Achille-92/CRAC2026/Algorithmes/Camera/MaVersion/calibration_images/WIN_20251208_12_06_43_Pro.jpg

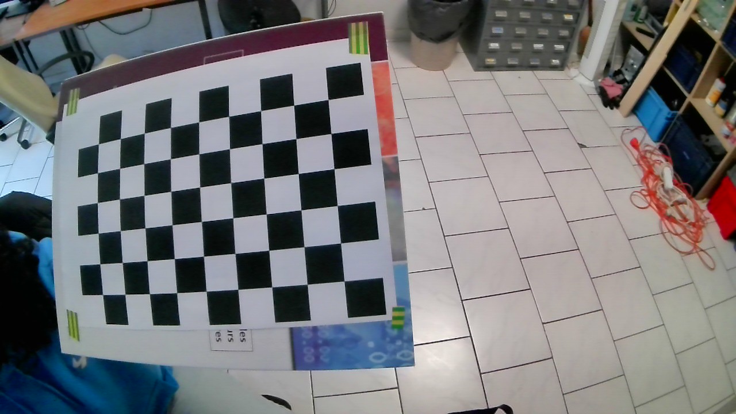
Algorithmes/Camera/MaVersion/calibration_images/WIN_20251208_12_06_43_Pro.jpg
