Achille-92/CRAC2026/Carte_Alim/Prog_Carte_puissance_crac/README.md

## Rapport

[Rapport_ERS3_Bryan_ZHANG.pdf](https://github.com/user-attachments/files/18724378/Rapport_ERS3_Bryan_ZHANG.pdf)

## KiCad de la carte

https://drive.google.com/file/d/13JI4LmcO5JpdWw6Ys9MJsPXT3uxtk39C/view?usp=drive_link
