Achille-92/CRAC2026/Autre/RPI/Piste.png

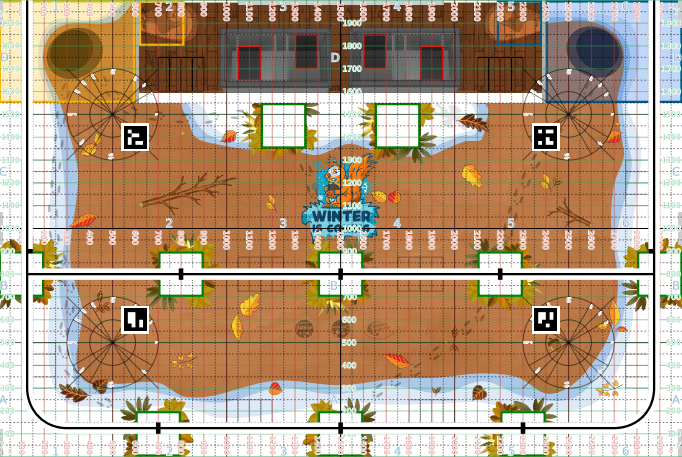
Autre/RPI/Piste.png
