Achille-92/CRAC2026/Carte_Alim/Prog_Carte_puissance_crac/Kicad Carte_puissance_crac_Indus/ALTIUM_EMBEDDED_MODELS/User Library-SOIC-8-1.STEP

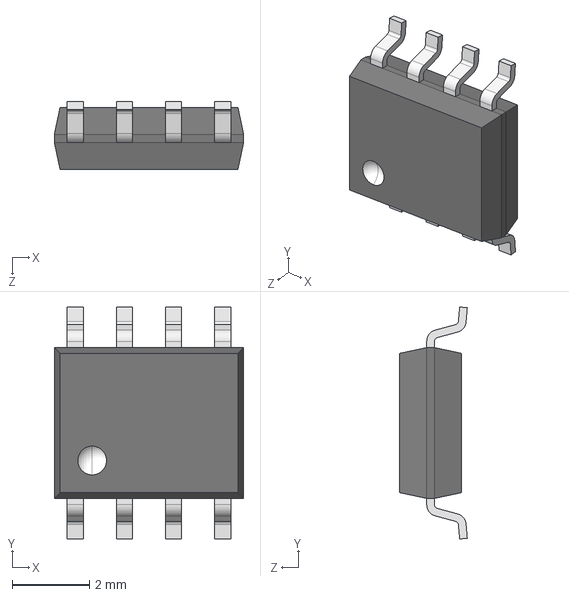
[picture p29: CAD file, 2026-09-27]
Carte_Alim/Prog_Carte_puissance_crac/Kicad Carte_puissance_crac_Indus/ALTIUM_EMBEDDED_MODELS/User Library-SOIC-8-1.STEP
4.90 x 6.00 x 1.75 mm
