Achille-92/CRAC2026/Carte_Alim/Prog_Carte_puissance_crac/Kicad Carte_puissance_crac_Indus/lib_TSR-2-2450/3D/TSR_2-2450.step

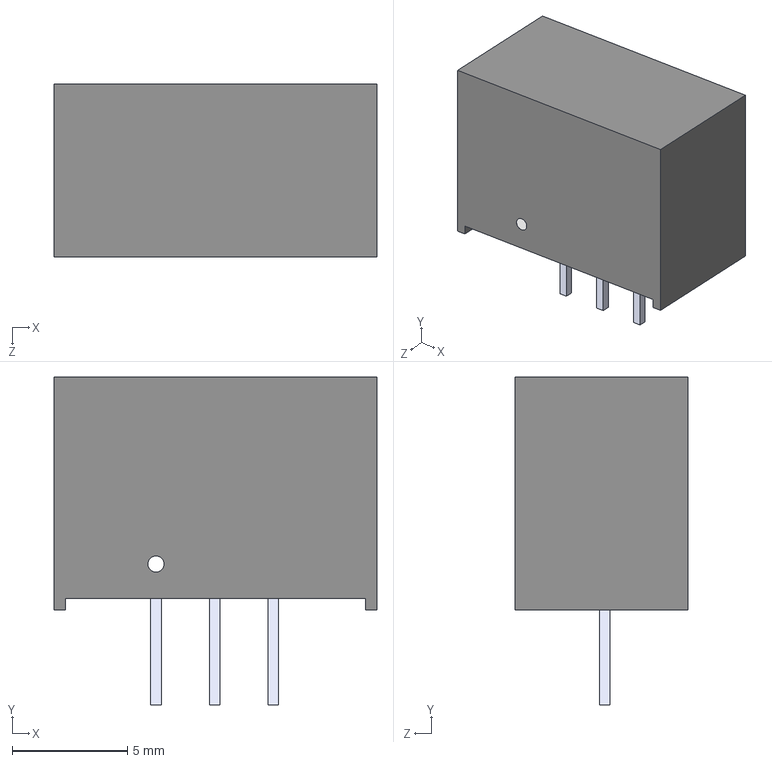
[picture p30: CAD file, 2026-09-29]
Carte_Alim/Prog_Carte_puissance_crac/Kicad Carte_puissance_crac_Indus/lib_TSR-2-2450/3D/TSR_2-2450.step
14.0 x 14.2 x 7.50 mm
