Achille-92/CRAC2026/Carte_Alim/Prog_Carte_puissance_crac/Kicad Carte_puissance_crac_Indus/LibGamelGe2_v6/3D/LED5mm_green.STEP

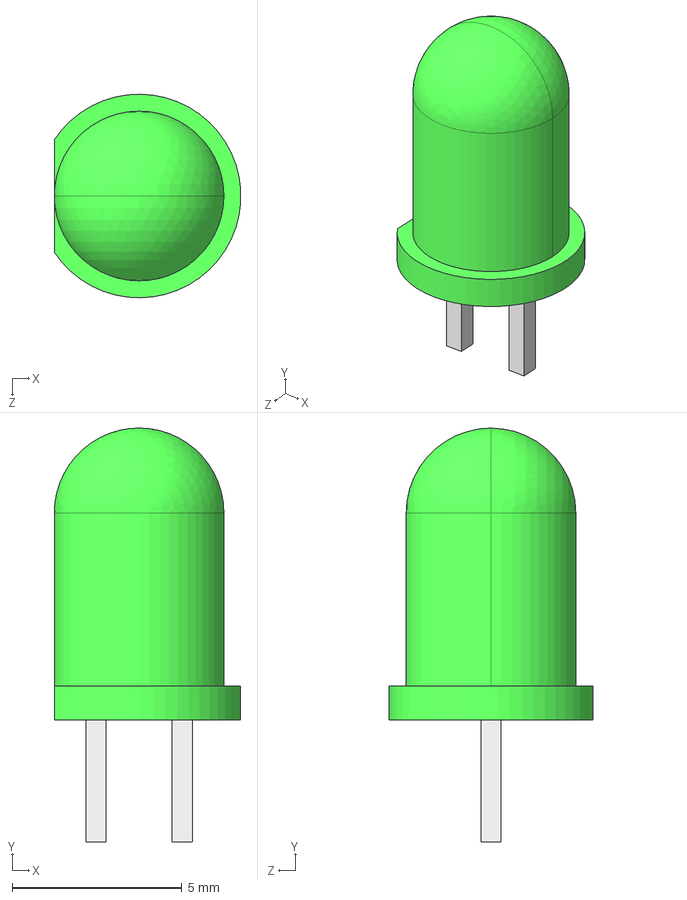
[picture p31: CAD file, 2026-09-27]
Carte_Alim/Prog_Carte_puissance_crac/Kicad Carte_puissance_crac_Indus/LibGamelGe2_v6/3D/LED5mm_green.STEP
5.49 x 12.2 x 6.00 mm
