Achille-92/CRAC2026/Carte_Alim/Prog_Carte_puissance_crac/Kicad Carte_puissance_crac_Indus/LibGe2/3D/pololu-2507.STEP

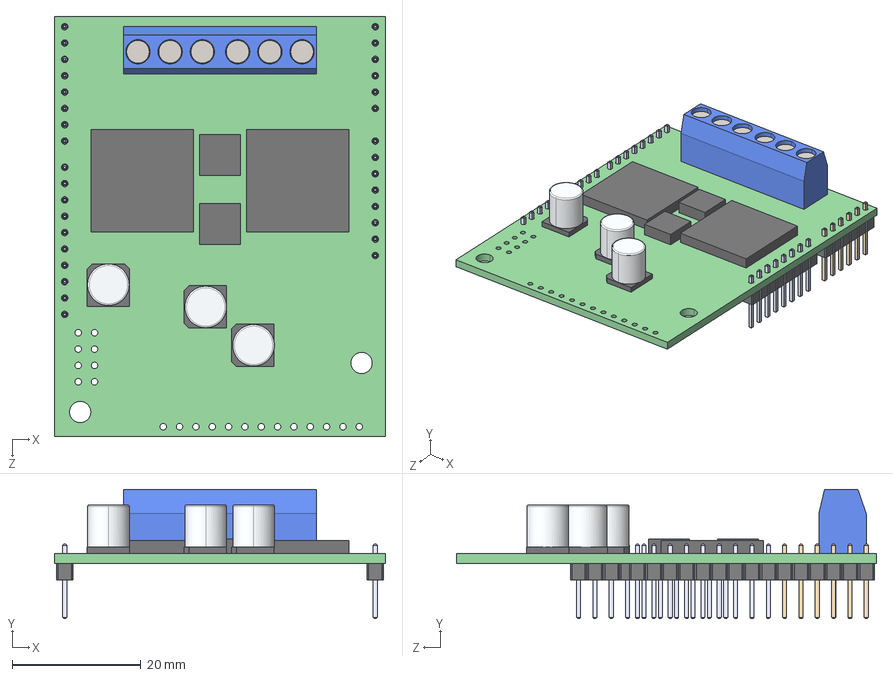
[picture p32: CAD file, 2026-09-27]
Carte_Alim/Prog_Carte_puissance_crac/Kicad Carte_puissance_crac_Indus/LibGe2/3D/pololu-2507.STEP
51.4 x 20.0 x 65.3 mm
Pololu VNH5019 Motor Driver
PinHeader_1x06_P2.54mm_Vertical.step
PinHeader_1x08_P2.54mm_Vertical.step x 2
PinHeader_1x10_P2.54mm_Vertical.step
