Achille-92/CRAC2026/Carte_Alim/Prog_Carte_puissance_crac/Kicad Carte_puissance_crac_Indus/SQM40031EL_GE3/TO-236_D2PAK__VIS.step

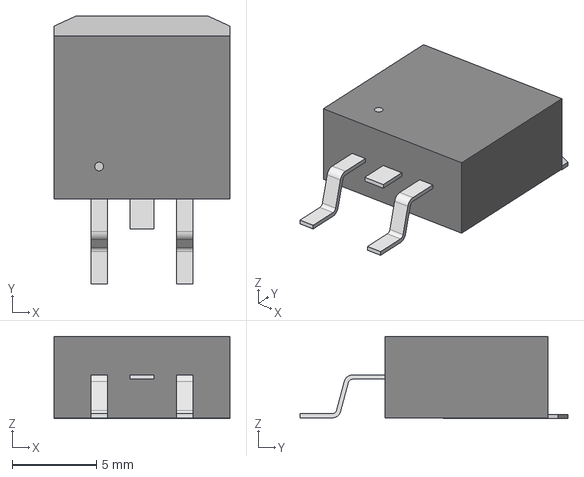
[picture p33: CAD file, 2026-09-29]
Carte_Alim/Prog_Carte_puissance_crac/Kicad Carte_puissance_crac_Indus/SQM40031EL_GE3/TO-236_D2PAK__VIS.step
10.4 x 15.9 x 4.88 mm
