Achille-92/CRAC2026/Carte_Alim/Prog_Carte_puissance_crac/Kicad Carte_puissance_crac_Indus/STM32F303K8T6/STM32F303K8T6.step

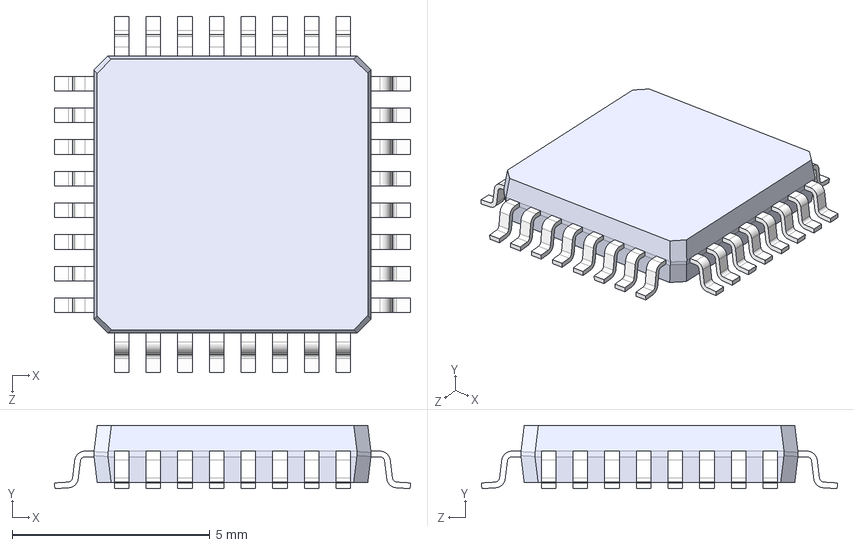
[picture p34: CAD file, 2026-09-27]
Carte_Alim/Prog_Carte_puissance_crac/Kicad Carte_puissance_crac_Indus/STM32F303K8T6/STM32F303K8T6.step
9.00 x 1.60 x 9.00 mm
