Achille-92/CRAC2026/Carte_Alim/Prog_Carte_puissance_crac/Kicad Carte_puissance_crac_Indus/STSPIN820/STSPIN820.step

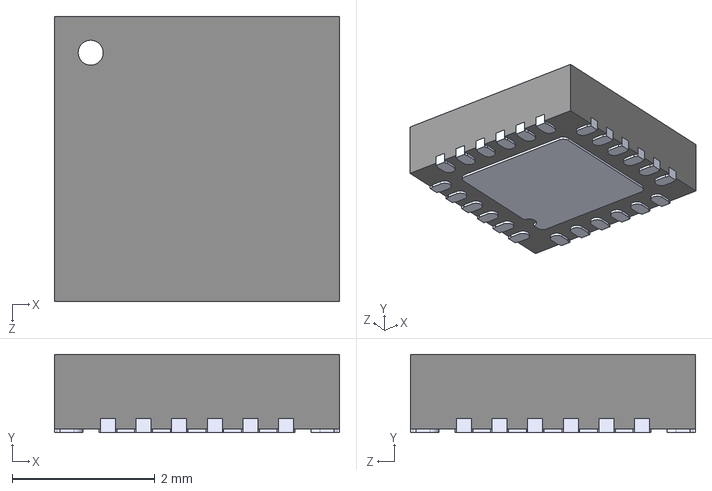
[picture p35: CAD file, 2026-09-27]
Carte_Alim/Prog_Carte_puissance_crac/Kicad Carte_puissance_crac_Indus/STSPIN820/STSPIN820.step
4.00 x 1.10 x 4.00 mm
