Achille-92/CRAC2026/Prog_Actionneurs/Kicad/CarteMPPIndus/EVALSP820-XS--3DModel-STEP-269445.STEP

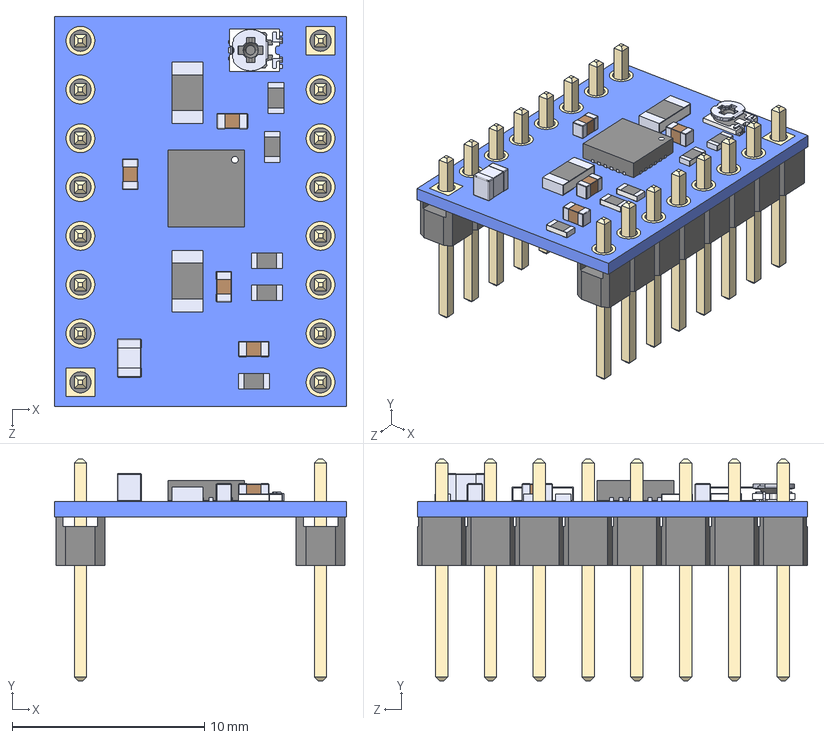
[picture p36: CAD file, 2026-09-27]
Prog_Actionneurs/Kicad/CarteMPPIndus/EVALSP820-XS--3DModel-STEP-269445.STEP
15.2 x 11.5 x 20.3 mm
EVALSP820-XS board
STSPIN820_STSPIN820
61300811121.stp x 2
6130xx11121_PIN.stp x 16
TC42X-2-103E
Cap_GA0805Y473JBAAR31G
cap2 x 2
cap2_FC0603E50R0BTBT1 x 5
Cap_VJ0603Q3R9BXBAP x 4
