Achille-92/CRAC2026/Prog_Actionneurs/Kicad/Extension_Pompes/Extension_Pompes.step

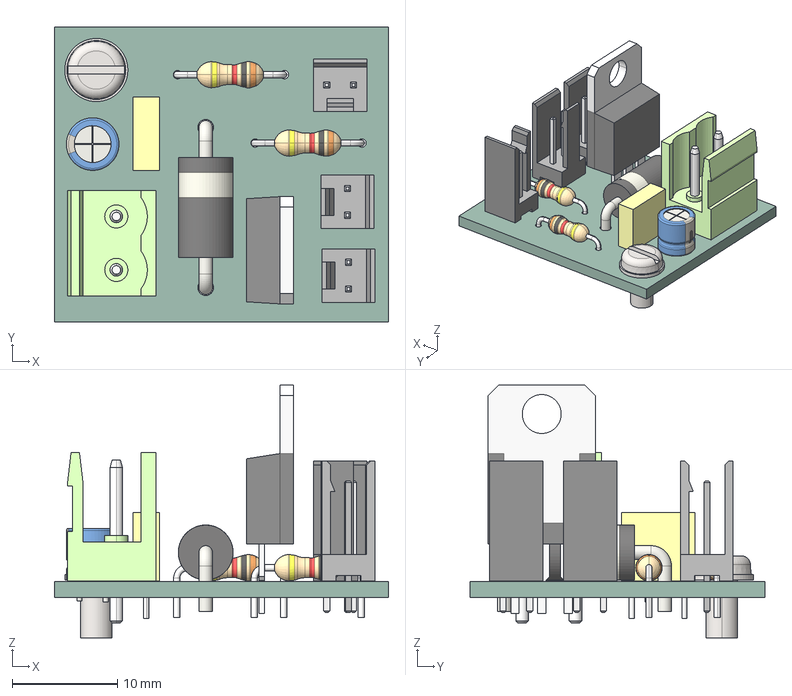
[picture p37: CAD file, 2026-09-27]
Prog_Actionneurs/Kicad/Extension_Pompes/Extension_Pompes.step
31.8 x 28.1 x 24.0 mm
C_Rect_L7.0mm_W2.5mm_P5.00mm
OmnimateSL_1x02
slotted pan head screw_iso_ISO 1580 - M3 x 6 - 6N
plain washer small grade a_iso_Washer ISO 7092 - 3
D_DO-201AD_P15.24mm_Horizontal
autocom2 x 3
CP_Radial_D5.0mm_P2.50mm
R_Axial_L6.3mm_D2.5mm_P10.16mm_Horizontal x 2
TO220_vertical
Extension_Pompes_PCB
