Achille-92/CRAC2026/Carte_Alim/Prog_Carte_puissance_crac/Kicad Carte_puissance_crac_Indus/ALTIUM_EMBEDDED_MODELS/SW3dPS-SOT-223-1.STEP

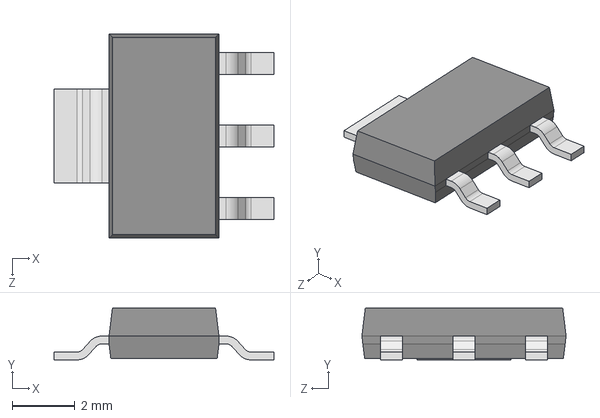
[picture p38: CAD file, 2026-09-27]
Carte_Alim/Prog_Carte_puissance_crac/Kicad Carte_puissance_crac_Indus/ALTIUM_EMBEDDED_MODELS/SW3dPS-SOT-223-1.STEP
7.00 x 1.65 x 6.50 mm
