Achille-92/CRAC2026/Carte_Alim/Prog_Carte_puissance_crac/Kicad Carte_puissance_crac_Indus/LibGamelGe2_v6/3D/R_Axial_L6.3mm_D2.5mm_P10.16mm_Horizontal.STEP

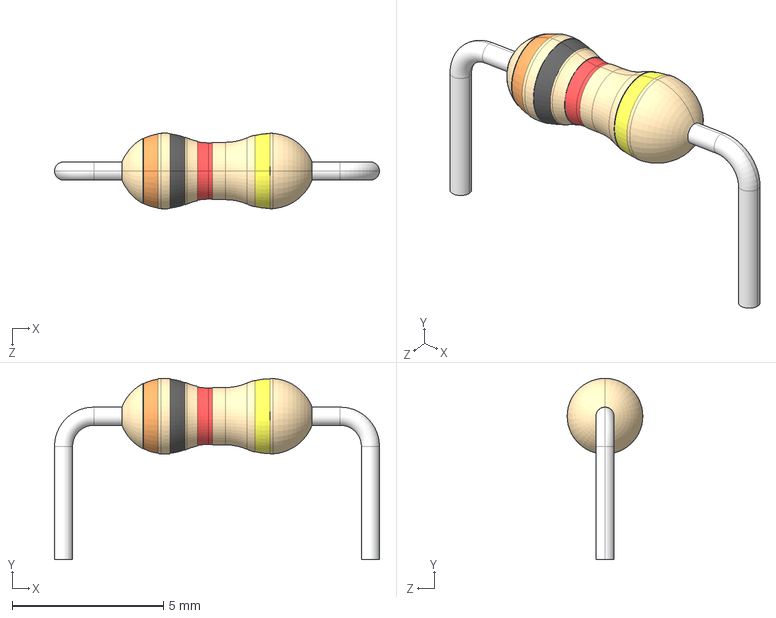
[picture p39: CAD file, 2026-09-27]
Carte_Alim/Prog_Carte_puissance_crac/Kicad Carte_puissance_crac_Indus/LibGamelGe2_v6/3D/R_Axial_L6.3mm_D2.5mm_P10.16mm_Horizontal.STEP
10.8 x 6.00 x 2.51 mm
