Achille-92/CRAC2026/Prog_Actionneurs/Kicad/CarteMPPIndus/CarteMPP.step

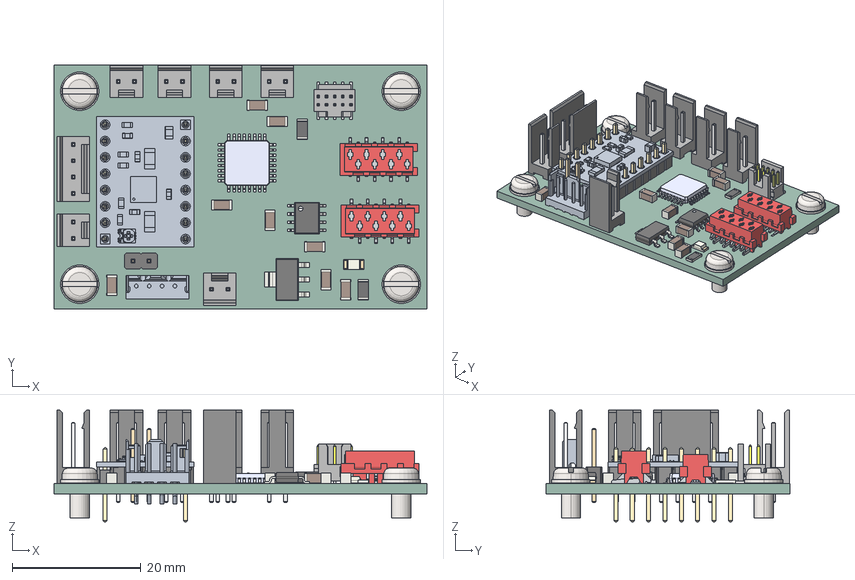
[picture p40: CAD file, 2026-09-27]
Prog_Actionneurs/Kicad/CarteMPPIndus/CarteMPP.step
58.0 x 38.0 x 17.4 mm
SOT_223
C_1206_3216Metric x 8
User Library-SOIC-8-1
C-0188275-08-3 x 2
PinHeader_1x02_P254mm_Vertical
Screw_3mm x 4
autocom2 x 6
R_1206_3216Metric x 2
LED_1206_3216Metric
autocom4
EVALSP820-XS
STM32L011K4T6
FTSH-105-01-L-DV-K
CarteMPP_PCB
