Achille-92/CRAC2026/Carte_Alim/Prog_Carte_puissance_crac/Kicad Carte_puissance_crac_Indus/ALTIUM_EMBEDDED_MODELS/0603 SMD Resistor.stp

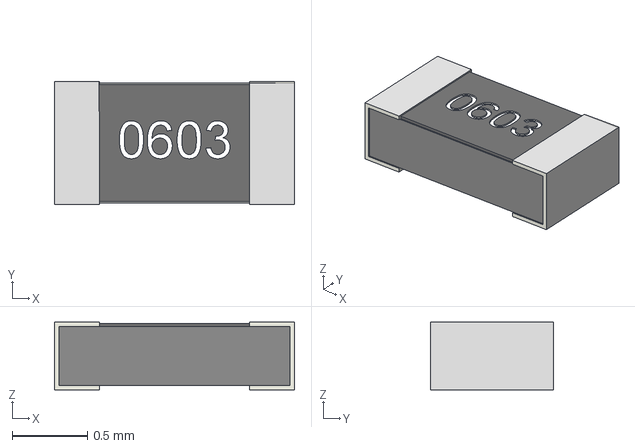
[picture p41: CAD file, 2026-09-27]
Carte_Alim/Prog_Carte_puissance_crac/Kicad Carte_puissance_crac_Indus/ALTIUM_EMBEDDED_MODELS/0603 SMD Resistor.stp
1.60 x 0.82 x 0.45 mm
