Achille-92/CRAC2026/Carte_Alim/Prog_Carte_puissance_crac/Kicad Carte_puissance_crac_Indus/LibGamelGe2_v6/3D/autocom2.STEP

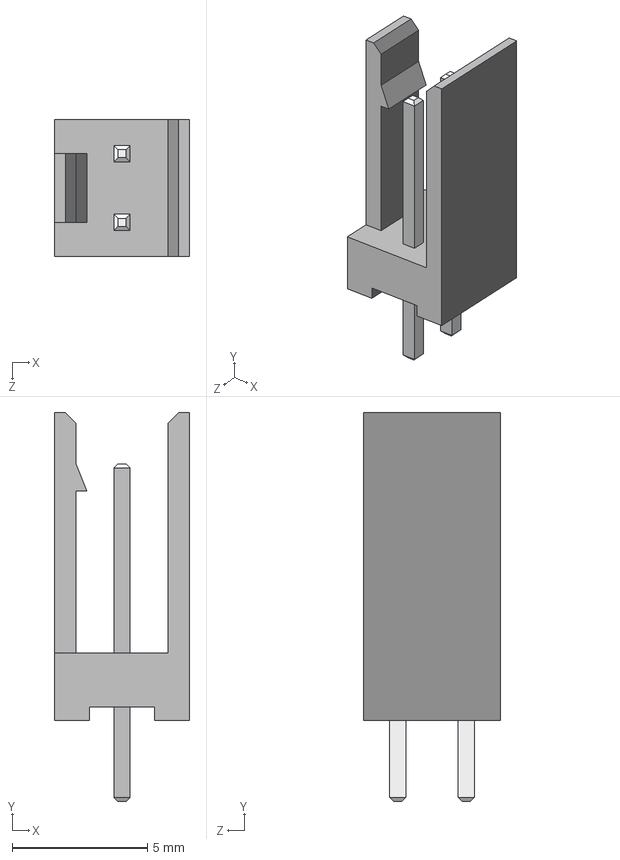
[picture p42: CAD file, 2026-09-27]
Carte_Alim/Prog_Carte_puissance_crac/Kicad Carte_puissance_crac_Indus/LibGamelGe2_v6/3D/autocom2.STEP
5.00 x 14.4 x 5.08 mm
