Achille-92/CRAC2026/Carte_Alim/Prog_Carte_puissance_crac/Solidwork Boite carte puissance/Carte_puissance_crac_v2.step

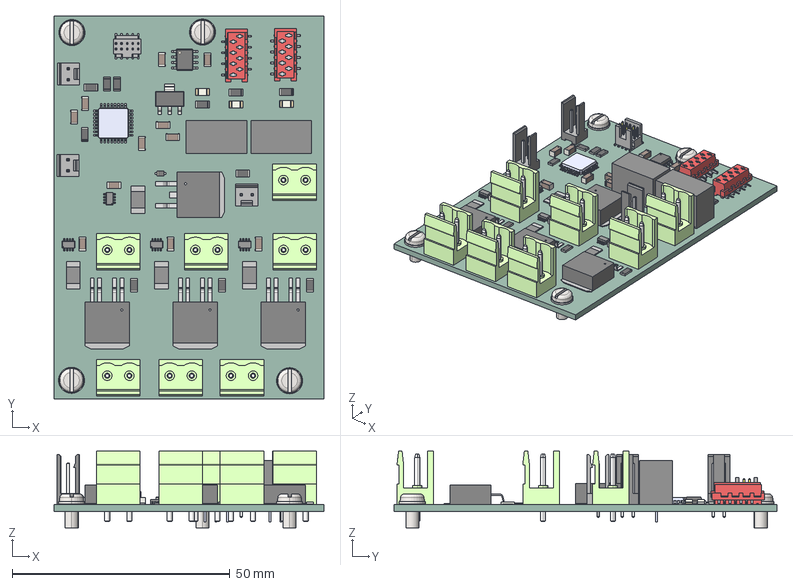
[picture p43: CAD file, 2026-09-29]
Carte_Alim/Prog_Carte_puissance_crac/Solidwork Boite carte puissance/Carte_puissance_crac_v2.step
62.0 x 88.0 x 17.6 mm
R_1206_3216Metric x 11
Screw_3mm x 4
ASSEMBLY x 4
C_1206_3216Metric x 11
SOIC_8_39x49mm_P127mm
TSR 2-2450 x 2
C-0188275-08-3 x 2
autocom2 x 3
OmnimateSL_1x02 x 7
FTSH-105-01-L-DV-K
CSNL2512_5L00 x 4
D_SOD_323F
SOT_223
LED_1206_3216Metric x 3
STM32L011K4T6
Carte_puissance_crac_v2_PCB
