Achille-92/CRAC2026/Carte_Alim/Prog_Carte_puissance_crac/Kicad Carte_puissance_crac_Indus/ALTIUM_EMBEDDED_MODELS/LED 0603.STEP

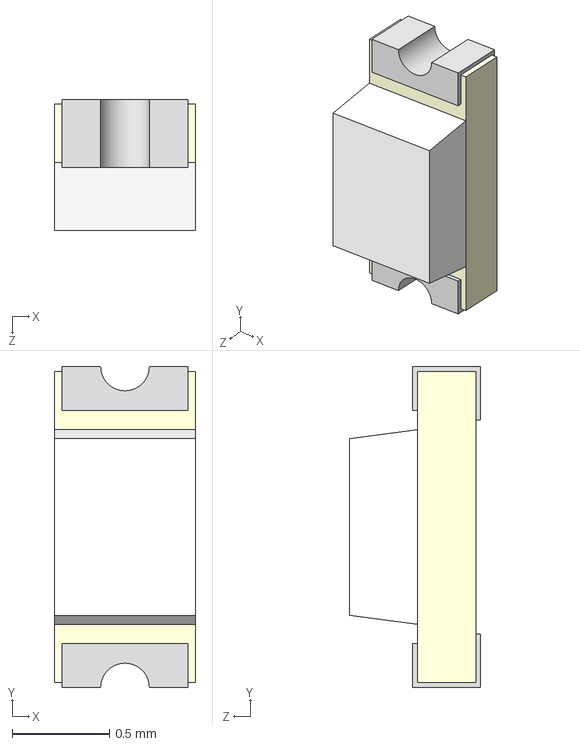
[picture p44: CAD file, 2026-09-27]
Carte_Alim/Prog_Carte_puissance_crac/Kicad Carte_puissance_crac_Indus/ALTIUM_EMBEDDED_MODELS/LED 0603.STEP
0.725 x 1.65 x 0.675 mm
