Achille-92/CRAC2026/Carte_Alim/Prog_Carte_puissance_crac/Kicad Carte_puissance_crac_Indus/LibGamelGe2_v6/3D/Potentiometer_Vertical.STEP

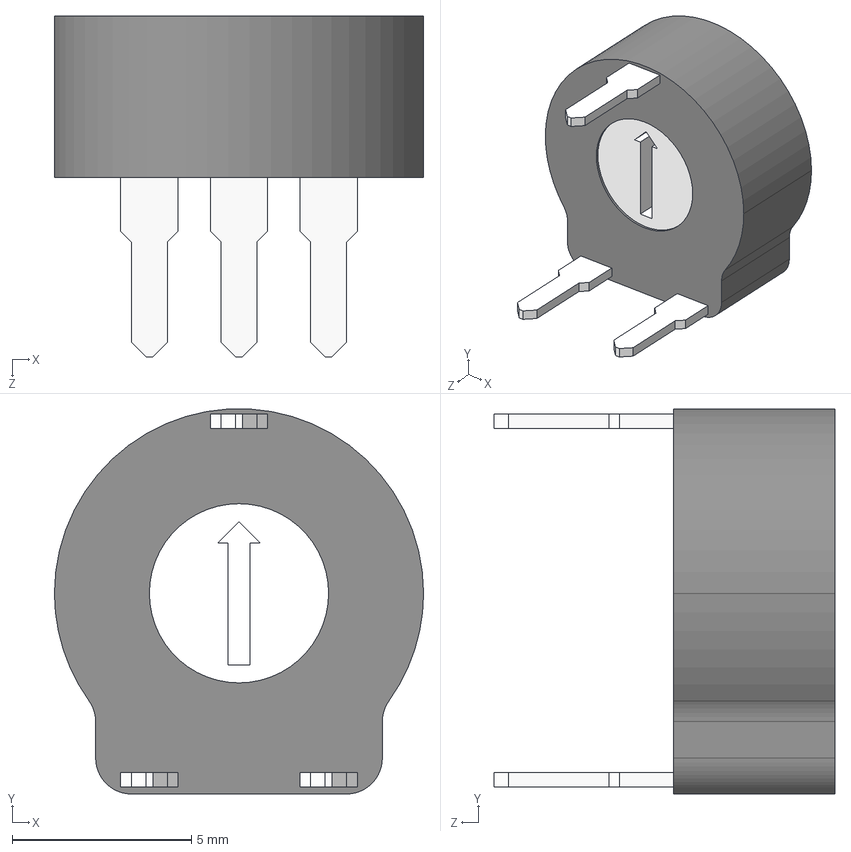
[picture p45: CAD file, 2026-09-27]
Carte_Alim/Prog_Carte_puissance_crac/Kicad Carte_puissance_crac_Indus/LibGamelGe2_v6/3D/Potentiometer_Vertical.STEP
10.3 x 10.7 x 9.50 mm
