Achille-92/CRAC2026/Carte_Alim/Prog_Carte_puissance_crac/Kicad Carte_puissance_crac_Indus/LibGe2/3D/Grove Connector (flat).STEP

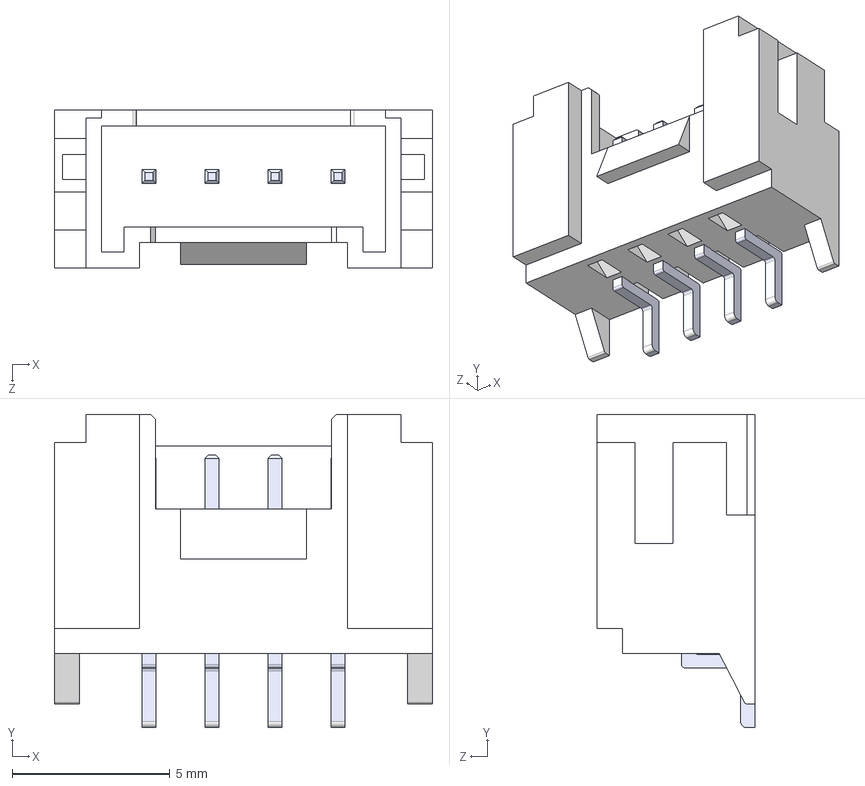
[picture p46: CAD file, 2026-09-27]
Carte_Alim/Prog_Carte_puissance_crac/Kicad Carte_puissance_crac_Indus/LibGe2/3D/Grove Connector (flat).STEP
12.0 x 9.95 x 5.00 mm
