Achille-92/CRAC2026/Carte_Alim/Prog_Carte_puissance_crac/Solidwork Boite carte puissance/Boitier_Carte_puissance.SLDPRT

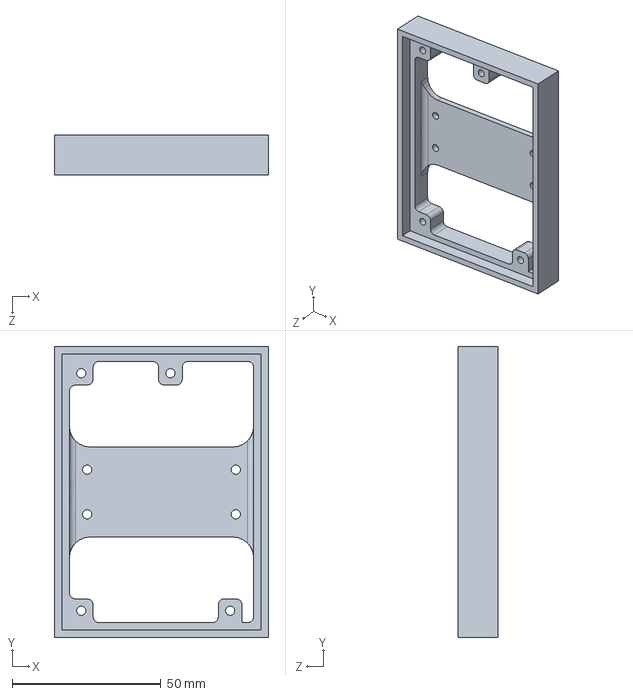
[picture p47: CAD file, 2026-09-29]
Carte_Alim/Prog_Carte_puissance_crac/Solidwork Boite carte puissance/Boitier_Carte_puissance.SLDPRT
72.0 x 97.9 x 13.4 mm
