Achille-92/CRAC2026/Carte_Alim/Prog_Carte_puissance_crac/Kicad Carte_puissance_crac_Indus/ALTIUM_EMBEDDED_MODELS/Embase Micromatch Femelle CMS 8pts.stp

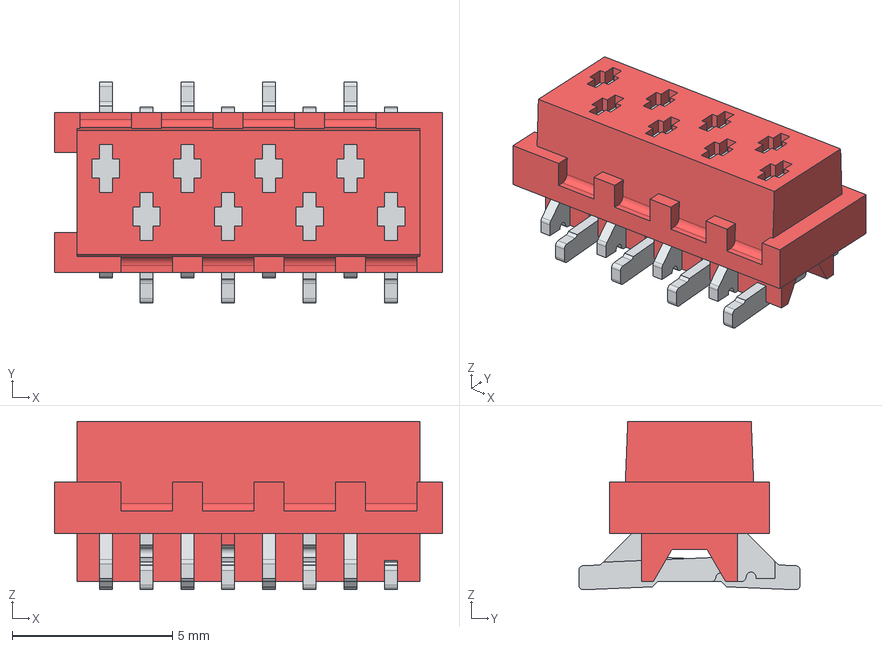
[picture p48: CAD file, 2026-09-27]
Carte_Alim/Prog_Carte_puissance_crac/Kicad Carte_puissance_crac_Indus/ALTIUM_EMBEDDED_MODELS/Embase Micromatch Femelle CMS 8pts.stp
12.1 x 6.90 x 5.25 mm
