Achille-92/CRAC2026/Carte_Alim/Prog_Carte_puissance_crac/Kicad Carte_puissance_crac_Indus/LibGamelGe2_v6/3D/autocom4.STEP

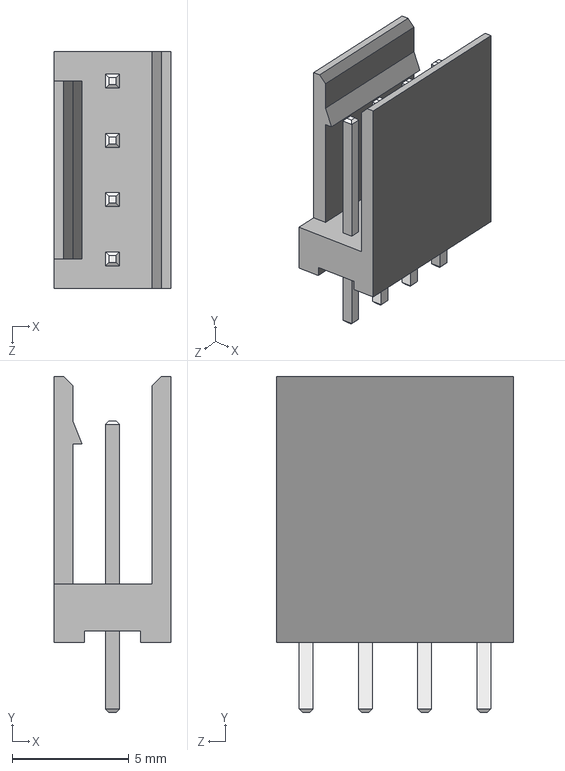
[picture p49: CAD file, 2026-09-27]
Carte_Alim/Prog_Carte_puissance_crac/Kicad Carte_puissance_crac_Indus/LibGamelGe2_v6/3D/autocom4.STEP
5.00 x 14.4 x 10.2 mm
