Achille-92/CRAC2026/Carte_Alim/Prog_Carte_puissance_crac/Kicad Carte_puissance_crac_Indus/LibGe2/3D/ESP32-DEVKITC-32D.step

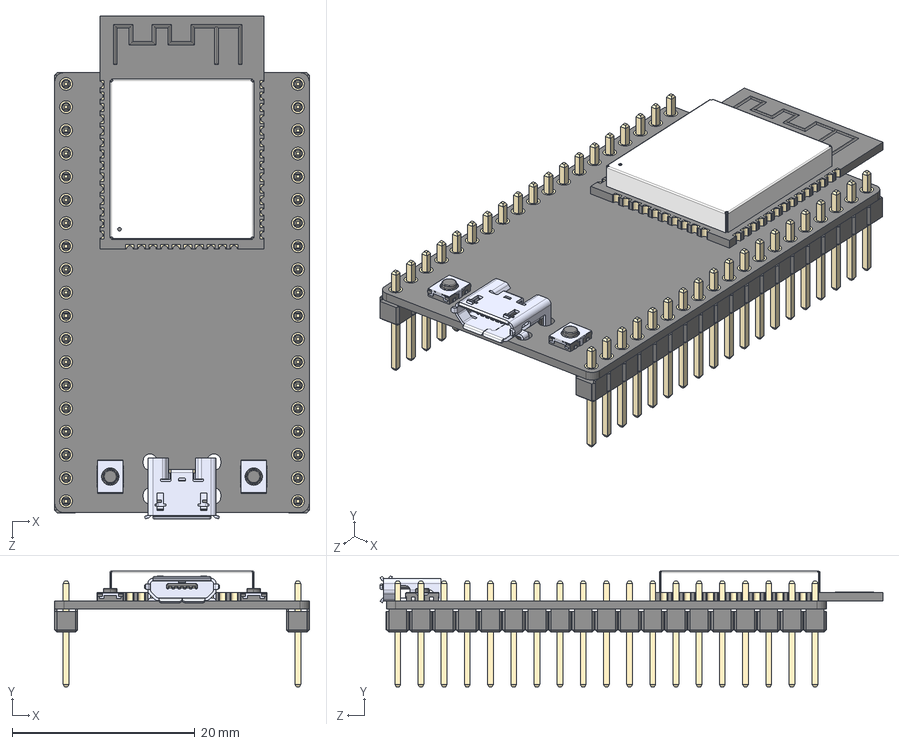
[picture p50: CAD file, 2026-09-27]
Carte_Alim/Prog_Carte_puissance_crac/Kicad Carte_puissance_crac_Indus/LibGe2/3D/ESP32-DEVKITC-32D.step
27.9 x 12.7 x 55.1 mm
board
header x 2
ESP32-WROOM-32D
micro usb
button x 2
