Achille-92/CRAC2026/Carte_Alim/Prog_Carte_puissance_crac/Kicad Carte_puissance_crac_Indus/LibGe2/3D/Grove Connector (standing).STEP

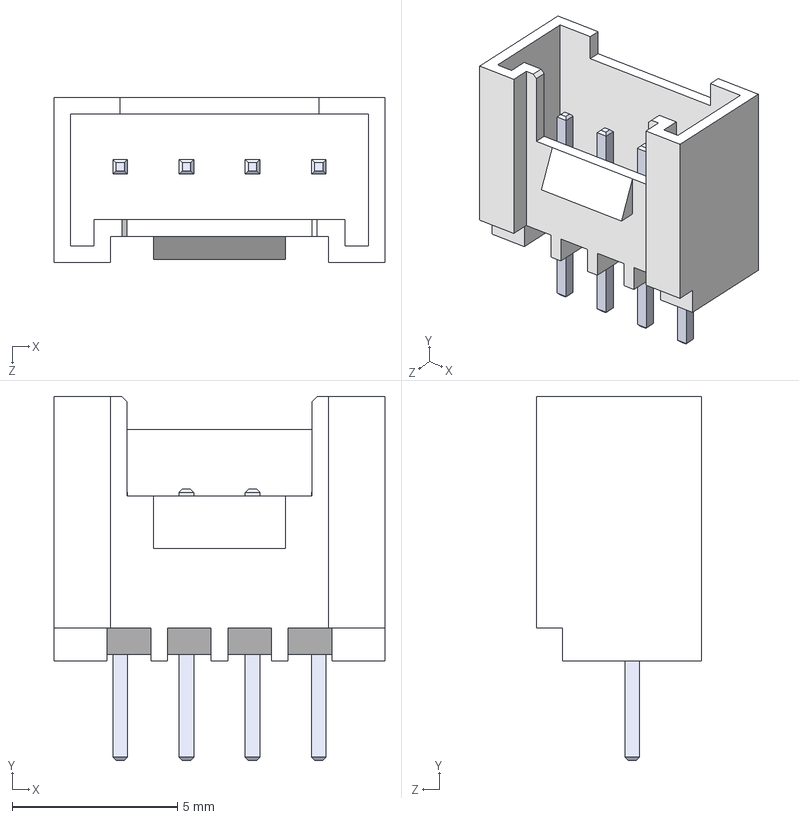
[picture p53: CAD file, 2026-09-27]
Carte_Alim/Prog_Carte_puissance_crac/Kicad Carte_puissance_crac_Indus/LibGe2/3D/Grove Connector (standing).STEP
10.0 x 11.0 x 5.00 mm
