Achille-92/CRAC2026/Carte_Alim/Prog_Carte_puissance_crac/Kicad Carte_puissance_crac_Indus/LibGe2/3D/THN_15-1211N.step

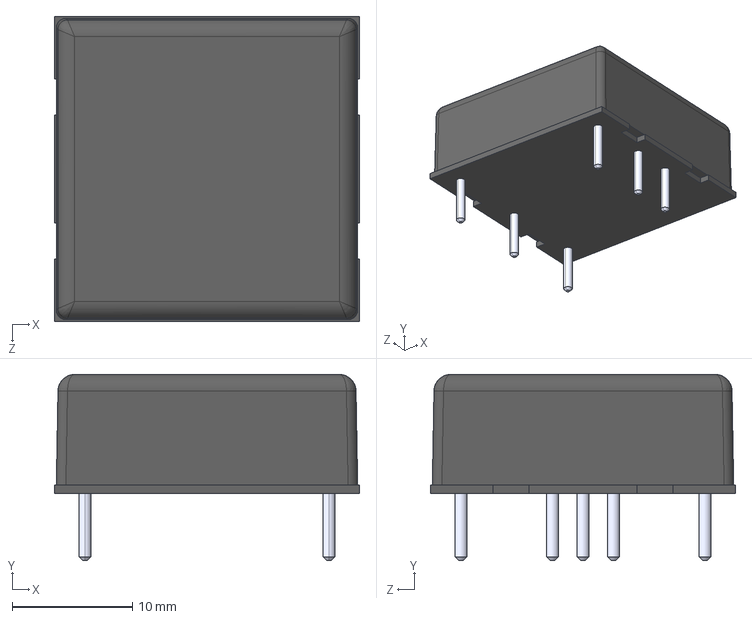
[picture p56: CAD file, 2026-09-27]
Carte_Alim/Prog_Carte_puissance_crac/Kicad Carte_puissance_crac_Indus/LibGe2/3D/THN_15-1211N.step
25.4 x 15.5 x 25.4 mm
