Achille-92/CRAC2026/Carte_Alim/Prog_Carte_puissance_crac/Kicad Carte_puissance_crac_Indus/LibGe2/3D/NUCLEO-F303K8.step

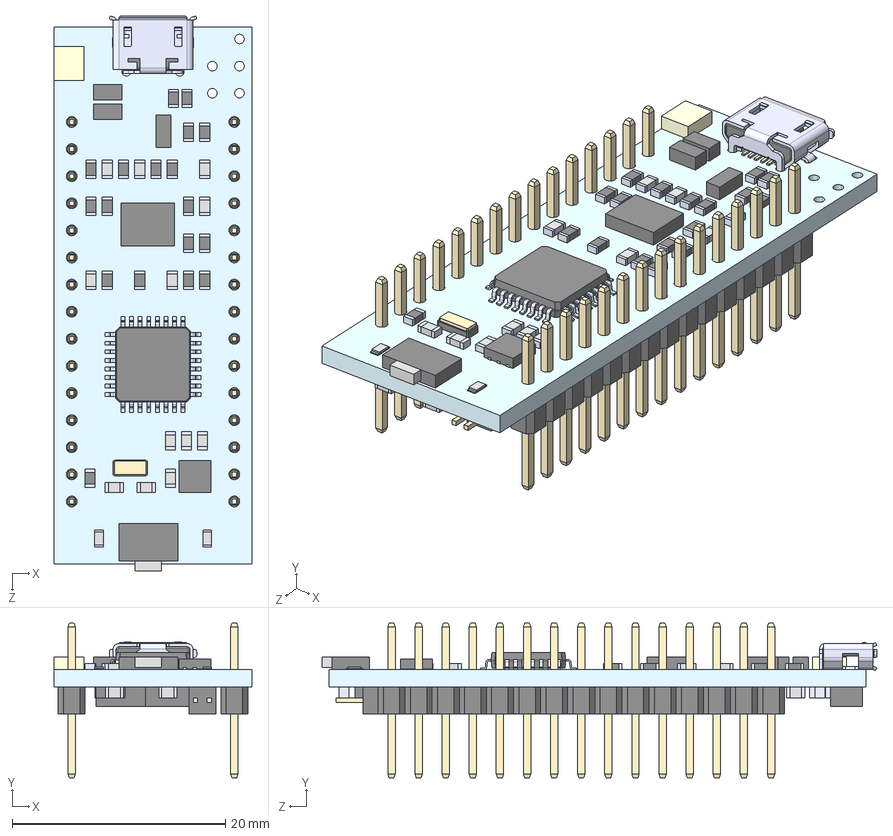
[picture p61: CAD file, 2026-09-27]
Carte_Alim/Prog_Carte_puissance_crac/Kicad Carte_puissance_crac_Indus/LibGe2/3D/NUCLEO-F303K8.step
18.5 x 14.5 x 52.0 mm
mb1180c
LD39050PU33R-Nucleo
STM32F103CBT6-nucleo
header x2
lqpf1
