Achille-92/CRAC2026/Carte_Alim/Prog_Carte_puissance_crac/Kicad Carte_puissance_crac_Indus/LibGamelGe2_v6/3D/C_Rect_L28.0mm_W8.0mm_P22.50mm.STEP

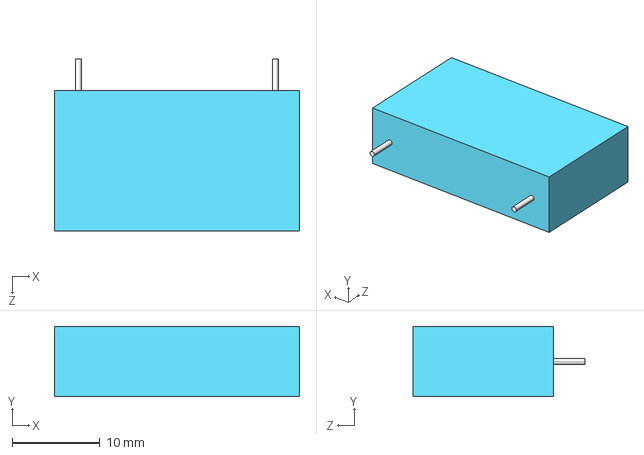
[picture p62: CAD file, 2026-09-27]
Carte_Alim/Prog_Carte_puissance_crac/Kicad Carte_puissance_crac_Indus/LibGamelGe2_v6/3D/C_Rect_L28.0mm_W8.0mm_P22.50mm.STEP
28.0 x 8.00 x 19.6 mm
