Achille-92/CRAC2026/Carte_Alim/Prog_Carte_puissance_crac/Kicad Carte_puissance_crac_Indus/LibGamelGe2_v6/3D/C_Rect_L4.0mm_W2.5mm_P2.50mm.STEP

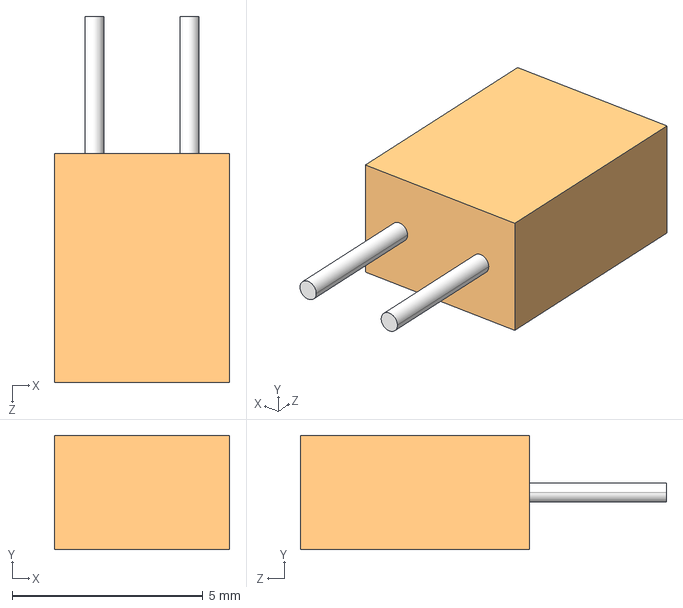
[picture p65: CAD file, 2026-09-27]
Carte_Alim/Prog_Carte_puissance_crac/Kicad Carte_puissance_crac_Indus/LibGamelGe2_v6/3D/C_Rect_L4.0mm_W2.5mm_P2.50mm.STEP
4.60 x 3.00 x 9.60 mm
