Achille-92/CRAC2026/Carte_Alim/Prog_Carte_puissance_crac/Kicad Carte_puissance_crac_Indus/LibGamelGe2_v6/3D/C_Rect_L10.0mm_W3.0mm_P7.50mm.STEP

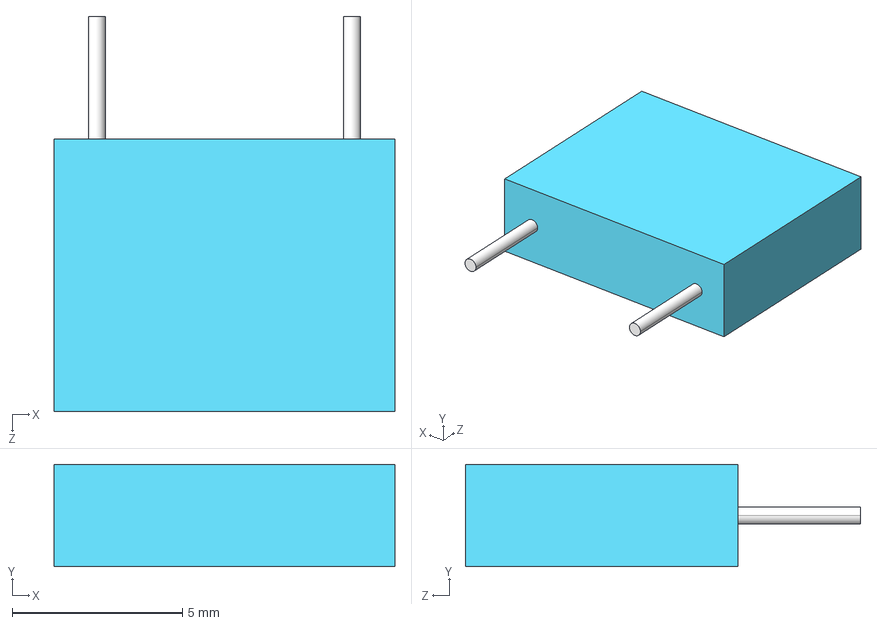
[picture p69: CAD file, 2026-09-27]
Carte_Alim/Prog_Carte_puissance_crac/Kicad Carte_puissance_crac_Indus/LibGamelGe2_v6/3D/C_Rect_L10.0mm_W3.0mm_P7.50mm.STEP
10.0 x 3.00 x 11.6 mm
