Achille-92/CRAC2026/Carte_Alim/Prog_Carte_puissance_crac/Kicad Carte_puissance_crac_Indus/LibGamelGe2_v6/3D/C_Rect_L13.0mm_W5.0mm_P10.00mm.STEP

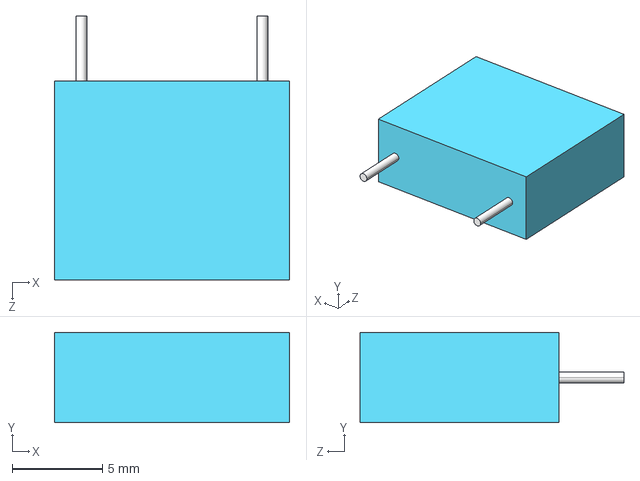
[picture p75: CAD file, 2026-09-27]
Carte_Alim/Prog_Carte_puissance_crac/Kicad Carte_puissance_crac_Indus/LibGamelGe2_v6/3D/C_Rect_L13.0mm_W5.0mm_P10.00mm.STEP
13.0 x 5.00 x 14.6 mm
