Achille-92/CRAC2026/Carte_Alim/Prog_Carte_puissance_crac/Kicad Carte_puissance_crac_Indus/LibGamelGe2_v6/3D/C_Rect_L7.0mm_W2.5mm_P5.00mm.STEP

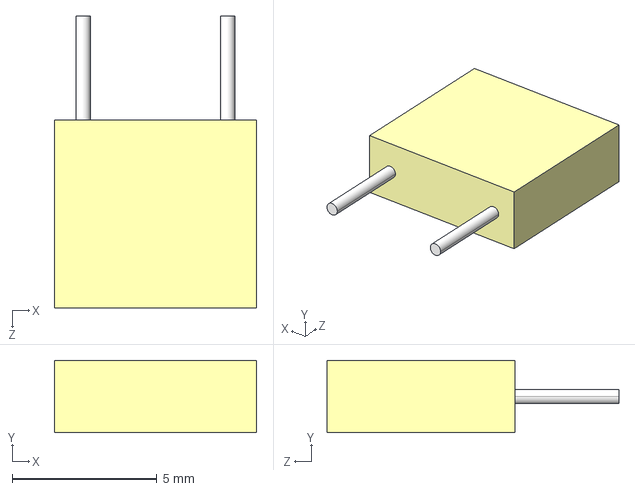
[picture p76: CAD file, 2026-09-27]
Carte_Alim/Prog_Carte_puissance_crac/Kicad Carte_puissance_crac_Indus/LibGamelGe2_v6/3D/C_Rect_L7.0mm_W2.5mm_P5.00mm.STEP
7.00 x 2.50 x 10.1 mm
