Achille-92/CRAC2026/Carte_Alim/Prog_Carte_puissance_crac/Solidwork Boite carte puissance/Assemblage carte puissance 2025.SLDASM

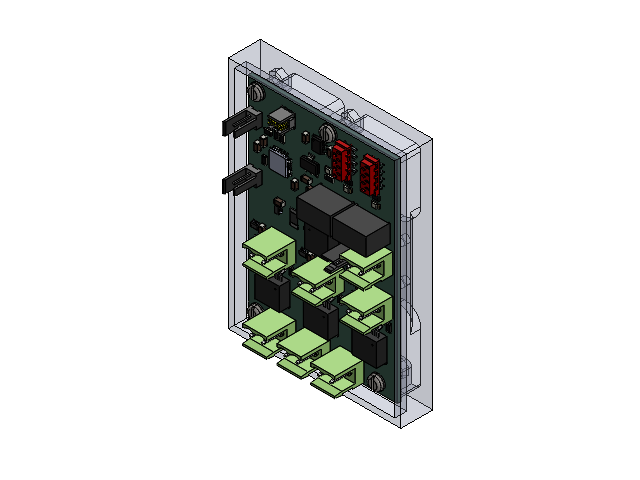
[picture p80: CAD file, 2026-09-29]
Carte_Alim/Prog_Carte_puissance_crac/Solidwork Boite carte puissance/Assemblage carte puissance 2025.SLDASM
R_1206_3216Metric-0_1.step x 11
Screw_3mm-1_1.step x 4
ASSEMBLY_1.step x 4
C_1206_3216Metric-2_1.step x 11
SOIC_8_39x49mm_P127mm_1.step
TSR 2-2450_1.step x 2
C-0188275-08-3_1.step x 2
autocom2-3_1.step x 3
OmnimateSL_1x02-4_1.step x 7
part_1.step x 3
FTSH-105-01-L-DV-K-5_1.step
part-6_1.step
CSNL2512_5L00_1.step x 4
D_SOD_323F_1.step
SOT_223_1.step
LED_1206_3216Metric-7_1.step x 3
STM32L011K4T6_1.step
Carte_puissance_crac_v2_PCB_1.step
Boitier_Carte_puissance
