Achille-92/CRAC2026/Algorithmes/Camera/MaVersion/calibration_images/WIN_20251208_12_07_06_Pro.jpg

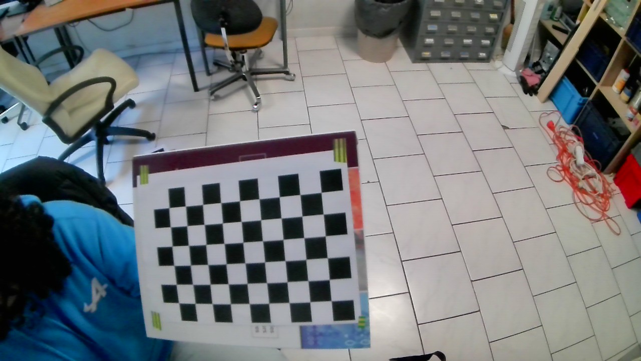
Algorithmes/Camera/MaVersion/calibration_images/WIN_20251208_12_07_06_Pro.jpg
