Achille-92/CRAC2026/Carte_Alim/Prog_Carte_puissance_crac/Kicad Carte_puissance_crac_Indus/Carte_puissance_crac_v2.kicad_pcb

## KiCad design Carte_Alim/Prog_Carte_puissance_crac/Kicad Carte_puissance_crac_Indus/Carte_puissance_crac_v2.kicad_pcb (2026-09-29)

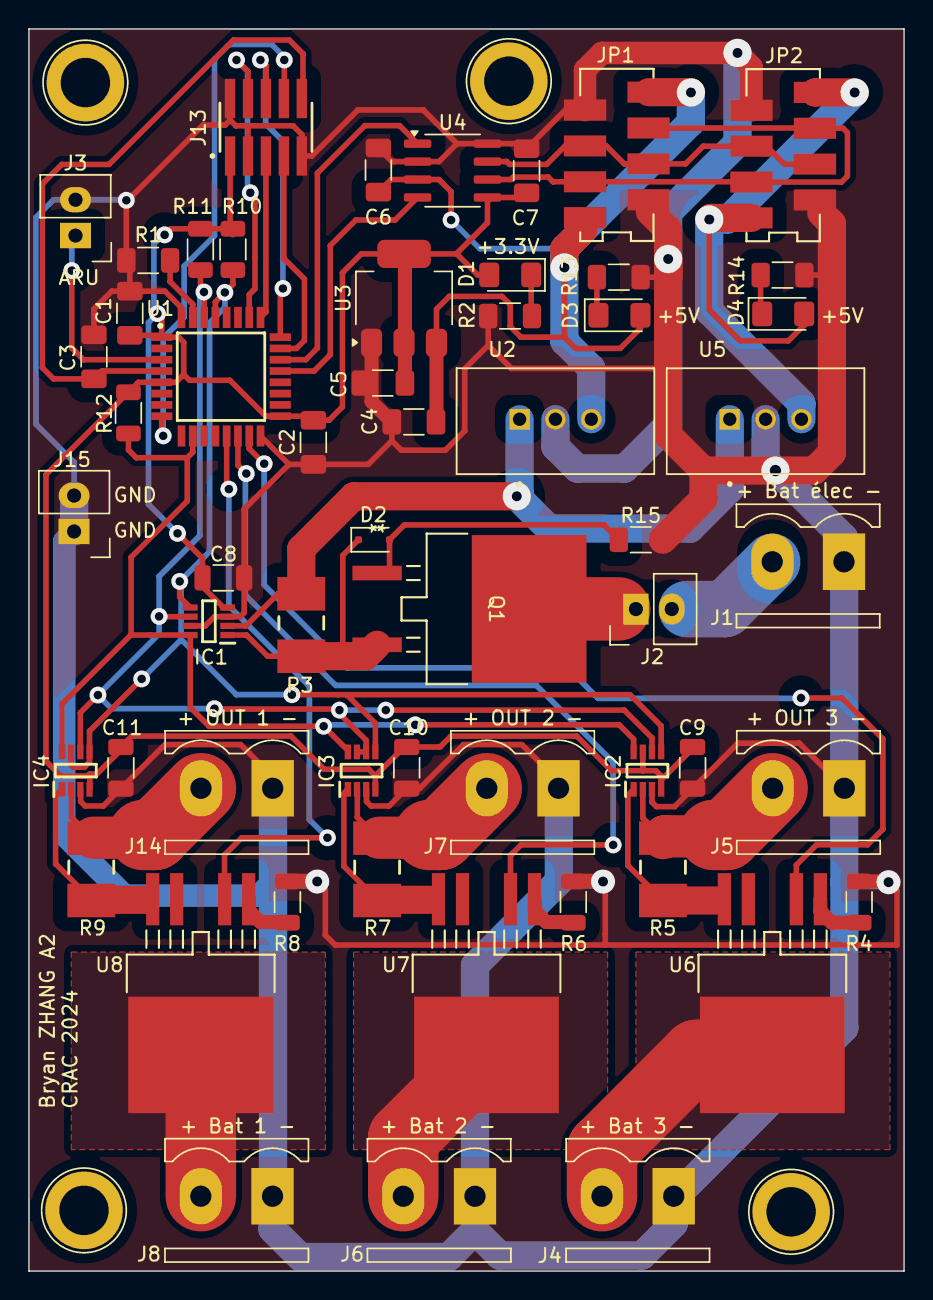
[picture p102: board Carte_puissance_crac_v2.kicad_pcb from above]

Board: 2 copper layers, 62.0 x 88.0 mm, 60 parts (0 on the bottom side), 42 nets.

Parts:
C1, C2, C3, C6, C7: 100nF; C_1206_3216Metric_Pad1.33x1.80mm_HandSolder
C4: 10uF; C_1206_3216Metric_Pad1.33x1.80mm_HandSolder
C5: 22uF; C_1206_3216Metric_Pad1.33x1.80mm_HandSolder
C8, C9, C10, C11: 0.1µ; C_1206_3216Metric
D1, D3, D4: LED; LED_1206_3216Metric_Pad1.42x1.75mm_HandSolder
D2: D_Zener; D_SOD-323F
IC1, IC2, IC3, IC4: INA236AIDDFR; SOP65P280X110-8N
J1, J4, J5, J6, J7, J8, J14: Omnimate2; OmnimateSL-5,08_1x02_P5.08mm_Vertical
J2, J3, J15: Autocom2
J9, J10, J11, J12: Mounting_Screw_3mm
J13: FTSH-105-01-L-DV-K; SAMTEC_FTSH-105-01-L-DV-K
JP1, JP2: Micromatch 8; SW_DIP_SPSTx04_Slide_9.78x12.34mm_W7.62mm_P2.54mm
Q1: SQM40031EL_GE3; TO-236D2PAK_VIS
R1: 10K; R_1206_3216Metric_Pad1.30x1.75mm_HandSolder
R2: 360; R_1206_3216Metric_Pad1.30x1.75mm_HandSolder
R3, R5, R7, R9: CSNL2512FT5L00
R4, R6, R8: 150; R_1206_3216Metric
R10, R11, R12: R_1206_3216Metric
R13, R14: 560; R_1206_3216Metric_Pad1.30x1.75mm_HandSolder
R15: 12k; R_1206_3216Metric_Pad1.30x1.75mm_HandSolder
U1: STM32F303K8T6; QFP80P900X900X160-32N
U2, U5: TSR_2-2450; CONV_TSR_2-2450
U3: AZ1117-3.3; SOT-223-3_TabPin2
U4: MCP2562-E-SN; SOIC-8_3.9x4.9mm_P1.27mm
U6, U7, U8: BTS441TG; IC5_BTS441TG_INF

Connections:
+3.3V: C1.2, C2.2, C5.1, C7.1, C8.2, C9.2, C10.2, C11.2, D1.2 (A), IC1.4 (VS), IC2.4 (VS), IC2.7 (A0), IC3.4 (VS), IC4.4 (VS), J13.01, R10.2, R11.2, R12.2, U1.1 (VDD3), U1.5 (VDDA/VREF+), U1.17 (VDD2/VDD_USB), U3.2 (VO), U4.5 (Vio)
+5V: C4.1, C6.1, D3.2 (A), JP1.1 (VCC), JP1.8 (VCC), U2.3 (+VOUT), U3.3 (VI), U4.3 (VDD)
+5V CAN2: D4.2 (A), JP2.1 (VCC), JP2.8 (VCC), U5.3 (+VOUT)
+BAT_ELEC: J1.2, J2.2
+VBAT_1: J8.2, U8.3 (VBB)
+VBAT_2: J6.2, U7.3 (VBB)
+VBAT_3: J4.2, U6.3 (VBB)
/ALERT: IC1.8 (ALERT), IC2.8 (ALERT), IC3.8 (ALERT), IC4.8 (ALERT), R12.1, U1.10 (PA4)
/ARU: J3.1, U1.3 (PF1/PC15)
/BOOT0: R1.2, U1.31 (BOOT0/PB8/PH3)
/CAN_H: JP1.4 (CAN_H), JP1.5 (CAN_H), JP2.4 (CAN_H), JP2.5 (CAN_H), U4.7 (CANH)
/CAN_L: JP1.3 (CAN_L), JP1.6 (CAN_L), JP2.3 (CAN_L), JP2.6 (CAN_L), U4.6 (CANL)
/IN+1: IC4.1 (IN+), R9.1, U8.5 (OUT)
/IN+2: IC3.1 (IN+), R7.1, U7.5 (OUT)
/IN+3: IC2.1 (IN+), R5.1, U6.5 (OUT)
/IN+main: D2.1 (K), IC1.1 (IN+), Q1.3 (S), R3.1
/IN-1: IC4.2 (IN-), J14.2, R9.2
/IN-2: IC3.2 (IN-), J7.2, R7.2
/IN-3: IC2.2 (IN-), J5.2, R5.2
/IN-main: IC1.2 (IN-), R3.2, U2.1 (+VIN), U5.1 (+VIN)
/NRST: C3.2, J13.10, U1.4 (NRST)
/PowerSW1: U1.13 (PA7), U8.2 (IN)
/PowerSW2: U1.14 (PB0), U7.2 (IN)
/PowerSW3: U1.15 (PB1/NPOR), U6.2 (IN)
/RX_Can: U1.21 (PA11), U4.4 (RXD)
/RX_TARGET: J13.05, U1.25 (PA15)
/SCL: IC1.5 (SCL), IC2.5 (SCL), IC3.5 (SCL), IC4.5 (SCL), IC4.7 (A0), R10.1, U1.29 (PB6)
/SDA: IC1.6 (SDA), IC2.6 (SDA), IC3.6 (SDA), IC3.7 (A0), IC4.6 (SDA), R11.1, U1.30 (PB7)
/SWO: J13.04, U1.26 (PB3)
/TCK: J13.06, U1.24 (PA14)
/TMS: J13.07, U1.23 (PA13)
/TX_Can: U1.22 (PA12), U4.1 (TXD)
/TX_TARGET: J13.08, U1.8 (PA2)
GND: C1.1, C2.1, C3.1, C4.2, C5.2, C6.2, C7.2, C8.1, C9.1, C10.1, C11.1, IC1.3 (GND), IC1.7 (A0), IC2.3 (GND), IC3.3 (GND), IC4.3 (GND), J1.1, J3.2, J4.1, J5.1, J6.1, J7.1, J8.1, J13.02, J13.03, J13.09, J14.1, J15.1, J15.2, JP1.2 (GND), JP1.7 (GND), JP2.2 (GND), JP2.7 (GND), R1.1, R2.1, R4.1, R6.1, R8.1, R13.1, R14.1, R15.1, U1.16 (PB2/VSS2), U1.32 (PB8/VSS3), U2.2 (GND), U3.1 (GND), U4.2 (VSS), U4.8 (STBY), U5.2 (GND)
unnamed: D1.1 (K), R2.2
unnamed: D2.2 (A), Q1.1 (G), R15.2
unnamed: D3.1 (K), R13.2
unnamed: D4.1 (K), R14.2
unnamed: J2.1, Q1.2 (D)
unnamed: R4.2, U6.1 (GND)
unnamed: R6.2, U7.1 (GND)
unnamed: R8.2, U8.1 (GND)
