Achille-92/CRAC2026/Prog_Actionneurs/Kicad/CarteMPPIndus/CarteMPP.kicad_pcb

## KiCad design Prog_Actionneurs/Kicad/CarteMPPIndus/CarteMPP.kicad_pcb (2026-09-27)

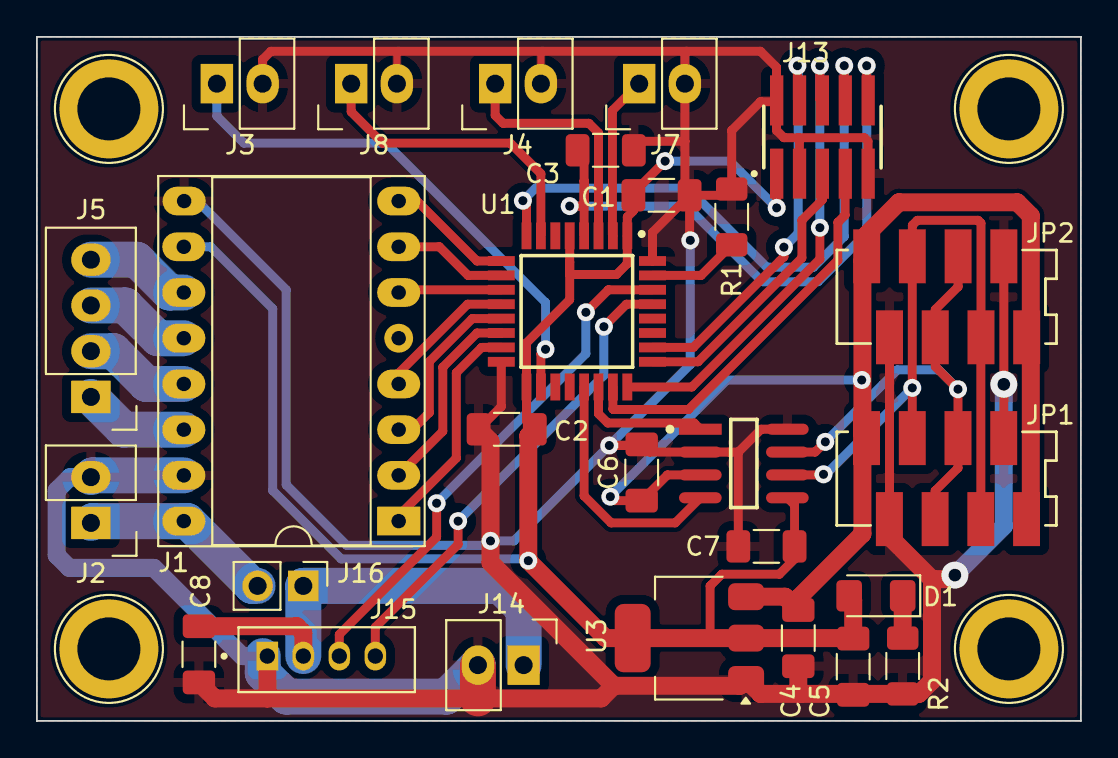
[picture p103: board CarteMPP.kicad_pcb from above]

Board: 2 copper layers, 58.0 x 38.0 mm, 31 parts (0 on the bottom side), 34 nets.

Parts:
C1, C2, C3, C6, C7: 100nF; C_1206_3216Metric_Pad1.33x1.80mm_HandSolder
C4: 10uF; C_1206_3216Metric_Pad1.33x1.80mm_HandSolder
C5: 22uF; C_1206_3216Metric_Pad1.33x1.80mm_HandSolder
C8: Cap; C_1206_3216Metric_Pad1.33x1.80mm_HandSolder
D1: LED; LED_1206_3216Metric_Pad1.42x1.75mm_HandSolder
J1: Conn_01x08; DIP-16_W7.62mm_Socket_LongPads
J2, J3, J4, J7, J8, J14: Autocom2
J5: Autocom4
J9, J10, J11, J12: Mounting_Screw_3mm
J13: FTSH-105-01-L-DV-K; SAMTEC_FTSH-105-01-L-DV-K
J15: Conn_01x02; PinHeader_1x02_P2.54mm_Vertical
J16: Herkulex; TE_292161-4
JP1, JP2: Micromatch 8; SW_DIP_SPSTx04_Slide_9.78x12.34mm_W7.62mm_P2.54mm
R1: 10K; R_1206_3216Metric_Pad1.30x1.75mm_HandSolder
R2: 360; R_1206_3216Metric_Pad1.30x1.75mm_HandSolder
U1: STM32F303K8T6; QFP80P900X900X160-32N
U2: MCP2562FDT-E/SN; SW_DIP_SPSTx02_Slide_9.78x7.26mm_W7.62mm_P2.54mm
U3: AZ1117-3.3; SOT-223-3_TabPin2

Connections:
+3.3V: C1.2, C2.2, C5.1, C7.1, D1.2 (A), J1.10 (Pin_2), J13.01, U1.1 (VDD3), U1.5 (VDDA/VREF+), U1.17 (VDD2/VDD_USB), U2.5 (VIO), U3.2 (VO)
+5V: C4.1, C6.1, JP1.1 (VCC), JP1.8 (VCC), JP2.1 (VCC), JP2.8 (VCC), U2.3 (VDD), U3.3 (VI)
/A1: J1.12 (Pin_4), J5.3
/A2: J1.11 (Pin_3), J5.4
/Aux1: J8.1, U1.7 (PA1)
/Aux2: J3.1, U1.18 (PA8)
/Aux3: J4.1, U1.3 (PF1/PC15)
/Aux4: J7.1, U1.2 (PF0/PC14)
/B1: J1.14 (Pin_6), J5.1
/B2: J1.13 (Pin_5), J5.2
/BOOT0: R1.2, U1.31 (BOOT0/PB8/PH3)
/CAN_H: JP1.4 (CAN_H), JP1.5 (CAN_H), JP2.4 (CAN_H), JP2.5 (CAN_H), U2.7 (CANH)
/CAN_L: JP1.3 (CAN_L), JP1.6 (CAN_L), JP2.3 (CAN_L), JP2.6 (CAN_L), U2.6 (CANL)
/DIR: J1.8, U1.9 (PA3)
/EN: J1.1, U1.15 (PB1/NPOR)
/M0: J1.2, U1.14 (PB0)
/M1: J1.3, U1.13 (PA7)
/M2: J1.4, U1.12 (PA6)
/NRST: C3.2, J13.10, U1.4 (NRST)
/RX_Can: U1.21 (PA11), U2.4 (RXD)
/RX_TARGET: J13.05, U1.25 (PA15)
/Rx1: J16.3 (TXD), U1.30 (PB7)
/STBY: J1.6, U1.11 (PA5)
/STEP: J1.7, U1.10 (PA4)
/SWO: J13.04, U1.26 (PB3)
/TCK: J13.06, U1.24 (PA14)
/TMS: J13.07, U1.23 (PA13)
/TX_Can: U1.22 (PA12), U2.1 (TXD)
/TX_TARGET: J13.08, U1.8 (PA2)
/Tx1: J16.4 (RXD), U1.29 (PB6)
/V_HERKULEX: C8.2, J14.1, J15.1, J16.2 (VCC)
/V_STEPPER: J1.16 (Pin_8), J2.1, J15.2
GND: C1.1, C2.1, C3.1, C4.2, C5.2, C6.2, C7.2, C8.1, J1.9 (Pin_1), J1.15 (Pin_7), J2.2, J3.2, J4.2, J7.2, J8.2, J13.02, J13.03, J13.09, J14.2, J16.1 (GND), JP1.2 (GND), JP1.7 (GND), JP2.2 (GND), JP2.7 (GND), R1.1, R2.1, U1.16 (PB2/VSS2), U1.32 (PB8/VSS3), U2.2 (VSS), U2.8 (STBY), U3.1 (GND)
unnamed: D1.1 (K), R2.2
