Achille-92/CRAC2026/Prog_Actionneurs/Kicad/Extension_Pompes/Extension_Pompes.kicad_pcb

## KiCad design Prog_Actionneurs/Kicad/Extension_Pompes/Extension_Pompes.kicad_pcb (2026-09-27)

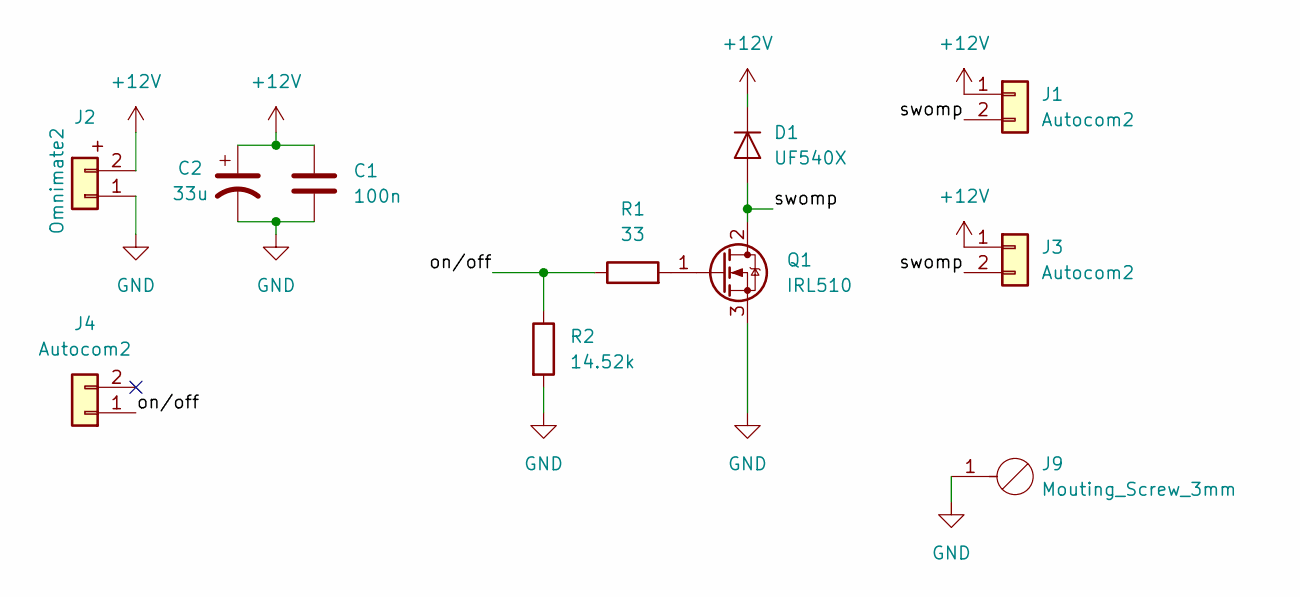
[picture p104: schematic Extension_Pompes.kicad_sch]

Parts:
C1: 100n; C_Rect_L7.0mm_W2.5mm_P5.00mm
C2: 33u; CP_Radial_D5.0mm_P2.50mm
D1: UF540X; D_DO-201AD_P15.24mm_Horizontal
J1, J3, J4: Autocom2
J2: Omnimate2; OmnimateSL-5,08_1x02_P5.08mm_Vertical
J9: Mouting_Screw_3mm; Mounting_Screw_3mm
Q1: IRL510; TO-220-3_Vertical
R1: 33; R_Axial_DIN0207_L6.3mm_D2.5mm_P10.16mm_Horizontal
R2: 14.52k; R_Axial_DIN0207_L6.3mm_D2.5mm_P10.16mm_Horizontal

Connections:
+12V: C1.1, C2.1, D1.1 (K), J1.1, J2.2, J3.1
/on/off: J4.1, R1.1, R2.1
/swomp: D1.2 (A), J1.2, J3.2, Q1.2 (D)
GND: C1.2, C2.2, J2.1, J9.1, Q1.3 (S), R2.2
unnamed: Q1.1 (G), R1.2

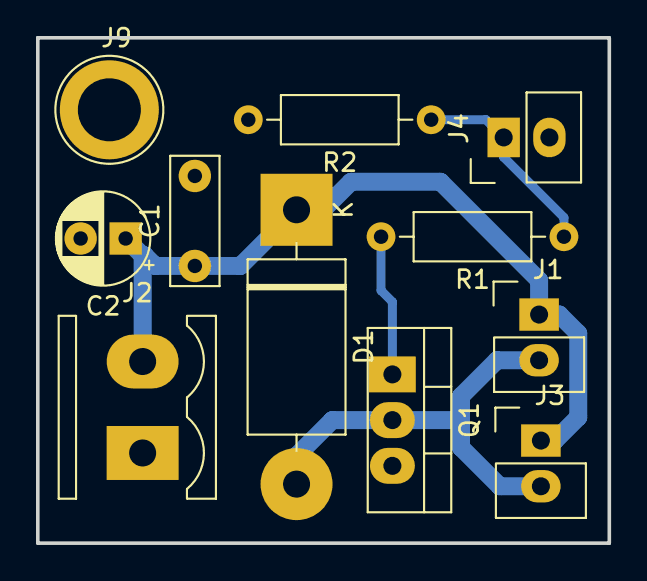
[picture p105: board Extension_Pompes.kicad_pcb from above]

Board: 2 copper layers, 31.8 x 28.1 mm, 11 parts (0 on the bottom side), 5 nets.
