Achille-92/CRAC2026/Prog_Actionneurs/Kicad/Ancien_Kicad_Pince KICAD V7/Herkulex.kicad_pcb

## KiCad design Prog_Actionneurs/Kicad/Ancien_Kicad_Pince KICAD V7/Herkulex.kicad_pcb (2026-09-27, an earlier design)

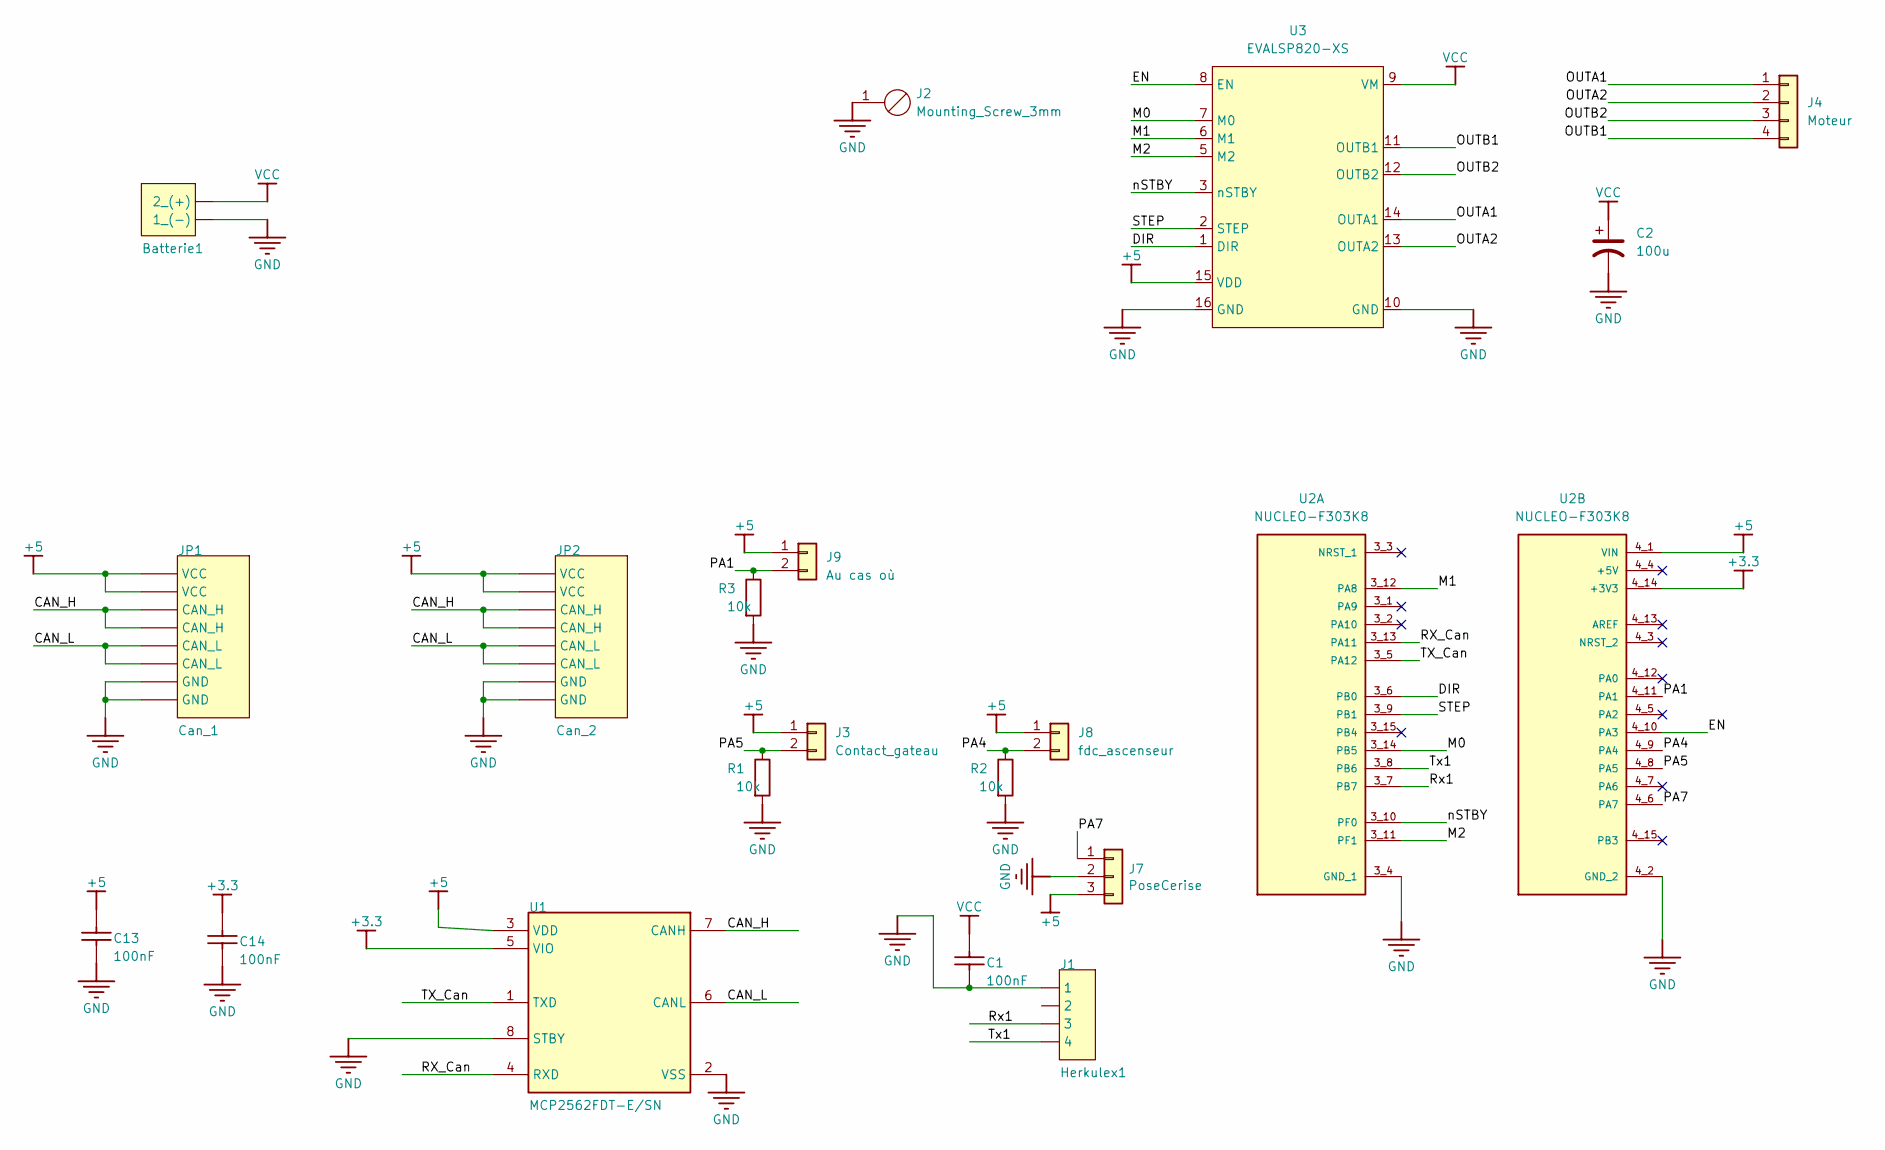
[picture p106: schematic Herkulex.kicad_sch]

Parts:
Batterie1: Connecteur alim 2 pts
C1: Cap
C2: 100u; CP_Radial_D10.0mm_P5.00mm
C13, C14: 100nF
J1: Herkulex1
J2: Mounting_Screw_3mm
J3: Contact_gateau; Autocom2
J4: Moteur; Autocom4
J7: PoseCerise; Autocom3
J8: fdc_ascenseur; Autocom2
J9: Au cas où; Autocom2
JP1: Can_1; MANUFACTURER PART NUMBER 7-188275-8
JP2: Can_2; MANUFACTURER PART NUMBER 7-188275-8
R1, R2, R3: 10k; R_Axial_DIN0207_L6.3mm_D2.5mm_P10.16mm_Horizontal
U1: MCP2562FDT-E/SN
U2: NUCLEO-F303K8; MODULE_NUCLEO-F303K8; PARTREV 5
U3: EVALSP820-XS

Connections:
+3.3: C14.2, U1.5 (VIO), U2.4_14 (+3V3)
+5: C13.2, J3.1, J7.3, J8.1, J9.1, JP1.1 (VCC), JP1.8 (VCC), JP2.1 (VCC), JP2.8 (VCC), U1.3 (VDD), U2.4_1 (VIN), U3.15 (VDD)
/CAN_H: JP1.4 (CAN_H), JP1.5 (CAN_H), JP2.4 (CAN_H), JP2.5 (CAN_H), U1.7 (CANH)
/CAN_L: JP1.3 (CAN_L), JP1.6 (CAN_L), JP2.3 (CAN_L), JP2.6 (CAN_L), U1.6 (CANL)
/DIR: U2.3_6 (PB0), U3.1 (DIR)
/EN: U2.4_10 (PA3), U3.8 (EN)
/M0: U2.3_14 (PB5), U3.7 (M0)
/M1: U2.3_12 (PA8), U3.6 (M1)
/M2: U2.3_11 (PF1), U3.5 (M2)
/OUTA1: J4.1, U3.14 (OUTA1)
/OUTA2: J4.2, U3.13 (OUTA2)
/OUTB1: J4.4, U3.11 (OUTB1)
/OUTB2: J4.3, U3.12 (OUTB2)
/PA1: J9.2, R3.1, U2.4_11 (PA1)
/PA4: J8.2, R2.1, U2.4_9 (PA4)
/PA5: J3.2, R1.1, U2.4_8 (PA5)
/PA7: J7.1, U2.4_6 (PA7)
/RX_Can: U1.4 (RXD), U2.3_13 (PA11)
/Rx1: J1.3, U2.3_7 (PB7)
/STEP: U2.3_9 (PB1), U3.2 (STEP)
/TX_Can: U1.1 (TXD), U2.3_5 (PA12)
/Tx1: J1.4, U2.3_8 (PB6)
/nSTBY: U2.3_10 (PF0), U3.3 (nSTBY)
GND: Batterie1.1 (1_(-)), C1.1, C2.2, C13.1, C14.1, J1.1, J2.1, J2.2 (Pin_1), J7.2, JP1.2 (GND), JP1.7 (GND), JP2.2 (GND), JP2.7 (GND), R1.2, R2.2, R3.2, U1.2 (VSS), U1.8 (STBY), U2.3_4 (GND_1), U2.4_2 (GND_2), U3.10 (GND), U3.16 (GND); also elsewhere on the board
VCC: Batterie1.2 (2_(+)), C1.2, C2.1, J1.2, U3.9 (VM)

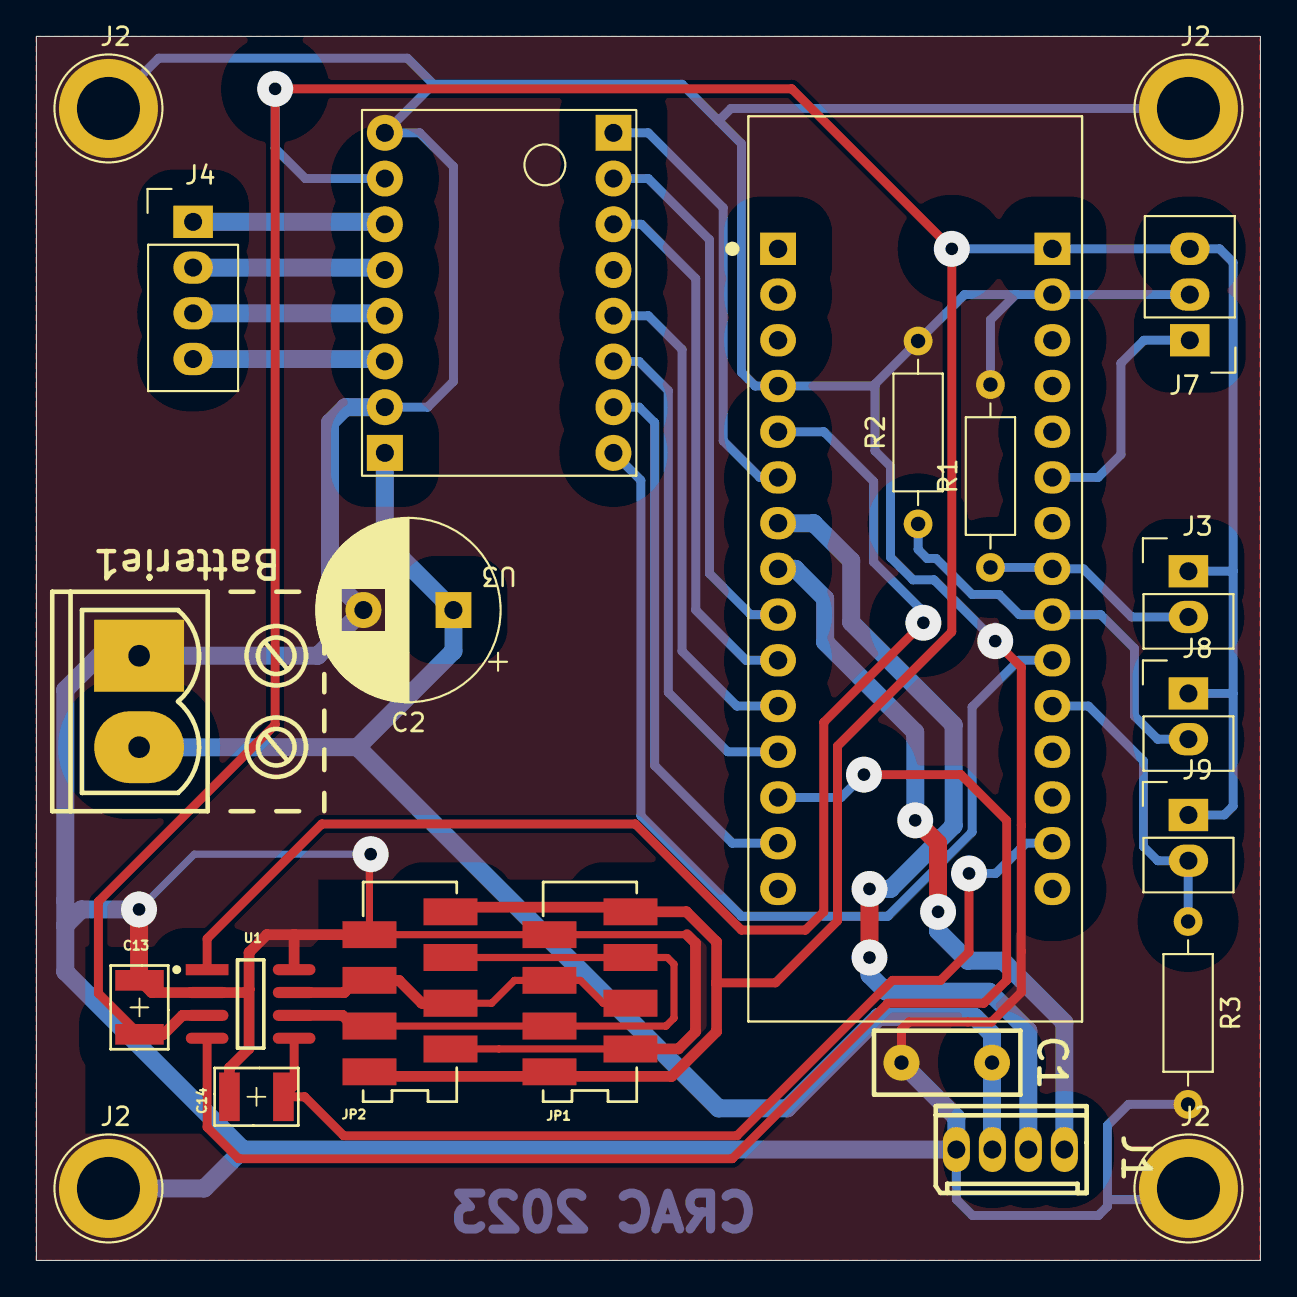
[picture p107: board Herkulex.kicad_pcb from above]

Board: 2 copper layers, 68.0 x 68.0 mm, 23 parts (0 on the bottom side), 25 nets.

Other parts of the board:
J2#2, J2#3, J2#4: Mounting_Screw_3mm

Their connections:
GND: J2#2.4 (Pin_1), J2#3.3 (Pin_1), J2#4.1; also elsewhere on the board
