Achille-92/CRAC2026/Prog_robot/fichier_strategie.py

from fonction import peuvent_etre_groupees, distance
import math
import numpy as np
def trouver_groupes_initiaux(noisettes):
    """Trouve tous les groupes de noisettes connectées"""
    n = len(noisettes)
    adjacence = [[] for _ in range(n)]
    
    # Construire le graphe d'adjacence
    for i in range(n):
        for j in range(i + 1, n):
            if peuvent_etre_groupees(noisettes[i], noisettes[j]):
                adjacence[i].append(j)
                adjacence[j].append(i)
    
    # Trouver les composantes connexes
    visite = [False] * n
    groupes = []
    
    for i in range(n):
        if not visite[i]:
            groupe = []
            pile = [i]
            while pile:
                noeud = pile.pop()
                if not visite[noeud]:
                    visite[noeud] = True
                    groupe.append(noeud)
                    pile.extend(adjacence[noeud])
            groupes.append(sorted(groupe))
    
    return groupes, adjacence


def separer_groupe(groupe_indices, noisettes, adjacence):
    """Sépare un groupe en paires et noisettes seules selon les règles"""
    if len(groupe_indices) == 1:
        return [[groupe_indices[0]]]
    
    if len(groupe_indices) == 2:
        return [groupe_indices]
    
    # Pour les groupes de 3 ou plus, on utilise une approche gloutonne
    # On forme des paires en priorisant les noisettes avec le moins de voisins
    indices_restants = set(groupe_indices)
    paires = []
    
    while len(indices_restants) >= 2:
        # Trouver la noisette avec le moins de voisins non appariés
        min_voisins = float('inf')
        noisette_depart = None
        
        for idx in indices_restants:
            voisins_disponibles = [v for v in adjacence[idx] if v in indices_restants and v != idx]
            if len(voisins_disponibles) < min_voisins:
                min_voisins = len(voisins_disponibles)
                noisette_depart = idx
        
        # Trouver le voisin le plus proche
        voisins_disponibles = [v for v in adjacence[noisette_depart] if v in indices_restants and v != noisette_depart]
        
        if voisins_disponibles:
            # Choisir le voisin le plus proche
            voisin_choisi = min(voisins_disponibles, 
                               key=lambda v: distance(noisettes[noisette_depart], noisettes[v]))
            paires.append([noisette_depart, voisin_choisi])
            indices_restants.remove(noisette_depart)
            indices_restants.remove(voisin_choisi)
        else:
            # Pas de voisin disponible, mettre seul
            paires.append([noisette_depart])
            indices_restants.remove(noisette_depart)
    
    # Ajouter les noisettes restantes seules
    for idx in indices_restants:
        paires.append([idx])
    
    return paires

def regrouper_par_quatre(groupe_indices, noisettes):
    """Regroupe les noisettes en groupes de 4 maximum"""
    groupes_de_quatre = []
    
    # Trier les indices par position pour un regroupement cohérent
    indices_tries = sorted(groupe_indices, key=lambda i: (noisettes[i][0], noisettes[i][1]))
    
    # Créer des groupes de 4
    for i in range(0, len(indices_tries), 4):
        groupe = indices_tries[i:i+4]
        groupes_de_quatre.append(groupe)
    
    return groupes_de_quatre

def calculer_difference_angulaire(angle_actuel, angle_cible):
    """
    Calcule la différence angulaire la plus courte entre deux angles
    Retourne une valeur entre -180 et 180 degrés
    """
    diff = angle_cible - angle_actuel
    
    # Normaliser entre -180 et 180
    while diff > 180:
        diff -= 360
    while diff < -180:
        diff += 360
    
    return abs(diff)

def remplir_Liste_actions(LARGEUR_ROBOT,x_strategie,y_strategie,Noisettes_groupees,strategie_en_cours,demande_nouvelle_strat,Liste_actions,couleur,Liste_zones_gm_coins,TOLERANCE_STRATEGIE_NOISETTE,Noisettes_stockees_dans_robot,MARGE_NOISETTE,MARGE_GM,LONGUEUR_ROBOT,Liste_noisette_xya,x_robot_actuel,y_robot_actuel,Pince_Avant, Pince_Av_1, Pince_Av_2,Pince_Arriere, Pince_Ar_1, Pince_Ar_2,width,height,CASE_MM,grid_expanded,Pousser,angle_robot_actuel):

    Liste_actions.clear()
    chercher_Noisette = None
    aller_nid = False

    if (couleur == "B" and 2400<= x_strategie <= 3000 and 1550 <= y_strategie <= 2000) or (couleur == "J" and 0<= x_strategie <= 600 and 1550 <= y_strategie <= 2000):
        print("Stratégie : nid")
        aller_nid = True
    
    for num_gm in range(len(Liste_zones_gm_coins)):
        if Liste_zones_gm_coins[num_gm][0][0]<= x_strategie <= Liste_zones_gm_coins[num_gm][1][0] and Liste_zones_gm_coins[num_gm][0][1]<= y_strategie <= Liste_zones_gm_coins[num_gm][1][1]:
            strategie_en_cours = num_gm
            distance_Robot_strategie = math.sqrt((x_robot_actuel - x_strategie)**2 + (y_robot_actuel - y_strategie)**2)
            chercher_Noisette = False
            break
    
    for grpNoisette in Noisettes_groupees:
        nbr_Noisette = len(grpNoisette)
        x_centre = 0
        y_centre = 0
        angle_groupe = 0
        for num_Noisette in range(nbr_Noisette):
            x_centre += grpNoisette[num_Noisette][0]
            y_centre += grpNoisette[num_Noisette][1]
            angle_groupe += grpNoisette[num_Noisette][2]
        x_centre/=nbr_Noisette
        y_centre/=nbr_Noisette
        angle_groupe /=nbr_Noisette
        distance_Noisette_strategie = math.sqrt((x_strategie - x_centre)**2 + (y_strategie - y_centre)**2)
        if distance_Noisette_strategie <= TOLERANCE_STRATEGIE_NOISETTE:
            distance_Robot_strategie = math.sqrt((x_robot_actuel - x_centre)**2 + (y_robot_actuel - y_centre)**2)
            strategie_en_cours = grpNoisette
            chercher_Noisette = True
            break
    
    if chercher_Noisette == True:
        pince_a_utilise = None
        sous_pince = None
        print(strategie_en_cours)
        if len(strategie_en_cours)==1:
            angle_noisette = strategie_en_cours[0][2]

            if Noisettes_stockees_dans_robot[0]!=["J","B"] and Noisettes_stockees_dans_robot[0]!=["B","J"] and Noisettes_stockees_dans_robot[0]!=["B","B"] and Noisettes_stockees_dans_robot[0]!=["J","J"] and (Pince_Av_1 or Pince_Av_2):
                pince_a_utilise = 0
                if Noisettes_stockees_dans_robot[0][0]=="N" and Pince_Av_1:
                    sous_pince = 1
                elif Noisettes_stockees_dans_robot[0][1]=="N" and Pince_Av_2:
                    sous_pince = 2
                else:
                    demande_nouvelle_strat = True
            elif Noisettes_stockees_dans_robot[1]!=["J","B"] and Noisettes_stockees_dans_robot[1]!=["B","J"] and Noisettes_stockees_dans_robot[1]!=["B","B"] and Noisettes_stockees_dans_robot[1]!=["J","J"] and (Pince_Ar_1 or Pince_Ar_2):
                pince_a_utilise = 1
                if Noisettes_stockees_dans_robot[1][0]=="N" and Pince_Ar_1:
                    sous_pince = 1
                elif Noisettes_stockees_dans_robot[1][1]=="N" and Pince_Ar_2:
                    sous_pince = 2
                else : demande_nouvelle_strat = True
            else:
                demande_nouvelle_strat = True

            print("pince_a_utilise : ",pince_a_utilise)
            print("sous_pince : ",sous_pince)
            point_1_bloquee = False
            point_2_bloquee = False

            distance = 50*(sous_pince-1) + 25 + MARGE_NOISETTE + LONGUEUR_ROBOT/2
            angle_rad1 = math.radians(angle_noisette + 90)
            angle_rad2 = math.radians(angle_noisette + 90 - 180)
            
            x_arrivee_1 = strategie_en_cours[0][0]+distance*math.cos(angle_rad1)
            y_arrivee_1 = strategie_en_cours[0][1]+distance*math.sin(angle_rad1)
            x_arrivee_2 = strategie_en_cours[0][0]+distance*math.cos(angle_rad2)
            y_arrivee_2 = strategie_en_cours[0][1]+distance*math.sin(angle_rad2)
        
            distance = 50*(sous_pince-1) + 25 + MARGE_NOISETTE + LONGUEUR_ROBOT/2 + 120
            x_arrivee_Astar1 = strategie_en_cours[0][0]+distance*math.cos(angle_rad1)
            y_arrivee_Astar1 = strategie_en_cours[0][1]+distance*math.sin(angle_rad1)
            x_arrivee_Astar2 = strategie_en_cours[0][0]+distance*math.cos(angle_rad2)
            y_arrivee_Astar2 = strategie_en_cours[0][1]+distance*math.sin(angle_rad2)
            
            if grid_expanded[max(0, min(width - 1, int(x_arrivee_Astar1 // CASE_MM))), max(0, min(height - 1, int(y_arrivee_Astar1 // CASE_MM)))]:
                point_1_bloquee = True
            if grid_expanded[max(0, min(width - 1, int(x_arrivee_Astar2 // CASE_MM))), max(0, min(height - 1, int(y_arrivee_Astar2 // CASE_MM)))]:
                point_2_bloquee = True

            if point_1_bloquee and point_2_bloquee:
                demande_nouvelle_strat = True
            else:
                if point_2_bloquee:
                    print("iiiiiiiiii")
                    if pince_a_utilise == 0:
                        if distance_Robot_strategie < distance:
                            Liste_actions = [["Rotation",-90+angle_noisette],["Consigne",x_arrivee_1,y_arrivee_1],["Rotation",-90+angle_noisette]]
                        else:
                            Liste_actions = [["Consigne",x_arrivee_Astar1,y_arrivee_Astar1],["Consigne",x_arrivee_1,y_arrivee_1],["Rotation",-90+angle_noisette]]
                        
                    else:
                        if distance_Robot_strategie < distance:
                            Liste_actions = [["Rotation",90+angle_noisette],["ReculerPrecis",x_arrivee_1,y_arrivee_1],["Rotation",90+angle_noisette]]
                        else:
                            Liste_actions = [["ReculerPrecis",x_arrivee_Astar1,y_arrivee_Astar1],["ReculerPrecis",x_arrivee_1,y_arrivee_1],["Rotation",90+angle_noisette]]
                        
                elif point_1_bloquee:
                    print("jjjjjjjjjjj")
                    if pince_a_utilise == 0:
                        if distance_Robot_strategie < distance:
                            Liste_actions = [["Rotation",90+angle_noisette],["Consigne",x_arrivee_2,y_arrivee_2],["Rotation",90+angle_noisette]]
                        else:
                            Liste_actions = [["Consigne",x_arrivee_Astar2,y_arrivee_Astar2],["Consigne",x_arrivee_2,y_arrivee_2],["Rotation",90+angle_noisette]]
                
                    else:
                        if distance_Robot_strategie < distance:
                            Liste_actions = [["Rotation",-90+angle_noisette],["ReculerPrecis",x_arrivee_2,y_arrivee_2],["Rotation",-90+angle_noisette]]
                        else:
                            Liste_actions = [["ReculerPrecis",x_arrivee_Astar2,y_arrivee_Astar2],["ReculerPrecis",x_arrivee_2,y_arrivee_2],["Rotation",-90+angle_noisette]]
                        
                else:
                    distance_robot_point1 = math.sqrt((x_arrivee_1 - x_robot_actuel)**2 + (y_arrivee_1 - y_robot_actuel)**2)
                    distance_robot_point2 = math.sqrt((x_arrivee_2 - x_robot_actuel)**2 + (y_arrivee_2 - y_robot_actuel)**2)
                    if distance_robot_point1 <= distance_robot_point2:
                        print("kkkkkkkkk")
                        if pince_a_utilise == 0:
                            if distance_Robot_strategie < distance:
                                Liste_actions = [["Rotation",90+angle_noisette],["Consigne",x_arrivee_1,y_arrivee_1],["Rotation",90+angle_noisette]]
                            else:
                                Liste_actions = [["Consigne",x_arrivee_Astar1,y_arrivee_Astar1],["Consigne",x_arrivee_1,y_arrivee_1],["Rotation",90+angle_noisette]]
                            
                        else:
                            if distance_Robot_strategie < distance:
                                Liste_actions = [["Rotation",-90+angle_noisette],["ReculerPrecis",x_arrivee_1,y_arrivee_1],["Rotation",-90+angle_noisette]]
                            else:
                                Liste_actions = [["ReculerPrecis",x_arrivee_Astar1,y_arrivee_Astar1],["ReculerPrecis",x_arrivee_1,y_arrivee_1],["Rotation",-90+angle_noisette]]
                            
                    else:
                        print("llllllllll")
                        if pince_a_utilise == 0:
                            if distance_Robot_strategie < distance: 
                                Liste_actions = [["Rotation",-90+angle_noisette],["Consigne",x_arrivee_2,y_arrivee_2],["Rotation",-90+angle_noisette]]
                            else:
                                Liste_actions = [["Consigne",x_arrivee_Astar2,y_arrivee_Astar2],["Consigne",x_arrivee_2,y_arrivee_2],["Rotation",-90+angle_noisette]]
                            
                        else:
                            if distance_Robot_strategie < distance:
                                Liste_actions = [["Rotation",90+angle_noisette],["ReculerPrecis",x_arrivee_2,y_arrivee_2],["Rotation",90+angle_noisette]]
                            else:
                                Liste_actions = [["ReculerPrecis",x_arrivee_Astar2,y_arrivee_Astar2],["ReculerPrecis",x_arrivee_2,y_arrivee_2],["Rotation",90+angle_noisette]]
                            
                Liste_actions.append(["Attraper",pince_a_utilise,sous_pince])
                if (pince_a_utilise == 0 and Pince_Avant) or (pince_a_utilise == 1 and Pince_Arriere):
                    if strategie_en_cours[0][3] != "R":
                        if strategie_en_cours[0][3] != couleur:
                            Liste_actions.append(["Retourner",pince_a_utilise,sous_pince])
                    else:
                        demande_nouvelle_strat = True
        else :
            pince_a_utilise = None
            sous_pince = None
            if Noisettes_stockees_dans_robot[0]==["N","N"] and Pince_Av_1 and Pince_Av_2:
                pince_a_utilise = 0
                sous_pince = 12
            elif Noisettes_stockees_dans_robot[1]==["N","N"] and Pince_Ar_1 and Pince_Ar_2:
                pince_a_utilise = 1
                sous_pince = 12
            else:
                if Noisettes_stockees_dans_robot[0]==["N","N"] and Pince_Av_1 and not Pince_Av_2:
                    pince_a_utilise = 0
                    sous_pince = 1
                elif Noisettes_stockees_dans_robot[0]==["N","N"] and not Pince_Av_1 and Pince_Av_2:
                    pince_a_utilise = 0
                    sous_pince = 2
                elif Noisettes_stockees_dans_robot[1]==["N","N"] and Pince_Ar_1 and not Pince_Ar_2:
                    pince_a_utilise = 1
                    sous_pince = 1
                elif Noisettes_stockees_dans_robot[1]==["N","N"] and not Pince_Ar_1 and Pince_Ar_2:
                    pince_a_utilise = 1
                    sous_pince = 2
                else:
                    demande_nouvelle_strat = True

            print("pince_a_utilise : ",pince_a_utilise)
            print("sous_pince : ",sous_pince)

            distance_robot_n0 = math.sqrt((x_robot_actuel - strategie_en_cours[0][0])**2 + (y_robot_actuel - strategie_en_cours[0][1])**2)
            distance_robot_n1 = math.sqrt((x_robot_actuel - strategie_en_cours[1][0])**2 + (y_robot_actuel - strategie_en_cours[1][1])**2)

            print("Distance entre robot et n0 : ",distance_robot_n0)
            print("Distance entre robot et n1 : ",distance_robot_n1)
            print("Strategie avant tri : ",strategie_en_cours)
            # Tri des noisettes par distance
            if distance_robot_n0 > distance_robot_n1:
                temp = strategie_en_cours[0]
                strategie_en_cours[0] = strategie_en_cours[1]
                strategie_en_cours[1] = temp
                distance_robot_n0, distance_robot_n1 = distance_robot_n1, distance_robot_n0
            
            print("Strategie après tri : ",strategie_en_cours)

            angle_noisette1 = strategie_en_cours[0][2]
            angle_noisette2 = strategie_en_cours[1][2]

            if sous_pince == 2:
                distance = 50 + 25 + MARGE_NOISETTE + LONGUEUR_ROBOT/2
            else:
                distance = 25 + MARGE_NOISETTE + LONGUEUR_ROBOT/2

            # Normaliser l'angle entre 0 et 180°
            angle_moyen = (angle_noisette1 + angle_noisette2) / 2
            angle_normalise = angle_moyen % 180

            # ⭐ CALCULER LA POSITION RELATIVE DU ROBOT PAR RAPPORT AUX NOISETTES ⭐
            x_centre_noisettes = (strategie_en_cours[0][0] + strategie_en_cours[1][0]) / 2
            y_centre_noisettes = (strategie_en_cours[0][1] + strategie_en_cours[1][1]) / 2

            # Déterminer si les noisettes sont horizontales (~0°) ou verticales (~90°)
            if 45 < angle_normalise < 135:  # Noisettes verticales (~90°)
                
                # Robot à gauche ou à droite des noisettes ?
                if x_robot_actuel < x_centre_noisettes:
                    # Approcher par la gauche
                    angle_rad1 = math.radians(angle_noisette1 + 90)  # Côté gauche
                    angle_rad2 = math.radians(angle_noisette2 - 90)
                else:
                    # Approcher par la droite
                    angle_rad1 = math.radians(angle_noisette1 - 90)  # Côté droit
                    angle_rad2 = math.radians(angle_noisette2 + 90)

            else:  # Noisettes horizontales (~0° ou ~180°)
                # Robot en haut ou en bas des noisettes ?
                if y_robot_actuel < y_centre_noisettes:
                    # Approcher par le bas
                    angle_rad1 = math.radians(angle_noisette1 - 90)  # En bas
                    angle_rad2 = math.radians(angle_noisette2 + 90)
                else:
                    # Approcher par le haut
                    angle_rad1 = math.radians(angle_noisette1 + 90)  # En haut
                    angle_rad2 = math.radians(angle_noisette2 - 90)

            print("angle_noisette1 : ",angle_noisette1-90)
            print("angle_noisette2 : ",angle_noisette2+90)
            print("Point1 associé à Noisette : ",strategie_en_cours[0])
            print("Point2 associé à Noisette : ",strategie_en_cours[1])

            x_arrivee_1 = strategie_en_cours[0][0]+distance*math.cos(angle_rad1)
            y_arrivee_1 = strategie_en_cours[0][1]+distance*math.sin(angle_rad1)
            x_arrivee_2 = strategie_en_cours[1][0]+distance*math.cos(angle_rad2)
            y_arrivee_2 = strategie_en_cours[1][1]+distance*math.sin(angle_rad2)
            
            if sous_pince == 2:
                distance = 50 + 50 + 25 + MARGE_NOISETTE+LONGUEUR_ROBOT/2 + 100
            else:
                distance = 50 + 25 + MARGE_NOISETTE+LONGUEUR_ROBOT/2 + 100
                
            x_arrivee_Astar1 = strategie_en_cours[0][0]+distance*math.cos(angle_rad1)
            y_arrivee_Astar1 = strategie_en_cours[0][1]+distance*math.sin(angle_rad1)
            x_arrivee_Astar2 = strategie_en_cours[1][0]+distance*math.cos(angle_rad2)
            y_arrivee_Astar2 = strategie_en_cours[1][1]+distance*math.sin(angle_rad2)

            point_1_bloquee = False
            point_2_bloquee = False
            if grid_expanded[max(0, min(width - 1, int(x_arrivee_Astar1 // CASE_MM))), max(0, min(height - 1, int(y_arrivee_Astar1 // CASE_MM)))]:
                point_1_bloquee = True
            if grid_expanded[max(0, min(width - 1, int(x_arrivee_Astar2 // CASE_MM))), max(0, min(height - 1, int(y_arrivee_Astar2 // CASE_MM)))]:
                point_2_bloquee = True

            if point_1_bloquee and point_2_bloquee:
                demande_nouvelle_strat = True
            else:
                distance_robot_point1 = math.sqrt((x_arrivee_1 - x_robot_actuel)**2 + (y_arrivee_1 - y_robot_actuel)**2)
                distance_robot_point2 = math.sqrt((x_arrivee_2 - x_robot_actuel)**2 + (y_arrivee_2 - y_robot_actuel)**2)
                if point_2_bloquee:
                    print("aaaaaaaaa")
                    # Calculer l'angle requis pour atteindre le point
                    angle_robot_vers_point = np.degrees(math.atan2(y_arrivee_1 - y_robot_actuel, x_arrivee_1 - x_robot_actuel))
                    diff_angle = calculer_difference_angulaire(angle_robot_actuel, angle_robot_vers_point)

                    angle_pointarrivee_noisette = int(np.degrees(math.atan2(strategie_en_cours[0][1] - y_arrivee_1, strategie_en_cours[0][0] - x_arrivee_1)))
                    if pince_a_utilise == 0:
                        if distance_Robot_strategie < distance and diff_angle<20 :
                            Liste_actions = [["Rotation",angle_pointarrivee_noisette],["Consigne",x_arrivee_1,y_arrivee_1],["Rotation",angle_pointarrivee_noisette]]
                        else:
                            Liste_actions = [["Consigne",x_arrivee_Astar1,y_arrivee_Astar1],["Consigne",x_arrivee_1,y_arrivee_1],["Rotation",angle_pointarrivee_noisette]]
                        
                    else:
                        if distance_Robot_strategie < distance and diff_angle<20 :
                            Liste_actions = [["Rotation",180+angle_pointarrivee_noisette],["ReculerPrecis",x_arrivee_1,y_arrivee_1],["Rotation",180+angle_pointarrivee_noisette]]
                        else:
                            Liste_actions = [["ReculerPrecis",x_arrivee_Astar1,y_arrivee_Astar1],["ReculerPrecis",x_arrivee_1,y_arrivee_1],["Rotation",180+angle_pointarrivee_noisette]]
                        
                elif point_1_bloquee:
                    print("bbbbbbbbb")
                    angle_pointarrivee_noisette = int(np.degrees(math.atan2(strategie_en_cours[1][1] - y_arrivee_2, strategie_en_cours[1][0] - x_arrivee_2)))
                    angle_robot_vers_point = np.degrees(math.atan2(y_arrivee_1 - y_robot_actuel, x_arrivee_1 - x_robot_actuel))
                    diff_angle = calculer_difference_angulaire(angle_robot_actuel, angle_robot_vers_point)
                    if pince_a_utilise == 0:
                        if distance_Robot_strategie < distance and diff_angle<20 :
                            Liste_actions = [["Rotation",angle_pointarrivee_noisette],["Consigne",x_arrivee_2,y_arrivee_2],["Rotation",angle_pointarrivee_noisette]]
                        else:
                            Liste_actions = [["Consigne",x_arrivee_Astar2,y_arrivee_Astar2],["Consigne",x_arrivee_2,y_arrivee_2],["Rotation",angle_pointarrivee_noisette]]
                        
                    else:
                        if distance_Robot_strategie < distance and diff_angle<20 :
                            Liste_actions = [["Rotation",180+angle_pointarrivee_noisette],["ReculerPrecis",x_arrivee_2,y_arrivee_2],["Rotation",180+angle_pointarrivee_noisette]]
                        else:
                            Liste_actions = [["ReculerPrecis",x_arrivee_Astar2,y_arrivee_Astar2],["ReculerPrecis",x_arrivee_2,y_arrivee_2],["Rotation",180+angle_pointarrivee_noisette]]
                        
                else:
                    distance_robot_point1 = math.sqrt((x_arrivee_1 - x_robot_actuel)**2 + (y_arrivee_1 - y_robot_actuel)**2)
                    distance_robot_point2 = math.sqrt((x_arrivee_2 - x_robot_actuel)**2 + (y_arrivee_2 - y_robot_actuel)**2)
                    if distance_robot_point1 <= distance_robot_point2:
                        print("cccccccccc")
                        angle_pointarrivee_noisette = int(np.degrees(math.atan2(strategie_en_cours[0][1] - y_arrivee_1, strategie_en_cours[0][0] - x_arrivee_1)))
                        angle_robot_vers_point = np.degrees(math.atan2(y_arrivee_1 - y_robot_actuel, x_arrivee_1 - x_robot_actuel))
                        diff_angle = calculer_difference_angulaire(angle_robot_actuel, angle_robot_vers_point)
                        if pince_a_utilise == 0:
                            if distance_Robot_strategie < distance and diff_angle<20 :
                                Liste_actions = [["Rotation",angle_pointarrivee_noisette],["Consigne",x_arrivee_1,y_arrivee_1],["Rotation",angle_pointarrivee_noisette]]
                            else:
                                Liste_actions = [["Consigne",x_arrivee_Astar1,y_arrivee_Astar1],["Consigne",x_arrivee_1,y_arrivee_1],["Rotation",angle_pointarrivee_noisette]]
                            
                        else:
                            if distance_Robot_strategie < distance and diff_angle<20 :
                                Liste_actions = [["Rotation",180+angle_pointarrivee_noisette],["ReculerPrecis",x_arrivee_1,y_arrivee_1],["Rotation",180+angle_pointarrivee_noisette]]
                            else:
                                Liste_actions = [["ReculerPrecis",x_arrivee_Astar1,y_arrivee_Astar1],["ReculerPrecis",x_arrivee_1,y_arrivee_1],["Rotation",180+angle_pointarrivee_noisette]]
                            
                    else:
                        print("dddddddd")
                        angle_pointarrivee_noisette = int(np.degrees(math.atan2(strategie_en_cours[1][1] - y_arrivee_2, strategie_en_cours[1][0] - x_arrivee_2)))
                        angle_robot_vers_point = np.degrees(math.atan2(y_arrivee_1 - y_robot_actuel, x_arrivee_1 - x_robot_actuel))
                        diff_angle = calculer_difference_angulaire(angle_robot_actuel, angle_robot_vers_point)
                        if pince_a_utilise == 0:
                            if distance_Robot_strategie < distance and diff_angle<20 :
                                Liste_actions = [["Rotation",angle_pointarrivee_noisette],["Consigne",x_arrivee_2,y_arrivee_2],["Rotation",angle_pointarrivee_noisette]]
                            else:
                                Liste_actions = [["Consigne",x_arrivee_Astar2,y_arrivee_Astar2],["Consigne",x_arrivee_2,y_arrivee_2],["Rotation",angle_pointarrivee_noisette]]
                            
                        else:
                            if distance_Robot_strategie < distance and diff_angle<20 :
                                Liste_actions = [["Rotation",180+angle_pointarrivee_noisette],["ReculerPrecis",x_arrivee_2,y_arrivee_2],["Rotation",180+angle_pointarrivee_noisette]]
                            else:
                                Liste_actions = [["ReculerPrecis",x_arrivee_Astar2,y_arrivee_Astar2],["ReculerPrecis",x_arrivee_2,y_arrivee_2],["Rotation",180+angle_pointarrivee_noisette]]
                            
                Liste_actions.append(["Attraper",pince_a_utilise,sous_pince])

                if pince_a_utilise == 1 and Pince_Avant:
                    action = None
                    if Noisettes_stockees_dans_robot[0][0] != couleur and Noisettes_stockees_dans_robot[0][1] != couleur and Noisettes_stockees_dans_robot[0] != ["N","N"]:
                        action = ["Retourner",0,12]
                    elif Noisettes_stockees_dans_robot[0][0] != couleur and Noisettes_stockees_dans_robot[0][1] == couleur and Noisettes_stockees_dans_robot[0] != ["N","N"]:
                        action = ["Retourner",0,1]
                    elif Noisettes_stockees_dans_robot[0][0] == couleur and Noisettes_stockees_dans_robot[0][1] != couleur and Noisettes_stockees_dans_robot[0] != ["N","N"]:
                        action = ["Retourner",0,2]
                    else : 
                        action = None
                    print("action : ",action)
                    if action is not None:
                        for idx_action in range(len(Liste_actions)):
                            if Liste_actions[idx_action][0] in ["Attraper"]:
                                Liste_actions.insert(idx_action,action)
                                break
                        
                if pince_a_utilise == 0 and Pince_Arriere:
                    action = None
                    if Noisettes_stockees_dans_robot[1][0] != couleur and Noisettes_stockees_dans_robot[1][1] != couleur and Noisettes_stockees_dans_robot[1] != ["N","N"]:
                        action = ["Retourner",1,12]
                    elif Noisettes_stockees_dans_robot[1][0] != couleur and Noisettes_stockees_dans_robot[1][1] == couleur and Noisettes_stockees_dans_robot[1] != ["N","N"]:
                        action = ["Retourner",1,1]
                    elif Noisettes_stockees_dans_robot[1][0] == couleur and Noisettes_stockees_dans_robot[1][1] != couleur and Noisettes_stockees_dans_robot[1] != ["N","N"]:
                        action = ["Retourner",1,2]
                    else : 
                        action = None
                    
                    if action is not None:
                        for idx_action in range(len(Liste_actions)):
                            if Liste_actions[idx_action][0] in ["Attraper"]:
                                Liste_actions.insert(idx_action,action)
                                break
                    

    elif chercher_Noisette == False:
        print(f"GM n°{strategie_en_cours}")
        
        if Noisettes_stockees_dans_robot == [["N","N"],["N","N"]]:
            print("Pas de Noisette dans robot")
            demande_nouvelle_strat = True
        else:
            if Noisettes_stockees_dans_robot[0] != ["N","N"]:
                pince_a_utilise = 0
            else :
                pince_a_utilise = 1
            if Noisettes_stockees_dans_robot[pince_a_utilise] == ["J","B"] or Noisettes_stockees_dans_robot[pince_a_utilise] == ["B","J"] or Noisettes_stockees_dans_robot[pince_a_utilise] == ["J","J"] or Noisettes_stockees_dans_robot[pince_a_utilise] == ["B","B"]:
                sous_pince = 12
            elif Noisettes_stockees_dans_robot[pince_a_utilise] == ["J","N"] or Noisettes_stockees_dans_robot[pince_a_utilise] == ["B","N"]:
                sous_pince = 1
            elif Noisettes_stockees_dans_robot[pince_a_utilise] == ["N","J"] or Noisettes_stockees_dans_robot[pince_a_utilise] == ["N","B"]:
                sous_pince = 2

            print("pince_a_utilise",pince_a_utilise)
            print("sous_pince : ",sous_pince)

            Strat_Noisettes_dans_GM = []
            for Noisette in Liste_noisette_xya:
                x_centre, y_centre, angle = Noisette[0], Noisette[1], Noisette[2]
    
                # Dimensions
                longueur = 150  # mm (dans la direction de l'angle)
                largeur = 50    # mm (perpendiculaire à l'angle)
                
                # Conversion angle en radians
                angle_rad = math.radians(angle)
                
                # Vecteurs directeurs
                dx_long = (longueur / 2) * math.cos(angle_rad)
                dy_long = (longueur / 2) * math.sin(angle_rad)
                dx_larg = (largeur / 2) * math.sin(angle_rad)  # Perpendiculaire = rotation de 90°
                dy_larg = -(largeur / 2) * math.cos(angle_rad)
                
                # Calcul des 4 coins (sens trigonométrique depuis le centre)
                Noisette_coin_hg = (x_centre - dx_long - dx_larg, y_centre - dy_long - dy_larg)  # Haut-Gauche
                Noisette_coin_hd = (x_centre + dx_long - dx_larg, y_centre + dy_long - dy_larg)  # Haut-Droite
                Noisette_coin_bd = (x_centre + dx_long + dx_larg, y_centre + dy_long + dy_larg)  # Bas-Droite
                Noisette_coin_bg = (x_centre - dx_long + dx_larg, y_centre - dy_long + dy_larg)  # Bas-Gauche
    
                # Vérifier si AU MOINS UN coin est dans une zone GM
                zone = Liste_zones_gm_coins[strategie_en_cours]
                x_min, y_min = zone[0]
                x_max, y_max = zone[1]
                
                # Liste des 4 coins
                coins = [Noisette_coin_hg, Noisette_coin_hd, Noisette_coin_bd, Noisette_coin_bg]
                
                # Vérifier si au moins un coin est dans la zone
                if any(x_min <= coin[0] <= x_max and y_min <= coin[1] <= y_max for coin in coins):
                    Strat_Noisettes_dans_GM.append(Noisette)
            
            x_centre_gm = (Liste_zones_gm_coins[strategie_en_cours][0][0]+Liste_zones_gm_coins[strategie_en_cours][1][0])/2
            y_centre_gm = (Liste_zones_gm_coins[strategie_en_cours][0][1]+Liste_zones_gm_coins[strategie_en_cours][1][1])/2
            print(x_centre_gm)
            print(y_centre_gm)

            print("Strat_Noisettes_dans_GM : ",Strat_Noisettes_dans_GM)
            if Strat_Noisettes_dans_GM != []:
                nb = len(Strat_Noisettes_dans_GM)
                # Capacité max du GM : 4 noisettes
                if nb >= 4:
                    demande_nouvelle_strat = True
                elif nb == 3 and sous_pince == 12:
                    # Plus de place pour 2 noisettes
                    demande_nouvelle_strat = True
                elif nb == 3 and (sous_pince == 1 or sous_pince == 2):
                    # Place pour 1 Noisette
                    
                    print("Possible, aller poser 1 Noisette")
                else:
                    print("Possible, 1 ou 2 Noisettes, alelr poser 1 ou 2 Noisettes")
                    if sous_pince == 12 or sous_pince == 2:
                        print("111111111111")
                        distance = 100 + 25 + MARGE_GM + LONGUEUR_ROBOT/2 + 25
                        distanceA = 100 + 25 + MARGE_GM+LONGUEUR_ROBOT/2 + 170 + 25
                    elif sous_pince == 1:
                        print("22222222222222")
                        distance = 50 + 25 + MARGE_GM + LONGUEUR_ROBOT/2 + 25
                        distanceA = 50 + 25 + MARGE_GM+LONGUEUR_ROBOT/2 + 170 + 25

                    if 3<=strategie_en_cours<=5: 
                        if nb == 2:
                            # 2 Noisette ou moins
                            distance_robot_n0 = math.sqrt((x_robot_actuel - Strat_Noisettes_dans_GM[0][0])**2 + (y_robot_actuel - Strat_Noisettes_dans_GM[0][1])**2)
                            distance_robot_n1 = math.sqrt((x_robot_actuel - Strat_Noisettes_dans_GM[1][0])**2 + (y_robot_actuel - Strat_Noisettes_dans_GM[1][1])**2)
                            print("distance_robot_n0 : ",distance_robot_n0)
                            print("distance_robot_n1 : ",distance_robot_n1)
                            print("Strat_Noisettes_dans_GM avant tri : ",Strat_Noisettes_dans_GM)
                            # Tri des noisettes par distance
                            if distance_robot_n0 > distance_robot_n1:
                                temp = Strat_Noisettes_dans_GM[0]
                                Strat_Noisettes_dans_GM[0] = Strat_Noisettes_dans_GM[1]
                                Strat_Noisettes_dans_GM[1] = temp
                                distance_robot_n0, distance_robot_n1 = distance_robot_n1, distance_robot_n0
                            print("Strat_Noisettes_dans_GM après tri : ",Strat_Noisettes_dans_GM)
                            angle_Noisette_centre = math.atan2(y_centre_gm - Strat_Noisettes_dans_GM[0][1],x_centre_gm - Strat_Noisettes_dans_GM[0][0])
                            print("angle_Noisette_centre : ",math.degrees(angle_Noisette_centre))
                            x_cote = Strat_Noisettes_dans_GM[0][0] + 25*math.cos(angle_Noisette_centre)
                            y_cote = Strat_Noisettes_dans_GM[0][1] + 25*math.sin(angle_Noisette_centre)
                            print("x_cote : ",x_cote," y_cote : ",y_cote)

                            x_arrivee_1 = int(x_cote + distance*math.cos(angle_Noisette_centre))
                            y_arrivee_1 = int(y_cote + distance*math.sin(angle_Noisette_centre))
                            x_arrivee_Astar = int(x_cote + distanceA*math.cos(angle_Noisette_centre))
                            y_arrivee_Astar = int(y_cote + distanceA*math.sin(angle_Noisette_centre))
                            print("x_arrivee_1 : ",x_arrivee_1)
                            print("y_arrivee_1 : ",y_arrivee_1)
                            print("x_arrivee_Astar : ",x_arrivee_Astar)
                            print("y_arrivee_Astar : ",y_arrivee_Astar)
                            if grid_expanded[max(0, min(width - 1, int(x_arrivee_Astar // CASE_MM))), max(0, min(height - 1, int(y_arrivee_Astar // CASE_MM)))]:
                                demande_nouvelle_strat = True
                            else:
                                if pince_a_utilise == 0:
                                    if distance_Robot_strategie < distanceA:
                                        Liste_actions = [["Rotation",int(np.degrees(angle_Noisette_centre)-180)],["Consigne",x_arrivee_1,y_arrivee_1],["Rotation",int(np.degrees(angle_Noisette_centre)-180)],["Relacher",pince_a_utilise,sous_pince],["ReculerPrecis",x_arrivee_Astar,y_arrivee_Astar]]
                                    else:
                                        Liste_actions = [["Consigne",x_arrivee_Astar,y_arrivee_Astar],["Rotation",int(np.degrees(angle_Noisette_centre)-180)],["Consigne",x_arrivee_1,y_arrivee_1],["Rotation",int(np.degrees(angle_Noisette_centre)-180)],["Relacher",pince_a_utilise,sous_pince],["ReculerPrecis",x_arrivee_Astar,y_arrivee_Astar]]
                                
                                else :
                                    if distance_Robot_strategie < distanceA:
                                        Liste_actions = [["Rotation",int(np.degrees(angle_Noisette_centre))],["ReculerPrecis",x_arrivee_1,y_arrivee_1],["Rotation",int(np.degrees(angle_Noisette_centre))],["Relacher",pince_a_utilise,sous_pince],["Consigne",x_arrivee_Astar,y_arrivee_Astar]]
                                    else:
                                        Liste_actions = [["Consigne",x_arrivee_Astar,y_arrivee_Astar],["Rotation",int(np.degrees(angle_Noisette_centre))],["ReculerPrecis",x_arrivee_1,y_arrivee_1],["Rotation",int(np.degrees(angle_Noisette_centre))],["Relacher",pince_a_utilise,sous_pince],["Consigne",x_arrivee_Astar,y_arrivee_Astar]]
                                
                        else:
                            angle_Noisette_centre = math.atan2(y_centre_gm - Strat_Noisettes_dans_GM[0][1], x_centre_gm - Strat_Noisettes_dans_GM[0][0])
                            x_cote1 = Strat_Noisettes_dans_GM[0][0] + 25*math.cos(angle_Noisette_centre)
                            y_cote1 = Strat_Noisettes_dans_GM[0][1] + 25*math.sin(angle_Noisette_centre)
                            x_cote2 = Strat_Noisettes_dans_GM[0][0] + 25*math.cos(math.pi+angle_Noisette_centre)
                            y_cote2 = Strat_Noisettes_dans_GM[0][1] + 25*math.sin(math.pi+angle_Noisette_centre)
                            distance_cote_centre1 = math.sqrt((x_centre_gm - x_cote1)**2 + (y_centre_gm - y_cote1)**2)
                            distance_cote_centre2 = math.sqrt((x_centre_gm - x_cote2)**2 + (y_centre_gm - y_cote2)**2)
                            if distance_cote_centre1 > distance_cote_centre2:
                                x_cote = x_cote2
                                y_cote = y_cote2
                            else:
                                x_cote = x_cote1
                                y_cote = y_cote1

                            if sous_pince == 12 or sous_pince == 2:
                                distance = 100 + 25 + MARGE_GM + LONGUEUR_ROBOT/2 + 25 
                                distanceA = 100 + 25 + MARGE_GM+LONGUEUR_ROBOT/2 + 170 + 25
                            elif sous_pince == 1: 
                                distance = 50 + 25 + MARGE_GM + LONGUEUR_ROBOT/2 + 25
                                distanceA = 50 + 25 + MARGE_GM+LONGUEUR_ROBOT/2 + 170 + 25
                            x_arrivee_1 = x_cote + distance*math.cos(angle_Noisette_centre)
                            y_arrivee_1 = y_cote + distance*math.sin(angle_Noisette_centre)
                            x_arrivee_Astar = x_cote + distanceA*math.cos(angle_Noisette_centre)
                            y_arrivee_Astar = y_cote + distanceA*math.sin(angle_Noisette_centre)
                            if grid_expanded[max(0, min(width - 1, int(x_arrivee_Astar // CASE_MM))), max(0, min(height - 1, int(y_arrivee_Astar // CASE_MM)))]:
                                demande_nouvelle_strat = True
                            else:
                                if pince_a_utilise == 0:
                                    if distance_Robot_strategie < distanceA:
                                        Liste_actions = [["Rotation",int(np.degrees(angle_Noisette_centre)-180)],["Consigne",x_arrivee_1,y_arrivee_1],["Rotation",int(np.degrees(angle_Noisette_centre)-180)],["Relacher",pince_a_utilise,sous_pince],["ReculerPrecis",x_arrivee_Astar,y_arrivee_Astar]]
                                    else:
                                        Liste_actions = [["Consigne",x_arrivee_Astar,y_arrivee_Astar],["Rotation",int(np.degrees(angle_Noisette_centre)-180)],["Consigne",x_arrivee_1,y_arrivee_1],["Rotation",int(np.degrees(angle_Noisette_centre)-180)],["Relacher",pince_a_utilise,sous_pince],["ReculerPrecis",x_arrivee_Astar,y_arrivee_Astar]]
                                else :
                                    if distance_Robot_strategie < distanceA:
                                        Liste_actions = [["Rotation",int(np.degrees(angle_Noisette_centre))],["ReculerPrecis",x_arrivee_1,y_arrivee_1],["Rotation",int(np.degrees(angle_Noisette_centre))],["Relacher",pince_a_utilise,sous_pince],["Consigne",x_arrivee_Astar,y_arrivee_Astar]]
                                    else:
                                        Liste_actions = [["Consigne",x_arrivee_Astar,y_arrivee_Astar],["Rotation",int(np.degrees(angle_Noisette_centre))],["ReculerPrecis",x_arrivee_1,y_arrivee_1],["Rotation",int(np.degrees(angle_Noisette_centre))],["Relacher",pince_a_utilise,sous_pince],["Consigne",x_arrivee_Astar,y_arrivee_Astar]]
                            
                            print("Faire les 2 points de la Noisette")
                    if 0<=strategie_en_cours<=1:
                        if nb == 2:
                            # 2 Noisette ou moins
                            distance_robot_n0 = math.sqrt((Liste_zones_gm_coins[strategie_en_cours][0][0]+100 - Strat_Noisettes_dans_GM[0][0])**2 + (Liste_zones_gm_coins[strategie_en_cours][0][1] - Strat_Noisettes_dans_GM[0][1])**2)
                            distance_robot_n1 = math.sqrt((Liste_zones_gm_coins[strategie_en_cours][0][0]+100 - Strat_Noisettes_dans_GM[1][0])**2 + (Liste_zones_gm_coins[strategie_en_cours][0][1] - Strat_Noisettes_dans_GM[1][1])**2)
                            print("distance_robot_n0 : ",distance_robot_n0)
                            print("distance_robot_n1 : ",distance_robot_n1)
                            print("Strat_Noisettes_dans_GM avant tri : ",Strat_Noisettes_dans_GM)
                            # Tri des noisettes par distance
                            if distance_robot_n0 > distance_robot_n1:
                                temp = Strat_Noisettes_dans_GM[0]
                                Strat_Noisettes_dans_GM[0] = Strat_Noisettes_dans_GM[1]
                                Strat_Noisettes_dans_GM[1] = temp
                                distance_robot_n0, distance_robot_n1 = distance_robot_n1, distance_robot_n0
                            print("Strat_Noisettes_dans_GM après tri : ",Strat_Noisettes_dans_GM)
                            angle_Noisette_centre = math.atan2(Liste_zones_gm_coins[strategie_en_cours][0][1] - Strat_Noisettes_dans_GM[0][1],Liste_zones_gm_coins[strategie_en_cours][0][0]+100 - Strat_Noisettes_dans_GM[0][0])
                            print("angle_Noisette_centre : ",math.degrees(angle_Noisette_centre))
                            x_cote = Strat_Noisettes_dans_GM[0][0] + 25*math.cos(angle_Noisette_centre)
                            y_cote = Strat_Noisettes_dans_GM[0][1] + 25*math.sin(angle_Noisette_centre)
                            print("x_cote : ",x_cote," y_cote : ",y_cote)

                            x_arrivee_1 = int(x_cote + distance*math.cos(angle_Noisette_centre))
                            y_arrivee_1 = int(y_cote + distance*math.sin(angle_Noisette_centre))
                            x_arrivee_Astar = int(x_cote + distanceA*math.cos(angle_Noisette_centre))
                            y_arrivee_Astar = int(y_cote + distanceA*math.sin(angle_Noisette_centre))
                            print("x_arrivee_1 : ",x_arrivee_1)
                            print("y_arrivee_1 : ",y_arrivee_1)
                            print("x_arrivee_Astar : ",x_arrivee_Astar)
                            print("y_arrivee_Astar : ",y_arrivee_Astar)
                            #Liste_actions = [["Consigne",x_arrivee_Astar,y_arrivee_Astar],["Consigne",x_arrivee_1,y_arrivee_1]]
                            if grid_expanded[max(0, min(width - 1, int(x_arrivee_Astar // CASE_MM))), max(0, min(height - 1, int(y_arrivee_Astar // CASE_MM)))]:
                                demande_nouvelle_strat = True
                            else:
                                if pince_a_utilise == 0:
                                    if distance_Robot_strategie < distanceA:
                                        Liste_actions = [["Rotation",int(np.degrees(angle_Noisette_centre)-180)],["Consigne",x_arrivee_1,y_arrivee_1],["Rotation",int(np.degrees(angle_Noisette_centre)-180)],["Relacher",pince_a_utilise,sous_pince],["ReculerPrecis",x_arrivee_Astar,y_arrivee_Astar]]
                                    else:
                                        Liste_actions = [["Consigne",x_arrivee_Astar,y_arrivee_Astar],["Rotation",int(np.degrees(angle_Noisette_centre)-180)],["Consigne",x_arrivee_1,y_arrivee_1],["Rotation",int(np.degrees(angle_Noisette_centre)-180)],["Relacher",pince_a_utilise,sous_pince],["ReculerPrecis",x_arrivee_Astar,y_arrivee_Astar]]
                                else :
                                    if distance_Robot_strategie < distanceA:
                                        Liste_actions = [["Rotation",int(np.degrees(angle_Noisette_centre))],["ReculerPrecis",x_arrivee_1,y_arrivee_1],["Rotation",int(np.degrees(angle_Noisette_centre))],["Relacher",pince_a_utilise,sous_pince],["Consigne",x_arrivee_Astar,y_arrivee_Astar]]
                                    else:
                                        Liste_actions = [["Consigne",x_arrivee_Astar,y_arrivee_Astar],["Rotation",int(np.degrees(angle_Noisette_centre))],["ReculerPrecis",x_arrivee_1,y_arrivee_1],["Rotation",int(np.degrees(angle_Noisette_centre))],["Relacher",pince_a_utilise,sous_pince],["Consigne",x_arrivee_Astar,y_arrivee_Astar]]
                                
                        else:
                            angle_Noisette_centre = math.atan2(Liste_zones_gm_coins[strategie_en_cours][0][1] - Strat_Noisettes_dans_GM[0][1], Liste_zones_gm_coins[strategie_en_cours][0][0]+100 - Strat_Noisettes_dans_GM[0][0])
                            x_cote1 = Strat_Noisettes_dans_GM[0][0] + 25*math.cos(angle_Noisette_centre)
                            y_cote1 = Strat_Noisettes_dans_GM[0][1] + 25*math.sin(angle_Noisette_centre)
                            x_cote2 = Strat_Noisettes_dans_GM[0][0] + 25*math.cos(math.pi+angle_Noisette_centre)
                            y_cote2 = Strat_Noisettes_dans_GM[0][1] + 25*math.sin(math.pi+angle_Noisette_centre)
                            distance_cote_centre1 = math.sqrt((Liste_zones_gm_coins[strategie_en_cours][0][0]+100 - x_cote1)**2 + (Liste_zones_gm_coins[strategie_en_cours][0][1] - y_cote1)**2)
                            distance_cote_centre2 = math.sqrt((Liste_zones_gm_coins[strategie_en_cours][0][0]+100 - x_cote2)**2 + (Liste_zones_gm_coins[strategie_en_cours][0][1] - y_cote2)**2)
                            if distance_cote_centre1 > distance_cote_centre2:
                                x_cote = x_cote2
                                y_cote = y_cote2
                            else:
                                x_cote = x_cote1
                                y_cote = y_cote1

                            if sous_pince == 12 or sous_pince == 2:
                                distance = 100 + 25 + MARGE_GM + LONGUEUR_ROBOT/2 + 25 
                                distanceA = 100 + 25 + MARGE_GM+LONGUEUR_ROBOT/2 + 170 + 25
                            elif sous_pince == 1: 
                                distance = 50 + 25 + MARGE_GM + LONGUEUR_ROBOT/2 + 25
                                distanceA = 50 + 25 + MARGE_GM+LONGUEUR_ROBOT/2 + 170 + 25
                            x_arrivee_1 = x_cote + distance*math.cos(angle_Noisette_centre)
                            y_arrivee_1 = y_cote + distance*math.sin(angle_Noisette_centre)
                            x_arrivee_Astar = x_cote + distanceA*math.cos(angle_Noisette_centre)
                            y_arrivee_Astar = y_cote + distanceA*math.sin(angle_Noisette_centre)
                            if grid_expanded[max(0, min(width - 1, int(x_arrivee_Astar // CASE_MM))), max(0, min(height - 1, int(y_arrivee_Astar // CASE_MM)))]:
                                demande_nouvelle_strat = True
                            else:
                                if pince_a_utilise == 0:
                                    if distance_Robot_strategie < distanceA:
                                        Liste_actions = [["Rotation",int(np.degrees(angle_Noisette_centre)-180)],["Consigne",x_arrivee_1,y_arrivee_1],["Rotation",int(np.degrees(angle_Noisette_centre)-180)],["Relacher",pince_a_utilise,sous_pince],["ReculerPrecis",x_arrivee_Astar,y_arrivee_Astar]]
                                    else:
                                        Liste_actions = [["Consigne",x_arrivee_Astar,y_arrivee_Astar],["Rotation",int(np.degrees(angle_Noisette_centre)-180)],["Consigne",x_arrivee_1,y_arrivee_1],["Rotation",int(np.degrees(angle_Noisette_centre)-180)],["Relacher",pince_a_utilise,sous_pince],["ReculerPrecis",x_arrivee_Astar,y_arrivee_Astar]]
                                else :
                                    if distance_Robot_strategie < distanceA:
                                        Liste_actions = [["Rotation",int(np.degrees(angle_Noisette_centre))],["ReculerPrecis",x_arrivee_1,y_arrivee_1],["Rotation",int(np.degrees(angle_Noisette_centre))],["Relacher",pince_a_utilise,sous_pince],["Consigne",x_arrivee_Astar,y_arrivee_Astar]]
                                    else:
                                        Liste_actions = [["Consigne",x_arrivee_Astar,y_arrivee_Astar],["Rotation",int(np.degrees(angle_Noisette_centre))],["ReculerPrecis",x_arrivee_1,y_arrivee_1],["Rotation",int(np.degrees(angle_Noisette_centre))],["Relacher",pince_a_utilise,sous_pince],["Consigne",x_arrivee_Astar,y_arrivee_Astar]]
                            print("Faire les 2 points de la Noisette")
                    if strategie_en_cours==7 or strategie_en_cours==8 or strategie_en_cours==9:
                        if nb == 2:
                            # 2 Noisette ou moins
                            distance_robot_n0 = math.sqrt((Liste_zones_gm_coins[strategie_en_cours][0][0]+100 - Strat_Noisettes_dans_GM[0][0])**2 + (Liste_zones_gm_coins[strategie_en_cours][1][1] - Strat_Noisettes_dans_GM[0][1])**2)
                            distance_robot_n1 = math.sqrt((Liste_zones_gm_coins[strategie_en_cours][0][0]+100 - Strat_Noisettes_dans_GM[1][0])**2 + (Liste_zones_gm_coins[strategie_en_cours][1][1] - Strat_Noisettes_dans_GM[1][1])**2)
                            print("distance_robot_n0 : ",distance_robot_n0)
                            print("distance_robot_n1 : ",distance_robot_n1)
                            print("Strat_Noisettes_dans_GM avant tri : ",Strat_Noisettes_dans_GM)
                            # Tri des noisettes par distance
                            if distance_robot_n0 > distance_robot_n1:
                                temp = Strat_Noisettes_dans_GM[0]
                                Strat_Noisettes_dans_GM[0] = Strat_Noisettes_dans_GM[1]
                                Strat_Noisettes_dans_GM[1] = temp
                                distance_robot_n0, distance_robot_n1 = distance_robot_n1, distance_robot_n0
                            print("Strat_Noisettes_dans_GM après tri : ",Strat_Noisettes_dans_GM)
                            angle_Noisette_centre = math.atan2(Liste_zones_gm_coins[strategie_en_cours][1][1] - Strat_Noisettes_dans_GM[0][1],Liste_zones_gm_coins[strategie_en_cours][0][0]+100 - Strat_Noisettes_dans_GM[0][0])
                            print("angle_Noisette_centre : ",math.degrees(angle_Noisette_centre))
                            x_cote = Strat_Noisettes_dans_GM[0][0] + 25*math.cos(angle_Noisette_centre)
                            y_cote = Strat_Noisettes_dans_GM[0][1] + 25*math.sin(angle_Noisette_centre)
                            print("x_cote : ",x_cote," y_cote : ",y_cote)

                            x_arrivee_1 = int(x_cote + distance*math.cos(angle_Noisette_centre))
                            y_arrivee_1 = int(y_cote + distance*math.sin(angle_Noisette_centre))
                            x_arrivee_Astar = int(x_cote + distanceA*math.cos(angle_Noisette_centre))
                            y_arrivee_Astar = int(y_cote + distanceA*math.sin(angle_Noisette_centre))
                            print("x_arrivee_1 : ",x_arrivee_1)
                            print("y_arrivee_1 : ",y_arrivee_1)
                            print("x_arrivee_Astar : ",x_arrivee_Astar)
                            print("y_arrivee_Astar : ",y_arrivee_Astar)

                            #Liste_actions = [["Consigne",x_arrivee_Astar,y_arrivee_Astar],["Consigne",x_arrivee_1,y_arrivee_1]]
                            if grid_expanded[max(0, min(width - 1, int(x_arrivee_Astar // CASE_MM))), max(0, min(height - 1, int(y_arrivee_Astar // CASE_MM)))]:
                                demande_nouvelle_strat = True
                            else:
                                if pince_a_utilise == 0:
                                    if distance_Robot_strategie < distanceA:
                                        Liste_actions = [["Rotation",int(np.degrees(angle_Noisette_centre)-180)],["Consigne",x_arrivee_1,y_arrivee_1],["Rotation",int(np.degrees(angle_Noisette_centre)-180)],["Relacher",pince_a_utilise,sous_pince],["ReculerPrecis",x_arrivee_Astar,y_arrivee_Astar]]
                                    else:
                                        Liste_actions = [["Consigne",x_arrivee_Astar,y_arrivee_Astar],["Rotation",int(np.degrees(angle_Noisette_centre)-180)],["Consigne",x_arrivee_1,y_arrivee_1],["Rotation",int(np.degrees(angle_Noisette_centre)-180)],["Relacher",pince_a_utilise,sous_pince],["ReculerPrecis",x_arrivee_Astar,y_arrivee_Astar]]
                                else :
                                    if distance_Robot_strategie < distanceA:
                                        Liste_actions = [["Rotation",int(np.degrees(angle_Noisette_centre))],["ReculerPrecis",x_arrivee_1,y_arrivee_1],["Rotation",int(np.degrees(angle_Noisette_centre))],["Relacher",pince_a_utilise,sous_pince],["Consigne",x_arrivee_Astar,y_arrivee_Astar]]
                                    else:
                                        Liste_actions = [["Consigne",x_arrivee_Astar,y_arrivee_Astar],["Rotation",int(np.degrees(angle_Noisette_centre))],["ReculerPrecis",x_arrivee_1,y_arrivee_1],["Rotation",int(np.degrees(angle_Noisette_centre))],["Relacher",pince_a_utilise,sous_pince],["Consigne",x_arrivee_Astar,y_arrivee_Astar]]
                        else:
                            angle_Noisette_centre = math.atan2(Liste_zones_gm_coins[strategie_en_cours][0][1] - Strat_Noisettes_dans_GM[0][1], Liste_zones_gm_coins[strategie_en_cours][0][0]+100 - Strat_Noisettes_dans_GM[0][0])
                            x_cote1 = Strat_Noisettes_dans_GM[0][0] + 25*math.cos(angle_Noisette_centre)
                            y_cote1 = Strat_Noisettes_dans_GM[0][1] + 25*math.sin(angle_Noisette_centre)
                            x_cote2 = Strat_Noisettes_dans_GM[0][0] + 25*math.cos(math.pi+angle_Noisette_centre)
                            y_cote2 = Strat_Noisettes_dans_GM[0][1] + 25*math.sin(math.pi+angle_Noisette_centre)
                            distance_cote_centre1 = math.sqrt((Liste_zones_gm_coins[strategie_en_cours][0][0]+100 - x_cote1)**2 + (Liste_zones_gm_coins[strategie_en_cours][0][1] - y_cote1)**2)
                            distance_cote_centre2 = math.sqrt((Liste_zones_gm_coins[strategie_en_cours][0][0]+100 - x_cote2)**2 + (Liste_zones_gm_coins[strategie_en_cours][0][1] - y_cote2)**2)
                            if distance_cote_centre1 > distance_cote_centre2:
                                x_cote = x_cote2
                                y_cote = y_cote2
                            else:
                                x_cote = x_cote1
                                y_cote = y_cote1

                            if sous_pince == 12 or sous_pince == 2:
                                distance = 100 + 25 + MARGE_GM + LONGUEUR_ROBOT/2 + 25 
                                distanceA = 100 + 25 + MARGE_GM+LONGUEUR_ROBOT/2 + 170 + 25
                            elif sous_pince == 1: 
                                distance = 50 + 25 + MARGE_GM + LONGUEUR_ROBOT/2 + 25
                                distanceA = 50 + 25 + MARGE_GM+LONGUEUR_ROBOT/2 + 170 + 25
                            x_arrivee_1 = x_cote + distance*math.cos(angle_Noisette_centre)
                            y_arrivee_1 = y_cote + distance*math.sin(angle_Noisette_centre)
                            x_arrivee_Astar = x_cote + distanceA*math.cos(angle_Noisette_centre)
                            y_arrivee_Astar = y_cote + distanceA*math.sin(angle_Noisette_centre)
                            if grid_expanded[max(0, min(width - 1, int(x_arrivee_Astar // CASE_MM))), max(0, min(height - 1, int(y_arrivee_Astar // CASE_MM)))]:
                                demande_nouvelle_strat = True
                            else:
                                if pince_a_utilise == 0:
                                    if distance_Robot_strategie < distanceA:
                                        Liste_actions = [["Rotation",int(np.degrees(angle_Noisette_centre)-180)],["Consigne",x_arrivee_1,y_arrivee_1],["Rotation",int(np.degrees(angle_Noisette_centre)-180)],["Relacher",pince_a_utilise,sous_pince],["ReculerPrecis",x_arrivee_Astar,y_arrivee_Astar]]
                                    else:
                                        Liste_actions = [["Consigne",x_arrivee_Astar,y_arrivee_Astar],["Rotation",int(np.degrees(angle_Noisette_centre)-180)],["Consigne",x_arrivee_1,y_arrivee_1],["Rotation",int(np.degrees(angle_Noisette_centre)-180)],["Relacher",pince_a_utilise,sous_pince],["ReculerPrecis",x_arrivee_Astar,y_arrivee_Astar]]
                                else :
                                    if distance_Robot_strategie < distanceA:
                                        Liste_actions = [["Rotation",int(np.degrees(angle_Noisette_centre))],["ReculerPrecis",x_arrivee_1,y_arrivee_1],["Rotation",int(np.degrees(angle_Noisette_centre))],["Relacher",pince_a_utilise,sous_pince],["Consigne",x_arrivee_Astar,y_arrivee_Astar]]
                                    else:
                                        Liste_actions = [["Consigne",x_arrivee_Astar,y_arrivee_Astar],["Rotation",int(np.degrees(angle_Noisette_centre))],["ReculerPrecis",x_arrivee_1,y_arrivee_1],["Rotation",int(np.degrees(angle_Noisette_centre))],["Relacher",pince_a_utilise,sous_pince],["Consigne",x_arrivee_Astar,y_arrivee_Astar]]
                            print("Faire les 2 points de la Noisette")

                    if strategie_en_cours==6:
                        if nb == 2:
                            # 2 Noisette ou moins
                            distance_robot_n0 = math.sqrt((Liste_zones_gm_coins[strategie_en_cours][0][0] - Strat_Noisettes_dans_GM[0][0])**2 + (Liste_zones_gm_coins[strategie_en_cours][0][1]+100 - Strat_Noisettes_dans_GM[0][1])**2)
                            distance_robot_n1 = math.sqrt((Liste_zones_gm_coins[strategie_en_cours][0][0] - Strat_Noisettes_dans_GM[1][0])**2 + (Liste_zones_gm_coins[strategie_en_cours][0][1]+100 - Strat_Noisettes_dans_GM[1][1])**2)
                            print("distance_robot_n0 : ",distance_robot_n0)
                            print("distance_robot_n1 : ",distance_robot_n1)
                            print("Strat_Noisettes_dans_GM avant tri : ",Strat_Noisettes_dans_GM)
                            # Tri des noisettes par distance
                            if distance_robot_n0 > distance_robot_n1:
                                temp = Strat_Noisettes_dans_GM[0]
                                Strat_Noisettes_dans_GM[0] = Strat_Noisettes_dans_GM[1]
                                Strat_Noisettes_dans_GM[1] = temp
                                distance_robot_n0, distance_robot_n1 = distance_robot_n1, distance_robot_n0
                            print("Strat_Noisettes_dans_GM après tri : ",Strat_Noisettes_dans_GM)
                            angle_Noisette_centre = math.atan2(Liste_zones_gm_coins[strategie_en_cours][0][1]+100 - Strat_Noisettes_dans_GM[0][1],Liste_zones_gm_coins[strategie_en_cours][0][0] - Strat_Noisettes_dans_GM[0][0])
                            print("angle_Noisette_centre : ",math.degrees(angle_Noisette_centre))
                            x_cote = Strat_Noisettes_dans_GM[0][0] + 25*math.cos(angle_Noisette_centre)
                            y_cote = Strat_Noisettes_dans_GM[0][1] + 25*math.sin(angle_Noisette_centre)
                            print("x_cote : ",x_cote," y_cote : ",y_cote)

                            x_arrivee_1 = int(x_cote + distance*math.cos(angle_Noisette_centre))
                            y_arrivee_1 = int(y_cote + distance*math.sin(angle_Noisette_centre))
                            x_arrivee_Astar = int(x_cote + distanceA*math.cos(angle_Noisette_centre))
                            y_arrivee_Astar = int(y_cote + distanceA*math.sin(angle_Noisette_centre))
                            print("x_arrivee_1 : ",x_arrivee_1)
                            print("y_arrivee_1 : ",y_arrivee_1)
                            print("x_arrivee_Astar : ",x_arrivee_Astar)
                            print("y_arrivee_Astar : ",y_arrivee_Astar)
                            #Liste_actions = [["Consigne",x_arrivee_Astar,y_arrivee_Astar],["Consigne",x_arrivee_1,y_arrivee_1]]
                            if grid_expanded[max(0, min(width - 1, int(x_arrivee_Astar // CASE_MM))), max(0, min(height - 1, int(y_arrivee_Astar // CASE_MM)))]:
                                demande_nouvelle_strat = True
                            else:
                                if pince_a_utilise == 0:
                                    if distance_Robot_strategie < distanceA:
                                        Liste_actions = [["Rotation",int(np.degrees(angle_Noisette_centre)-180)],["Consigne",x_arrivee_1,y_arrivee_1],["Rotation",int(np.degrees(angle_Noisette_centre)-180)],["Relacher",pince_a_utilise,sous_pince],["ReculerPrecis",x_arrivee_Astar,y_arrivee_Astar]]
                                    else:
                                        Liste_actions = [["Consigne",x_arrivee_Astar,y_arrivee_Astar],["Rotation",int(np.degrees(angle_Noisette_centre)-180)],["Consigne",x_arrivee_1,y_arrivee_1],["Rotation",int(np.degrees(angle_Noisette_centre)-180)],["Relacher",pince_a_utilise,sous_pince],["ReculerPrecis",x_arrivee_Astar,y_arrivee_Astar]]
                                else :
                                    if distance_Robot_strategie < distanceA:
                                        Liste_actions = [["Rotation",int(np.degrees(angle_Noisette_centre))],["ReculerPrecis",x_arrivee_1,y_arrivee_1],["Rotation",int(np.degrees(angle_Noisette_centre))],["Relacher",pince_a_utilise,sous_pince],["Consigne",x_arrivee_Astar,y_arrivee_Astar]]
                                    else:
                                        Liste_actions = [["Consigne",x_arrivee_Astar,y_arrivee_Astar],["Rotation",int(np.degrees(angle_Noisette_centre))],["ReculerPrecis",x_arrivee_1,y_arrivee_1],["Rotation",int(np.degrees(angle_Noisette_centre))],["Relacher",pince_a_utilise,sous_pince],["Consigne",x_arrivee_Astar,y_arrivee_Astar]]
                        else:

                            angle_Noisette_centre = math.atan2(Liste_zones_gm_coins[strategie_en_cours][0][1]+100 - Strat_Noisettes_dans_GM[0][1], Liste_zones_gm_coins[strategie_en_cours][0][0] - Strat_Noisettes_dans_GM[0][0])
                            x_cote1 = Strat_Noisettes_dans_GM[0][0] + 25*math.cos(angle_Noisette_centre)
                            y_cote1 = Strat_Noisettes_dans_GM[0][1] + 25*math.sin(angle_Noisette_centre)
                            x_cote2 = Strat_Noisettes_dans_GM[0][0] + 25*math.cos(math.pi+angle_Noisette_centre)
                            y_cote2 = Strat_Noisettes_dans_GM[0][1] + 25*math.sin(math.pi+angle_Noisette_centre)
                            distance_cote_centre1 = math.sqrt((Liste_zones_gm_coins[strategie_en_cours][0][0]+100 - x_cote1)**2 + (Liste_zones_gm_coins[strategie_en_cours][0][1] - y_cote1)**2)
                            distance_cote_centre2 = math.sqrt((Liste_zones_gm_coins[strategie_en_cours][0][0]+100 - x_cote2)**2 + (Liste_zones_gm_coins[strategie_en_cours][0][1] - y_cote2)**2)
                            if distance_cote_centre1 > distance_cote_centre2:
                                x_cote = x_cote2
                                y_cote = y_cote2
                            else:
                                x_cote = x_cote1
                                y_cote = y_cote1
                            print("x_cote1 : ",x_cote1," y_cote1 : ",y_cote1)
                            print("x_cote2 : ",x_cote2," y_cote2 : ",y_cote2)
                            print("x_cote : ",x_cote," y_cote : ",y_cote)
                            if sous_pince == 12 or sous_pince == 2:
                                distance = 100 + 25 + MARGE_GM + LONGUEUR_ROBOT/2
                                distanceA = 100 + 25 + MARGE_GM+LONGUEUR_ROBOT/2 + 170
                            elif sous_pince == 1: 
                                distance = 50 + 25 + MARGE_GM + LONGUEUR_ROBOT/2
                                distanceA = 50 + 25 + MARGE_GM+LONGUEUR_ROBOT/2 + 170
                            print("angle_Noisette_centre : ",math.degrees(angle_Noisette_centre))
                            x_arrivee_1 = x_cote + distance*math.cos(angle_Noisette_centre)
                            y_arrivee_1 = y_cote + distance*math.sin(angle_Noisette_centre)
                            x_arrivee_Astar = x_cote + distanceA*math.cos(angle_Noisette_centre)
                            y_arrivee_Astar = y_cote + distanceA*math.sin(angle_Noisette_centre)
                            print("x_arrivee_1 : ",x_arrivee_1)
                            print("y_arrivee_1 : ",y_arrivee_1)
                            print("x_arrivee_Astar : ",x_arrivee_Astar)
                            print("y_arrivee_Astar : ",y_arrivee_Astar)
                            if grid_expanded[max(0, min(width - 1, int(x_arrivee_Astar // CASE_MM))), max(0, min(height - 1, int(y_arrivee_Astar // CASE_MM)))]:
                                demande_nouvelle_strat = True
                                print("patate")
                            else:
                                if pince_a_utilise == 0:
                                    if distance_Robot_strategie < distanceA:
                                        Liste_actions = [["Rotation",int(np.degrees(angle_Noisette_centre)-180)],["Consigne",x_arrivee_1,y_arrivee_1],["Rotation",int(np.degrees(angle_Noisette_centre)-180)],["Relacher",pince_a_utilise,sous_pince],["ReculerPrecis",x_arrivee_Astar,y_arrivee_Astar]]
                                    else:
                                        Liste_actions = [["Consigne",x_arrivee_Astar,y_arrivee_Astar],["Rotation",int(np.degrees(angle_Noisette_centre)-180)],["Consigne",x_arrivee_1,y_arrivee_1],["Rotation",int(np.degrees(angle_Noisette_centre)-180)],["Relacher",pince_a_utilise,sous_pince],["ReculerPrecis",x_arrivee_Astar,y_arrivee_Astar]]
                                else :
                                    if distance_Robot_strategie < distanceA:
                                        Liste_actions = [["Rotation",int(np.degrees(angle_Noisette_centre))],["ReculerPrecis",x_arrivee_1,y_arrivee_1],["Rotation",int(np.degrees(angle_Noisette_centre))],["Relacher",pince_a_utilise,sous_pince],["Consigne",x_arrivee_Astar,y_arrivee_Astar]]
                                    else:
                                        Liste_actions = [["Consigne",x_arrivee_Astar,y_arrivee_Astar],["Rotation",int(np.degrees(angle_Noisette_centre))],["ReculerPrecis",x_arrivee_1,y_arrivee_1],["Rotation",int(np.degrees(angle_Noisette_centre))],["Relacher",pince_a_utilise,sous_pince],["Consigne",x_arrivee_Astar,y_arrivee_Astar]]
                            print("Faire les 2 points de la Noisette")
                    if strategie_en_cours==2:
                        if nb == 2:
                            # 2 Noisette ou moins
                            distance_robot_n0 = math.sqrt((Liste_zones_gm_coins[strategie_en_cours][1][0] - Strat_Noisettes_dans_GM[0][0])**2 + (Liste_zones_gm_coins[strategie_en_cours][0][1]+100 - Strat_Noisettes_dans_GM[0][1])**2)
                            distance_robot_n1 = math.sqrt((Liste_zones_gm_coins[strategie_en_cours][1][0] - Strat_Noisettes_dans_GM[1][0])**2 + (Liste_zones_gm_coins[strategie_en_cours][0][1]+100 - Strat_Noisettes_dans_GM[1][1])**2)
                            print("distance_robot_n0 : ",distance_robot_n0)
                            print("distance_robot_n1 : ",distance_robot_n1)
                            print("Strat_Noisettes_dans_GM avant tri : ",Strat_Noisettes_dans_GM)
                            # Tri des noisettes par distance
                            if distance_robot_n0 > distance_robot_n1:
                                temp = Strat_Noisettes_dans_GM[0]
                                Strat_Noisettes_dans_GM[0] = Strat_Noisettes_dans_GM[1]
                                Strat_Noisettes_dans_GM[1] = temp
                                distance_robot_n0, distance_robot_n1 = distance_robot_n1, distance_robot_n0
                            print("Strat_Noisettes_dans_GM après tri : ",Strat_Noisettes_dans_GM)
                            angle_Noisette_centre = math.atan2(Liste_zones_gm_coins[strategie_en_cours][0][1]+100 - Strat_Noisettes_dans_GM[0][1],Liste_zones_gm_coins[strategie_en_cours][1][0] - Strat_Noisettes_dans_GM[0][0])
                            print("angle_Noisette_centre : ",math.degrees(angle_Noisette_centre))
                            x_cote = Strat_Noisettes_dans_GM[0][0] + 25*math.cos(angle_Noisette_centre)
                            y_cote = Strat_Noisettes_dans_GM[0][1] + 25*math.sin(angle_Noisette_centre)
                            print("x_cote : ",x_cote," y_cote : ",y_cote)

                            x_arrivee_1 = int(x_cote + distance*math.cos(angle_Noisette_centre))
                            y_arrivee_1 = int(y_cote + distance*math.sin(angle_Noisette_centre))
                            x_arrivee_Astar = int(x_cote + distanceA*math.cos(angle_Noisette_centre))
                            y_arrivee_Astar = int(y_cote + distanceA*math.sin(angle_Noisette_centre))
                            print("x_arrivee_1 : ",x_arrivee_1)
                            print("y_arrivee_1 : ",y_arrivee_1)
                            print("x_arrivee_Astar : ",x_arrivee_Astar)
                            print("y_arrivee_Astar : ",y_arrivee_Astar)
                            #Liste_actions = [["Consigne",x_arrivee_Astar,y_arrivee_Astar],["Consigne",x_arrivee_1,y_arrivee_1]]
                            if grid_expanded[max(0, min(width - 1, int(x_arrivee_Astar // CASE_MM))), max(0, min(height - 1, int(y_arrivee_Astar // CASE_MM)))]:
                                demande_nouvelle_strat = True
                            else:
                                if pince_a_utilise == 0:
                                    if distance_Robot_strategie < distanceA:
                                        Liste_actions = [["Rotation",int(np.degrees(angle_Noisette_centre)-180)],["Consigne",x_arrivee_1,y_arrivee_1],["Rotation",int(np.degrees(angle_Noisette_centre)-180)],["Relacher",pince_a_utilise,sous_pince],["ReculerPrecis",x_arrivee_Astar,y_arrivee_Astar]]
                                    else:
                                        Liste_actions = [["Consigne",x_arrivee_Astar,y_arrivee_Astar],["Rotation",int(np.degrees(angle_Noisette_centre)-180)],["Consigne",x_arrivee_1,y_arrivee_1],["Rotation",int(np.degrees(angle_Noisette_centre)-180)],["Relacher",pince_a_utilise,sous_pince],["ReculerPrecis",x_arrivee_Astar,y_arrivee_Astar]]
                                else :
                                    if distance_Robot_strategie < distanceA:
                                        Liste_actions = [["Rotation",int(np.degrees(angle_Noisette_centre))],["ReculerPrecis",x_arrivee_1,y_arrivee_1],["Rotation",int(np.degrees(angle_Noisette_centre))],["Relacher",pince_a_utilise,sous_pince],["Consigne",x_arrivee_Astar,y_arrivee_Astar]]
                                    else:
                                        Liste_actions = [["Consigne",x_arrivee_Astar,y_arrivee_Astar],["Rotation",int(np.degrees(angle_Noisette_centre))],["ReculerPrecis",x_arrivee_1,y_arrivee_1],["Rotation",int(np.degrees(angle_Noisette_centre))],["Relacher",pince_a_utilise,sous_pince],["Consigne",x_arrivee_Astar,y_arrivee_Astar]]
                        else:
                            angle_Noisette_centre = math.atan2(Liste_zones_gm_coins[strategie_en_cours][0][1]+100 - Strat_Noisettes_dans_GM[0][1], Liste_zones_gm_coins[strategie_en_cours][1][0] - Strat_Noisettes_dans_GM[0][0])
                            x_cote1 = Strat_Noisettes_dans_GM[0][0] + 25*math.cos(angle_Noisette_centre)
                            y_cote1 = Strat_Noisettes_dans_GM[0][1] + 25*math.sin(angle_Noisette_centre)
                            x_cote2 = Strat_Noisettes_dans_GM[0][0] + 25*math.cos(math.pi+angle_Noisette_centre)
                            y_cote2 = Strat_Noisettes_dans_GM[0][1] + 25*math.sin(math.pi+angle_Noisette_centre)
                            distance_cote_centre1 = math.sqrt((Liste_zones_gm_coins[strategie_en_cours][0][0]+100 - x_cote1)**2 + (Liste_zones_gm_coins[strategie_en_cours][1][1] - y_cote1)**2)
                            distance_cote_centre2 = math.sqrt((Liste_zones_gm_coins[strategie_en_cours][0][0]+100 - x_cote2)**2 + (Liste_zones_gm_coins[strategie_en_cours][1][1] - y_cote2)**2)
                            if distance_cote_centre1 > distance_cote_centre2:
                                x_cote = x_cote2
                                y_cote = y_cote2
                            else:
                                x_cote = x_cote1
                                y_cote = y_cote1

                            if sous_pince == 12 or sous_pince == 2:
                                distance = 100 + 25 + MARGE_GM + LONGUEUR_ROBOT/2 + 25 
                                distanceA = 100 + 25 + MARGE_GM+LONGUEUR_ROBOT/2 + 170 + 25
                            elif sous_pince == 1: 
                                distance = 50 + 25 + MARGE_GM + LONGUEUR_ROBOT/2 + 25
                                distanceA = 50 + 25 + MARGE_GM+LONGUEUR_ROBOT/2 + 170 + 25
                            x_arrivee_1 = x_cote + distance*math.cos(angle_Noisette_centre)
                            y_arrivee_1 = y_cote + distance*math.sin(angle_Noisette_centre)
                            x_arrivee_Astar = x_cote + distanceA*math.cos(angle_Noisette_centre)
                            y_arrivee_Astar = y_cote + distanceA*math.sin(angle_Noisette_centre)
                            if grid_expanded[max(0, min(width - 1, int(x_arrivee_Astar // CASE_MM))), max(0, min(height - 1, int(y_arrivee_Astar // CASE_MM)))]:
                                demande_nouvelle_strat = True
                            else:
                                if pince_a_utilise == 0:
                                    if distance_Robot_strategie < distanceA:
                                        Liste_actions = [["Rotation",int(np.degrees(angle_Noisette_centre)-180)],["Consigne",x_arrivee_1,y_arrivee_1],["Rotation",int(np.degrees(angle_Noisette_centre)-180)],["Relacher",pince_a_utilise,sous_pince],["ReculerPrecis",x_arrivee_Astar,y_arrivee_Astar]]
                                    else:
                                        Liste_actions = [["Consigne",x_arrivee_Astar,y_arrivee_Astar],["Rotation",int(np.degrees(angle_Noisette_centre)-180)],["Consigne",x_arrivee_1,y_arrivee_1],["Rotation",int(np.degrees(angle_Noisette_centre)-180)],["Relacher",pince_a_utilise,sous_pince],["ReculerPrecis",x_arrivee_Astar,y_arrivee_Astar]]
                                else :
                                    if distance_Robot_strategie < distanceA:
                                        Liste_actions = [["Rotation",int(np.degrees(angle_Noisette_centre))],["ReculerPrecis",x_arrivee_1,y_arrivee_1],["Rotation",int(np.degrees(angle_Noisette_centre))],["Relacher",pince_a_utilise,sous_pince],["Consigne",x_arrivee_Astar,y_arrivee_Astar]]
                                    else:
                                        Liste_actions = [["Consigne",x_arrivee_Astar,y_arrivee_Astar],["Rotation",int(np.degrees(angle_Noisette_centre))],["ReculerPrecis",x_arrivee_1,y_arrivee_1],["Rotation",int(np.degrees(angle_Noisette_centre))],["Relacher",pince_a_utilise,sous_pince],["Consigne",x_arrivee_Astar,y_arrivee_Astar]]
                            print("Faire les 2 points de la Noisette")
            else:
                if sous_pince == 12 or sous_pince == 2:
                    print("33333333333333")
                    distance = 100 + 25 + MARGE_GM + LONGUEUR_ROBOT/2
                    distanceA = 100 + 25 + MARGE_GM+LONGUEUR_ROBOT/2 + 170
                elif sous_pince == 1:
                    print("4444444444444")
                    distance = 50 + 25 + MARGE_GM + LONGUEUR_ROBOT/2
                    distanceA = 50 + 25 + MARGE_GM+LONGUEUR_ROBOT/2 + 170

                if 3<=strategie_en_cours<=5: 
                    angle_robot_gm = np.degrees(math.atan2(y_centre_gm - y_robot_actuel, x_centre_gm - x_robot_actuel))
                    angle_robot_gm += 360
                    angle_robot_gm %= 360
                    print("angle_robot_gm : ",angle_robot_gm)
                    if 45<=angle_robot_gm<135:
                        print("haut")
                        x_cote = (Liste_zones_gm_coins[strategie_en_cours][0][0]+Liste_zones_gm_coins[strategie_en_cours][1][0])/2
                        y_cote = Liste_zones_gm_coins[strategie_en_cours][1][1]
                    if 0<=angle_robot_gm<45 or 315<=angle_robot_gm<360:
                        print("droite")
                        x_cote = Liste_zones_gm_coins[strategie_en_cours][1][0]
                        y_cote = (Liste_zones_gm_coins[strategie_en_cours][0][1]+Liste_zones_gm_coins[strategie_en_cours][1][1])/2
                    if 135<=angle_robot_gm<225:
                        print("gauche")
                        x_cote = Liste_zones_gm_coins[strategie_en_cours][0][0]
                        y_cote = (Liste_zones_gm_coins[strategie_en_cours][0][1]+Liste_zones_gm_coins[strategie_en_cours][1][1])/2
                    if 225<=angle_robot_gm<315:
                        print("bas")
                        x_cote = (Liste_zones_gm_coins[strategie_en_cours][0][0]+Liste_zones_gm_coins[strategie_en_cours][1][0])/2
                        y_cote = Liste_zones_gm_coins[strategie_en_cours][0][1]

                    print("x_cote : ",x_cote,"  y_cote : ",y_cote)

                    angle_centre_cote = math.atan2(y_centre_gm - y_cote, x_centre_gm - x_cote)
                    print("angle_centre_cote : ",np.degrees(angle_centre_cote))
                    x_arrivee_1 = x_cote + distance*math.cos(angle_centre_cote)
                    y_arrivee_1 = y_cote + distance*math.sin(angle_centre_cote)
                    x_arrivee_Astar = x_cote + distanceA*math.cos(angle_centre_cote)
                    y_arrivee_Astar = y_cote + distanceA*math.sin(angle_centre_cote)

                    x_poussee = x_cote + 20*math.cos(angle_centre_cote)
                    y_poussee = y_cote + 20*math.sin(angle_centre_cote)

                    if grid_expanded[max(0, min(width - 1, int(x_arrivee_Astar // CASE_MM))), max(0, min(height - 1, int(y_arrivee_Astar // CASE_MM)))]:
                        print("Tourner de 90°")
                        angle_robot_gm -= 90
                        angle_robot_gm %= 360
                        print("angle_robot_gm : ",angle_robot_gm)
                        if 45<=angle_robot_gm<135:
                            print("haut")
                            x_cote = (Liste_zones_gm_coins[strategie_en_cours][0][0]+Liste_zones_gm_coins[strategie_en_cours][1][0])/2
                            y_cote = Liste_zones_gm_coins[strategie_en_cours][1][1]
                        if 0<=angle_robot_gm<45 or 315<=angle_robot_gm<360:
                            print("droite")
                            x_cote = Liste_zones_gm_coins[strategie_en_cours][1][0]
                            y_cote = (Liste_zones_gm_coins[strategie_en_cours][0][1]+Liste_zones_gm_coins[strategie_en_cours][1][1])/2
                        if 135<=angle_robot_gm<225:
                            print("gauche")
                            x_cote = Liste_zones_gm_coins[strategie_en_cours][0][0]
                            y_cote = (Liste_zones_gm_coins[strategie_en_cours][0][1]+Liste_zones_gm_coins[strategie_en_cours][1][1])/2
                        if 225<=angle_robot_gm<315:
                            print("bas")
                            x_cote = (Liste_zones_gm_coins[strategie_en_cours][0][0]+Liste_zones_gm_coins[strategie_en_cours][1][0])/2
                            y_cote = Liste_zones_gm_coins[strategie_en_cours][0][1]

                        print("x_cote : ",x_cote,"  y_cote : ",y_cote)
                        angle_centre_cote = math.atan2(y_centre_gm - y_cote, x_centre_gm - x_cote)
                        print("angle_centre_cote : ",np.degrees(angle_centre_cote))
                        x_arrivee_1 = x_cote + distance*math.cos(angle_centre_cote)
                        y_arrivee_1 = y_cote + distance*math.sin(angle_centre_cote)
                        x_arrivee_Astar = x_cote + distanceA*math.cos(angle_centre_cote)
                        y_arrivee_Astar = y_cote + distanceA*math.sin(angle_centre_cote)
                        x_poussee = x_cote + 20*math.cos(angle_centre_cote)
                        y_poussee = y_cote + 20*math.sin(angle_centre_cote)
                        if grid_expanded[max(0, min(width - 1, int(x_arrivee_Astar // CASE_MM))), max(0, min(height - 1, int(y_arrivee_Astar // CASE_MM)))]:
                            print("Tourner de 90°")
                            angle_robot_gm -= 90
                            angle_robot_gm %= 360
                            print("angle_robot_gm : ",angle_robot_gm)
                            if 45<=angle_robot_gm<135:
                                print("haut")
                                x_cote = (Liste_zones_gm_coins[strategie_en_cours][0][0]+Liste_zones_gm_coins[strategie_en_cours][1][0])/2
                                y_cote = Liste_zones_gm_coins[strategie_en_cours][1][1]
                            if 0<=angle_robot_gm<45 or 315<=angle_robot_gm<360:
                                print("droite")
                                x_cote = Liste_zones_gm_coins[strategie_en_cours][1][0]
                                y_cote = (Liste_zones_gm_coins[strategie_en_cours][0][1]+Liste_zones_gm_coins[strategie_en_cours][1][1])/2
                            if 135<=angle_robot_gm<225:
                                print("gauche")
                                x_cote = Liste_zones_gm_coins[strategie_en_cours][0][0]
                                y_cote = (Liste_zones_gm_coins[strategie_en_cours][0][1]+Liste_zones_gm_coins[strategie_en_cours][1][1])/2
                            if 225<=angle_robot_gm<315:
                                print("bas")
                                x_cote = (Liste_zones_gm_coins[strategie_en_cours][0][0]+Liste_zones_gm_coins[strategie_en_cours][1][0])/2
                                y_cote = Liste_zones_gm_coins[strategie_en_cours][0][1]

                            print("x_cote : ",x_cote,"  y_cote : ",y_cote)
                            angle_centre_cote = math.atan2(y_centre_gm - y_cote, x_centre_gm - x_cote)
                            print("angle_centre_cote : ",np.degrees(angle_centre_cote))
                            x_arrivee_1 = x_cote + distance*math.cos(angle_centre_cote)
                            y_arrivee_1 = y_cote + distance*math.sin(angle_centre_cote)
                            x_arrivee_Astar = x_cote + distanceA*math.cos(angle_centre_cote)
                            y_arrivee_Astar = y_cote + distanceA*math.sin(angle_centre_cote)
                            x_poussee = x_cote + 20*math.cos(angle_centre_cote)
                            y_poussee = y_cote + 20*math.sin(angle_centre_cote)
                            if grid_expanded[max(0, min(width - 1, int(x_arrivee_Astar // CASE_MM))), max(0, min(height - 1, int(y_arrivee_Astar // CASE_MM)))]:
                                print("Tourner de 90°")
                                angle_robot_gm -= 90
                                angle_robot_gm %= 360
                                print("angle_robot_gm : ",angle_robot_gm)
                                if 45<=angle_robot_gm<135:
                                    print("haut")
                                    x_cote = (Liste_zones_gm_coins[strategie_en_cours][0][0]+Liste_zones_gm_coins[strategie_en_cours][1][0])/2
                                    y_cote = Liste_zones_gm_coins[strategie_en_cours][1][1]
                                if 0<=angle_robot_gm<45 or 315<=angle_robot_gm<360:
                                    print("droite")
                                    x_cote = Liste_zones_gm_coins[strategie_en_cours][1][0]
                                    y_cote = (Liste_zones_gm_coins[strategie_en_cours][0][1]+Liste_zones_gm_coins[strategie_en_cours][1][1])/2
                                if 135<=angle_robot_gm<225:
                                    print("gauche")
                                    x_cote = Liste_zones_gm_coins[strategie_en_cours][0][0]
                                    y_cote = (Liste_zones_gm_coins[strategie_en_cours][0][1]+Liste_zones_gm_coins[strategie_en_cours][1][1])/2
                                if 225<=angle_robot_gm<315:
                                    print("bas")
                                    x_cote = (Liste_zones_gm_coins[strategie_en_cours][0][0]+Liste_zones_gm_coins[strategie_en_cours][1][0])/2
                                    y_cote = Liste_zones_gm_coins[strategie_en_cours][0][1]

                                print("x_cote : ",x_cote,"  y_cote : ",y_cote)
                                angle_centre_cote = math.atan2(y_centre_gm - y_cote, x_centre_gm - x_cote)
                                print("angle_centre_cote : ",np.degrees(angle_centre_cote))
                                x_arrivee_1 = x_cote + distance*math.cos(angle_centre_cote)
                                y_arrivee_1 = y_cote + distance*math.sin(angle_centre_cote)
                                x_arrivee_Astar = x_cote + distanceA*math.cos(angle_centre_cote)
                                y_arrivee_Astar = y_cote + distanceA*math.sin(angle_centre_cote)
                                x_poussee = x_cote + 20*math.cos(angle_centre_cote)
                                y_poussee = y_cote + 20*math.sin(angle_centre_cote)
                                if grid_expanded[max(0, min(width - 1, int(x_arrivee_Astar // CASE_MM))), max(0, min(height - 1, int(y_arrivee_Astar // CASE_MM)))]:
                                    print("GM Inacessible")
                                    demande_nouvelle_strat = True
                                else:
                                    if pince_a_utilise == 0:
                                        Liste_actions = [["Consigne",x_arrivee_1,y_arrivee_1],["Rotation",int(np.degrees(angle_centre_cote)-180)],["Relacher",pince_a_utilise,sous_pince],["ReculerPrecis",x_arrivee_Astar,y_arrivee_Astar]]
                                    else :
                                        Liste_actions = [["ReculerPrecis",x_arrivee_1,y_arrivee_1],["Rotation",int(np.degrees(angle_centre_cote))],["Relacher",pince_a_utilise,sous_pince],["Consigne",x_arrivee_Astar,y_arrivee_Astar]]
                                        
                                    if Pousser:
                                        if pince_a_utilise == 0:
                                            Liste_actions[0][0] = "ReculerPrecis" 
                                            Liste_actions.insert(0,["Consigne",x_poussee,y_poussee])
                                        else:
                                            Liste_actions[0][0] = "Consigne" 
                                            Liste_actions.insert(0,["ReculerPrecis",x_poussee,y_poussee])
                            else:
                                if pince_a_utilise == 0:
                                    Liste_actions = [["Consigne",x_arrivee_1,y_arrivee_1],["Rotation",int(np.degrees(angle_centre_cote)-180)],["Relacher",pince_a_utilise,sous_pince],["ReculerPrecis",x_arrivee_Astar,y_arrivee_Astar]]
                                else :
                                    Liste_actions = [["ReculerPrecis",x_arrivee_1,y_arrivee_1],["Rotation",int(np.degrees(angle_centre_cote))],["Relacher",pince_a_utilise,sous_pince],["Consigne",x_arrivee_Astar,y_arrivee_Astar]]
                                    
                                if Pousser:
                                    if pince_a_utilise == 0:
                                        Liste_actions[0][0] = "ReculerPrecis" 
                                        Liste_actions.insert(0,["Consigne",x_poussee,y_poussee])
                                    else:
                                        Liste_actions[0][0] = "Consigne" 
                                        Liste_actions.insert(0,["ReculerPrecis",x_poussee,y_poussee])
                        else:
                            if pince_a_utilise == 0:
                                Liste_actions = [["Consigne",x_arrivee_1,y_arrivee_1],["Rotation",int(np.degrees(angle_centre_cote)-180)],["Relacher",pince_a_utilise,sous_pince],["ReculerPrecis",x_arrivee_Astar,y_arrivee_Astar]]
                            else :
                                Liste_actions = [["ReculerPrecis",x_arrivee_1,y_arrivee_1],["Rotation",int(np.degrees(angle_centre_cote))],["Relacher",pince_a_utilise,sous_pince],["Consigne",x_arrivee_Astar,y_arrivee_Astar]]
                                
                            if Pousser:
                                if pince_a_utilise == 0:
                                    Liste_actions[0][0] = "ReculerPrecis" 
                                    Liste_actions.insert(0,["Consigne",x_poussee,y_poussee])
                                else:
                                    Liste_actions[0][0] = "Consigne" 
                                    Liste_actions.insert(0,["ReculerPrecis",x_poussee,y_poussee])
                    else:
                        if pince_a_utilise == 0:
                            Liste_actions = [["Consigne",x_arrivee_1,y_arrivee_1],["Rotation",int(np.degrees(angle_centre_cote)-180)],["Relacher",pince_a_utilise,sous_pince],["ReculerPrecis",x_arrivee_Astar,y_arrivee_Astar]]
                        else :
                            Liste_actions = [["ReculerPrecis",x_arrivee_1,y_arrivee_1],["Rotation",int(np.degrees(angle_centre_cote))],["Relacher",pince_a_utilise,sous_pince],["Consigne",x_arrivee_Astar,y_arrivee_Astar]]
                            
                        if Pousser:
                            if pince_a_utilise == 0:
                                Liste_actions[0][0] = "ReculerPrecis" 
                                Liste_actions.insert(0,["Consigne",x_poussee,y_poussee])
                            else:
                                Liste_actions[0][0] = "Consigne" 
                                Liste_actions.insert(0,["ReculerPrecis",x_poussee,y_poussee])
                else:

                    if strategie_en_cours==0 or strategie_en_cours==1:
                        
                        x_arrivee_1 = 200+Liste_zones_gm_coins[strategie_en_cours][0][0] + distance*math.cos(np.radians(180))
                        y_arrivee_1 = Liste_zones_gm_coins[strategie_en_cours][0][1] + distance*math.sin(np.radians(180))

                        x_arrivee_2 = -200+Liste_zones_gm_coins[strategie_en_cours][1][0] + distance*math.cos(np.radians(0))
                        y_arrivee_2 = Liste_zones_gm_coins[strategie_en_cours][1][1]-200 + distance*math.sin(np.radians(0))

                        x_arrivee_Astar_1 = 200+Liste_zones_gm_coins[strategie_en_cours][0][0] + distanceA*math.cos(np.radians(180))
                        y_arrivee_Astar_1 = Liste_zones_gm_coins[strategie_en_cours][0][1] + distanceA*math.sin(np.radians(180))

                        x_arrivee_Astar_2 = -200+Liste_zones_gm_coins[strategie_en_cours][1][0] + distanceA*math.cos(np.radians(0))
                        y_arrivee_Astar_2 = Liste_zones_gm_coins[strategie_en_cours][1][1]-200 + distanceA*math.sin(np.radians(0))

                        x_poussee1 = 200+Liste_zones_gm_coins[strategie_en_cours][0][0] + 20*math.cos(np.radians(180))
                        y_poussee1 = Liste_zones_gm_coins[strategie_en_cours][0][1] + 20*math.sin(np.radians(180))

                        x_poussee2 = -200+Liste_zones_gm_coins[strategie_en_cours][1][0] + 20*math.cos(np.radians(0))
                        y_poussee2 = Liste_zones_gm_coins[strategie_en_cours][1][1]-200 + 20*math.sin(np.radians(0))
                        
                        if grid_expanded[max(0, min(width - 1, int(x_arrivee_Astar_1 // CASE_MM))), max(0, min(height - 1, int(y_arrivee_Astar_1 // CASE_MM)))] and grid_expanded[max(0, min(width - 1, int(x_arrivee_Astar_2 // CASE_MM))), max(0, min(height - 1, int(y_arrivee_Astar_2 // CASE_MM)))]:
                            demande_nouvelle_strat = True
                        else:
                            if grid_expanded[max(0, min(width - 1, int(x_arrivee_Astar_2 // CASE_MM))), max(0, min(height - 1, int(y_arrivee_Astar_2 // CASE_MM)))]:
                                x_arrivee_Astar = x_arrivee_Astar_1
                                y_arrivee_Astar = y_arrivee_Astar_1
                                x_arrivee = x_arrivee_1
                                y_arrivee = y_arrivee_1
                                x_poussee = x_poussee1
                                y_poussee = y_poussee1
                            elif grid_expanded[max(0, min(width - 1, int(x_arrivee_Astar_1 // CASE_MM))), max(0, min(height - 1, int(y_arrivee_Astar_1 // CASE_MM)))]:
                                x_arrivee_Astar = x_arrivee_Astar_2
                                y_arrivee_Astar = y_arrivee_Astar_2
                                x_arrivee = x_arrivee_2
                                y_arrivee = y_arrivee_2
                                x_poussee = x_poussee2
                                y_poussee = y_poussee2
                            else:
                                distance_point1 = math.sqrt((x_arrivee_Astar_1 - x_robot_actuel)**2 + (y_arrivee_Astar_1 - y_robot_actuel)**2)
                                distance_point2 = math.sqrt((x_arrivee_Astar_2 - x_robot_actuel)**2 + (y_arrivee_Astar_2 - y_robot_actuel)**2)
                                if distance_point1 < distance_point2:
                                    x_arrivee_Astar = x_arrivee_Astar_1
                                    y_arrivee_Astar = y_arrivee_Astar_1
                                    x_arrivee = x_arrivee_1
                                    y_arrivee = y_arrivee_1
                                    x_poussee = x_poussee1
                                    y_poussee = y_poussee1
                                else:
                                    x_arrivee_Astar = x_arrivee_Astar_2
                                    y_arrivee_Astar = y_arrivee_Astar_2
                                    x_arrivee = x_arrivee_2
                                    y_arrivee = y_arrivee_2
                                    x_poussee = x_poussee2
                                    y_poussee = y_poussee2
                            
                            angle_arrivee = math.atan2(y_arrivee_Astar - y_arrivee, x_arrivee_Astar - x_arrivee)
                            if pince_a_utilise == 0:
                                Liste_actions = [["Consigne",x_arrivee,y_arrivee],["Rotation",int(np.degrees(angle_arrivee)-180)],["Relacher",pince_a_utilise,sous_pince],["ReculerPrecis",x_arrivee_Astar,y_arrivee_Astar]]
                            else :
                                Liste_actions = [["ReculerPrecis",x_arrivee,y_arrivee],["Rotation",int(np.degrees(angle_arrivee))],["Relacher",pince_a_utilise,sous_pince],["Consigne",x_arrivee_Astar,y_arrivee_Astar]]
                                
                            if Pousser:
                                if pince_a_utilise == 0:
                                    Liste_actions[0][0] = "ReculerPrecis" 
                                    Liste_actions.insert(0,["Consigne",x_poussee,y_poussee])
                                else:
                                    Liste_actions[0][0] = "Consigne" 
                                    Liste_actions.insert(0,["ReculerPrecis",x_poussee,y_poussee])

                    if strategie_en_cours==7 or strategie_en_cours==8 or strategie_en_cours==9:

                        x_arrivee_1 = 200+Liste_zones_gm_coins[strategie_en_cours][0][0] + distance*math.cos(np.radians(180))
                        y_arrivee_1 = Liste_zones_gm_coins[strategie_en_cours][0][1]+200 + distance*math.sin(np.radians(180))

                        x_arrivee_2 = -200+Liste_zones_gm_coins[strategie_en_cours][1][0] + distance*math.cos(np.radians(0))
                        y_arrivee_2 = Liste_zones_gm_coins[strategie_en_cours][1][1] + distance*math.sin(np.radians(0))

                        x_arrivee_Astar_1 = 200+Liste_zones_gm_coins[strategie_en_cours][0][0] + distanceA*math.cos(np.radians(180))
                        y_arrivee_Astar_1 = Liste_zones_gm_coins[strategie_en_cours][0][1]+200 + distanceA*math.sin(np.radians(180))

                        x_arrivee_Astar_2 = -200+Liste_zones_gm_coins[strategie_en_cours][1][0] + distanceA*math.cos(np.radians(0))
                        y_arrivee_Astar_2 = Liste_zones_gm_coins[strategie_en_cours][1][1] + distanceA*math.sin(np.radians(0))

                        x_poussee1 = 200+Liste_zones_gm_coins[strategie_en_cours][0][0] + 20*math.cos(np.radians(180))
                        y_poussee1 = Liste_zones_gm_coins[strategie_en_cours][0][1]+200 + 20*math.sin(np.radians(180))
                        
                        x_poussee2 = -200+Liste_zones_gm_coins[strategie_en_cours][1][0] + 20*math.cos(np.radians(0))
                        y_poussee2 = Liste_zones_gm_coins[strategie_en_cours][1][1] + 20*math.sin(np.radians(0))


                        if grid_expanded[max(0, min(width - 1, int(x_arrivee_Astar_1 // CASE_MM))), max(0, min(height - 1, int(y_arrivee_Astar_1 // CASE_MM)))] and grid_expanded[max(0, min(width - 1, int(x_arrivee_Astar_2 // CASE_MM))), max(0, min(height - 1, int(y_arrivee_Astar_2 // CASE_MM)))]:
                            demande_nouvelle_strat = True
                        else:
                            if grid_expanded[max(0, min(width - 1, int(x_arrivee_Astar_2 // CASE_MM))), max(0, min(height - 1, int(y_arrivee_Astar_2 // CASE_MM)))]:
                                x_arrivee_Astar = x_arrivee_Astar_1
                                y_arrivee_Astar = y_arrivee_Astar_1
                                x_arrivee = x_arrivee_1
                                y_arrivee = y_arrivee_1
                                x_poussee = x_poussee1
                                y_poussee = y_poussee1
                            elif grid_expanded[max(0, min(width - 1, int(x_arrivee_Astar_1 // CASE_MM))), max(0, min(height - 1, int(y_arrivee_Astar_1 // CASE_MM)))]:
                                    x_arrivee_Astar = x_arrivee_Astar_2
                                    y_arrivee_Astar = y_arrivee_Astar_2
                                    x_arrivee = x_arrivee_2
                                    y_arrivee = y_arrivee_2
                                    x_poussee = x_poussee2
                                    y_poussee = y_poussee2
                            else:
                                distance_point1 = math.sqrt((x_arrivee_Astar_1 - x_robot_actuel)**2 + (y_arrivee_Astar_1 - y_robot_actuel)**2)
                                distance_point2 = math.sqrt((x_arrivee_Astar_2 - x_robot_actuel)**2 + (y_arrivee_Astar_2 - y_robot_actuel)**2)
                                if distance_point1 < distance_point2:
                                    x_arrivee_Astar = x_arrivee_Astar_1
                                    y_arrivee_Astar = y_arrivee_Astar_1
                                    x_arrivee = x_arrivee_1
                                    y_arrivee = y_arrivee_1
                                    x_poussee = x_poussee1
                                    y_poussee = y_poussee1
                                else:
                                    x_arrivee_Astar = x_arrivee_Astar_2
                                    y_arrivee_Astar = y_arrivee_Astar_2
                                    x_arrivee = x_arrivee_2
                                    y_arrivee = y_arrivee_2
                                    x_poussee = x_poussee2
                                    y_poussee = y_poussee2
                            
                            angle_arrivee = math.atan2(y_arrivee_Astar - y_arrivee, x_arrivee_Astar - x_arrivee)
                            if pince_a_utilise == 0:
                                Liste_actions = [["Consigne",x_arrivee,y_arrivee],["Rotation",int(np.degrees(angle_arrivee)-180)],["Relacher",pince_a_utilise,sous_pince],["ReculerPrecis",x_arrivee_Astar,y_arrivee_Astar]]
                            else :
                                Liste_actions = [["ReculerPrecis",x_arrivee,y_arrivee],["Rotation",int(np.degrees(angle_arrivee))],["Relacher",pince_a_utilise,sous_pince],["Consigne",x_arrivee_Astar,y_arrivee_Astar]]
                            
                            if Pousser:
                                if pince_a_utilise == 0:
                                    Liste_actions[0][0] = "ReculerPrecis" 
                                    Liste_actions.insert(0,["Consigne",x_poussee,y_poussee])
                                else:
                                    Liste_actions[0][0] = "Consigne" 
                                    Liste_actions.insert(0,["ReculerPrecis",x_poussee,y_poussee])
                    if strategie_en_cours==2 or strategie_en_cours==6:

                        if strategie_en_cours==2:
                            x_arrivee_1 = Liste_zones_gm_coins[strategie_en_cours][1][0] + distance*math.cos(np.radians(-90))
                            y_arrivee_1 = Liste_zones_gm_coins[strategie_en_cours][1][1] + distance*math.sin(np.radians(-90))

                            x_arrivee_Astar_1 = Liste_zones_gm_coins[strategie_en_cours][1][0] + distanceA*math.cos(np.radians(-90))
                            y_arrivee_Astar_1 = Liste_zones_gm_coins[strategie_en_cours][1][1] + distanceA*math.sin(np.radians(-90))

                            x_arrivee_2 = Liste_zones_gm_coins[strategie_en_cours][1][0] + distance*math.cos(np.radians(90))
                            y_arrivee_2 = Liste_zones_gm_coins[strategie_en_cours][0][1] + distance*math.sin(np.radians(90))

                            x_arrivee_Astar_2 = Liste_zones_gm_coins[strategie_en_cours][1][0] + distanceA*math.cos(np.radians(90))
                            y_arrivee_Astar_2 = Liste_zones_gm_coins[strategie_en_cours][0][1] + distanceA*math.sin(np.radians(90))

                            x_poussee1 = Liste_zones_gm_coins[strategie_en_cours][1][0] + 20*math.cos(np.radians(-90))
                            y_poussee1 = Liste_zones_gm_coins[strategie_en_cours][1][1] + 20*math.sin(np.radians(-90))

                            x_poussee2 = Liste_zones_gm_coins[strategie_en_cours][1][0] + 20*math.cos(np.radians(90))
                            y_poussee2 = Liste_zones_gm_coins[strategie_en_cours][0][1] + 20*math.sin(np.radians(90))

                        if strategie_en_cours==6:
                            x_arrivee_1 = Liste_zones_gm_coins[strategie_en_cours][0][0] + distance*math.cos(np.radians(-90))
                            y_arrivee_1 = Liste_zones_gm_coins[strategie_en_cours][1][1] + distance*math.sin(np.radians(-90))

                            x_arrivee_Astar_1 = Liste_zones_gm_coins[strategie_en_cours][0][0] + distanceA*math.cos(np.radians(-90))
                            y_arrivee_Astar_1 = Liste_zones_gm_coins[strategie_en_cours][1][1] + distanceA*math.sin(np.radians(-90))

                            x_arrivee_2 = Liste_zones_gm_coins[strategie_en_cours][0][0] + distance*math.cos(np.radians(90))
                            y_arrivee_2 = Liste_zones_gm_coins[strategie_en_cours][0][1] + distance*math.sin(np.radians(90))

                            x_arrivee_Astar_2 = Liste_zones_gm_coins[strategie_en_cours][0][0] + distanceA*math.cos(np.radians(90))
                            y_arrivee_Astar_2 = Liste_zones_gm_coins[strategie_en_cours][0][1] + distanceA*math.sin(np.radians(90))

                            x_poussee1 = Liste_zones_gm_coins[strategie_en_cours][0][0] + 20*math.cos(np.radians(-90))
                            y_poussee1 = Liste_zones_gm_coins[strategie_en_cours][1][1] + 20*math.sin(np.radians(-90))

                            x_poussee2 = Liste_zones_gm_coins[strategie_en_cours][0][0] + 20*math.cos(np.radians(90))
                            y_poussee2 = Liste_zones_gm_coins[strategie_en_cours][0][1] + 20*math.sin(np.radians(90))
                        
                        if grid_expanded[max(0, min(width - 1, int(x_arrivee_Astar_1 // CASE_MM))), max(0, min(height - 1, int(y_arrivee_Astar_1 // CASE_MM)))] and grid_expanded[max(0, min(width - 1, int(x_arrivee_Astar_2 // CASE_MM))), max(0, min(height - 1, int(y_arrivee_Astar_2 // CASE_MM)))]:
                            demande_nouvelle_strat = True
                        else:
                            if grid_expanded[max(0, min(width - 1, int(x_arrivee_Astar_2 // CASE_MM))), max(0, min(height - 1, int(y_arrivee_Astar_2 // CASE_MM)))]:
                                x_arrivee_Astar = x_arrivee_Astar_1
                                y_arrivee_Astar = y_arrivee_Astar_1
                                x_arrivee = x_arrivee_1
                                y_arrivee = y_arrivee_1
                                x_poussee = x_poussee1
                                y_poussee = y_poussee1
                            elif grid_expanded[max(0, min(width - 1, int(x_arrivee_Astar_1 // CASE_MM))), max(0, min(height - 1, int(y_arrivee_Astar_1 // CASE_MM)))]:
                                    x_arrivee_Astar = x_arrivee_Astar_2
                                    y_arrivee_Astar = y_arrivee_Astar_2
                                    x_arrivee = x_arrivee_2
                                    y_arrivee = y_arrivee_2
                                    x_poussee = x_poussee2
                                    y_poussee = y_poussee2
                            else:
                                distance_point1 = math.sqrt((x_arrivee_Astar_1 - x_robot_actuel)**2 + (y_arrivee_Astar_1 - y_robot_actuel)**2)
                                distance_point2 = math.sqrt((x_arrivee_Astar_2 - x_robot_actuel)**2 + (y_arrivee_Astar_2 - y_robot_actuel)**2)
                                if distance_point1 < distance_point2:
                                    x_arrivee_Astar = x_arrivee_Astar_1
                                    y_arrivee_Astar = y_arrivee_Astar_1
                                    x_arrivee = x_arrivee_1
                                    y_arrivee = y_arrivee_1
                                    x_poussee = x_poussee1
                                    y_poussee = y_poussee1
                                else:
                                    x_arrivee_Astar = x_arrivee_Astar_2
                                    y_arrivee_Astar = y_arrivee_Astar_2
                                    x_arrivee = x_arrivee_2
                                    y_arrivee = y_arrivee_2
                                    x_poussee = x_poussee2
                                    y_poussee = y_poussee2
                            
                            angle_arrivee = math.atan2(y_arrivee_Astar - y_arrivee, x_arrivee_Astar - x_arrivee)
                            if pince_a_utilise == 0:
                                Liste_actions = [["Consigne",x_arrivee,y_arrivee],["Rotation",int(np.degrees(angle_arrivee)-180)],["Relacher",pince_a_utilise,sous_pince],["ReculerPrecis",x_arrivee_Astar,y_arrivee_Astar]]
                            else :
                                Liste_actions = [["ReculerPrecis",x_arrivee,y_arrivee],["Rotation",int(np.degrees(angle_arrivee))],["Relacher",pince_a_utilise,sous_pince],["Consigne",x_arrivee_Astar,y_arrivee_Astar]]
                            
                            if Pousser:
                                if pince_a_utilise == 0:
                                    Liste_actions[0][0] = "ReculerPrecis" 
                                    Liste_actions.insert(0,["Consigne",x_poussee,y_poussee])
                                else:
                                    Liste_actions[0][0] = "Consigne" 
                                    Liste_actions.insert(0,["ReculerPrecis",x_poussee,y_poussee])
        
            if Noisettes_stockees_dans_robot[0] == ["N","N"] or Noisettes_stockees_dans_robot[1] == ["N","N"]:
                if pince_a_utilise == 0 and Pince_Avant or pince_a_utilise == 1 and Pince_Arriere:
                    action = None
                    if Noisettes_stockees_dans_robot[pince_a_utilise][0] != couleur and Noisettes_stockees_dans_robot[pince_a_utilise][1] != couleur and Noisettes_stockees_dans_robot[pince_a_utilise] != ["N","N"]:
                        action = ["Retourner",pince_a_utilise,12]
                    elif Noisettes_stockees_dans_robot[pince_a_utilise][0] != couleur and Noisettes_stockees_dans_robot[pince_a_utilise][1] == couleur and Noisettes_stockees_dans_robot[pince_a_utilise] != ["N","N"]:
                        action = ["Retourner",pince_a_utilise,1]
                    elif Noisettes_stockees_dans_robot[pince_a_utilise][0] == couleur and Noisettes_stockees_dans_robot[pince_a_utilise][1] != couleur and Noisettes_stockees_dans_robot[pince_a_utilise] != ["N","N"]:
                        action = ["Retourner",pince_a_utilise,2]
                    else : 
                        action = None
                    print("action : ",action)
                    if action is not None:
                        for idx_action in range(len(Liste_actions)):
                            if Liste_actions[idx_action][0] in ["Relacher"]:
                                Liste_actions.insert(idx_action,action)
                                break
            else:
                if pince_a_utilise == 1 and Pince_Avant:
                    action = None
                    if Noisettes_stockees_dans_robot[0][0] != couleur and Noisettes_stockees_dans_robot[0][1] != couleur and Noisettes_stockees_dans_robot[0] != ["N","N"]:
                        action = ["Retourner",0,12]
                    elif Noisettes_stockees_dans_robot[0][0] != couleur and Noisettes_stockees_dans_robot[0][1] == couleur and Noisettes_stockees_dans_robot[0] != ["N","N"]:
                        action = ["Retourner",0,1]
                    elif Noisettes_stockees_dans_robot[0][0] == couleur and Noisettes_stockees_dans_robot[0][1] != couleur and Noisettes_stockees_dans_robot[0] != ["N","N"]:
                        action = ["Retourner",0,2]
                    else : 
                        action = None
                    print("action : ",action)
                    if action is not None:
                        for idx_action in range(len(Liste_actions)):
                            if Liste_actions[idx_action][0] in ["Relacher"]:
                                Liste_actions.insert(idx_action,action)
                                break
                        
                if pince_a_utilise == 0 and Pince_Arriere:
                    action = None
                    if Noisettes_stockees_dans_robot[1][0] != couleur and Noisettes_stockees_dans_robot[1][1] != couleur and Noisettes_stockees_dans_robot[1] != ["N","N"]:
                        action = ["Retourner",1,12]
                    elif Noisettes_stockees_dans_robot[1][0] != couleur and Noisettes_stockees_dans_robot[1][1] == couleur and Noisettes_stockees_dans_robot[1] != ["N","N"]:
                        action = ["Retourner",1,1]
                    elif Noisettes_stockees_dans_robot[1][0] == couleur and Noisettes_stockees_dans_robot[1][1] != couleur and Noisettes_stockees_dans_robot[1] != ["N","N"]:
                        action = ["Retourner",1,2]
                    else : 
                        action = None
                    
                    if action is not None:
                        for idx_action in range(len(Liste_actions)):
                            if Liste_actions[idx_action][0] in ["Relacher"]:
                                Liste_actions.insert(idx_action,action)
                                break
    elif aller_nid:
        print("Déposer au nid")
        if Noisettes_stockees_dans_robot[0] != ["N","N"]:
            pince_a_utilise = 0
        else :
            pince_a_utilise = 1
        if Noisettes_stockees_dans_robot[pince_a_utilise] == ["J","B"] or Noisettes_stockees_dans_robot[pince_a_utilise] == ["B","J"] or Noisettes_stockees_dans_robot[pince_a_utilise] == ["J","J"] or Noisettes_stockees_dans_robot[pince_a_utilise] == ["B","B"]:
            sous_pince = 12
        elif Noisettes_stockees_dans_robot[pince_a_utilise] == ["J","N"] or Noisettes_stockees_dans_robot[pince_a_utilise] == ["B","N"]:
            sous_pince = 1
        elif Noisettes_stockees_dans_robot[pince_a_utilise] == ["N","J"] or Noisettes_stockees_dans_robot[pince_a_utilise] == ["N","B"]:
            sous_pince = 2
        else:
            return [["Attente"]],True

        print("pince_a_utilise",pince_a_utilise)
        print("sous_pince : ",sous_pince)

        Strat_Noisettes_dans_GM = []
        for Noisette in Liste_noisette_xya:
            x_centre, y_centre, angle = Noisette[0], Noisette[1], Noisette[2]

            # Dimensions
            longueur = 150  # mm (dans la direction de l'angle)
            largeur = 50    # mm (perpendiculaire à l'angle)
            
            # Conversion angle en radians
            angle_rad = math.radians(angle)
            
            # Vecteurs directeurs
            dx_long = (longueur / 2) * math.cos(angle_rad)
            dy_long = (longueur / 2) * math.sin(angle_rad)
            dx_larg = (largeur / 2) * math.sin(angle_rad)  # Perpendiculaire = rotation de 90°
            dy_larg = -(largeur / 2) * math.cos(angle_rad)
            
            # Calcul des 4 coins (sens trigonométrique depuis le centre)
            Noisette_coin_hg = (x_centre - dx_long - dx_larg, y_centre - dy_long - dy_larg)  # Haut-Gauche
            Noisette_coin_hd = (x_centre + dx_long - dx_larg, y_centre + dy_long - dy_larg)  # Haut-Droite
            Noisette_coin_bd = (x_centre + dx_long + dx_larg, y_centre + dy_long + dy_larg)  # Bas-Droite
            Noisette_coin_bg = (x_centre - dx_long + dx_larg, y_centre - dy_long + dy_larg)  # Bas-Gauche

            # Vérifier si AU MOINS UN coin est dans une zone GM
            if couleur == "B":
                x_min, y_min = 2400,1550
                x_max, y_max = 3000,2000
            if couleur == "J":
                x_min, y_min = 0,1550
                x_max, y_max = 600,2000
            
            # Liste des 4 coins
            coins = [Noisette_coin_hg, Noisette_coin_hd, Noisette_coin_bd, Noisette_coin_bg]
            
            # Vérifier si au moins un coin est dans la zone
            if any(x_min <= coin[0] <= x_max and y_min <= coin[1] <= y_max for coin in coins):
                Strat_Noisettes_dans_GM.append(Noisette)

        print("Strat_Noisettes_dans_GM : ",Strat_Noisettes_dans_GM)

        if sous_pince == 12 or sous_pince == 2:
            distance = 100 + MARGE_GM + LONGUEUR_ROBOT/2
            distanceA = 100 + 25 + MARGE_GM+LONGUEUR_ROBOT/2 + 120
        elif sous_pince == 1:
            distance = 50 + MARGE_GM + LONGUEUR_ROBOT/2
            distanceA = 50 + 25 + MARGE_GM+LONGUEUR_ROBOT/2 + 120
        
        if couleur == "B":
            x_cote = 2400+LARGEUR_ROBOT/2+30
        else:
            x_cote = 600-LARGEUR_ROBOT/2-30

        if len(Strat_Noisettes_dans_GM)<6:
            y_cote = 2000-25-25-60*(len(Strat_Noisettes_dans_GM)-1)
            angle_Noisette_centre = -math.pi/2
            x_arrivee_1 = int(x_cote + distance*math.cos(angle_Noisette_centre))
            y_arrivee_1 = int(y_cote + distance*math.sin(angle_Noisette_centre))
            x_arrivee_Astar = int(x_cote + distanceA*math.cos(angle_Noisette_centre))
            y_arrivee_Astar = int(y_cote + distanceA*math.sin(angle_Noisette_centre))
            if grid_expanded[max(0, min(width - 1, int(x_arrivee_Astar // CASE_MM))), max(0, min(height - 1, int(y_arrivee_Astar // CASE_MM)))]:
                demande_nouvelle_strat = True
            else:
                if pince_a_utilise == 0:
                    Liste_actions = [["Consigne",x_arrivee_Astar,y_arrivee_Astar],["Rotation",int(np.degrees(angle_Noisette_centre)-180)],["Consigne",x_arrivee_1,y_arrivee_1],["Rotation",int(np.degrees(angle_Noisette_centre)-180)],["Relacher",pince_a_utilise,sous_pince],["ReculerPrecis",x_arrivee_Astar,y_arrivee_Astar]]
                else :
                    Liste_actions = [["Consigne",x_arrivee_Astar,y_arrivee_Astar],["Rotation",int(np.degrees(angle_Noisette_centre))],["ReculerPrecis",x_arrivee_1,y_arrivee_1],["Rotation",int(np.degrees(angle_Noisette_centre))],["Relacher",pince_a_utilise,sous_pince],["Consigne",x_arrivee_Astar,y_arrivee_Astar]]
        else:
            demande_nouvelle_strat = True 

    else:
        demande_nouvelle_strat = True


    Liste_actions.append(["Attente"])
    return Liste_actions,demande_nouvelle_strat
