Achille-92/CRAC2026/Prog_robot/affichage.py

# affichage.py - VERSION COMPLETE AVEC ZONE ENNEMI
import matplotlib.pyplot as plt
import matplotlib.image as mpimg
import matplotlib.patches as patches
import numpy as np
from matplotlib.widgets import Button
from matplotlib.lines import Line2D
from fonction import creer_zone_securite_ennemi
import tkinter as tk
from tkinter import font as tkfont

def afficher_obstacles(ax, obstacle_array, expanded_array, case_mm, 
                       show_expanded=True, show_obstacles=False):
    """
    Affiche les obstacles sur les axes matplotlib.
    
    Args:
        ax: axes matplotlib
        obstacle_array: array des positions d'obstacles (en cases)
        expanded_array: array des zones de securite (en cases), optionnel
        case_mm: taille d'une case en mm
        show_expanded: afficher ou non la zone etendue
        show_obstacles: afficher ou non les obstacles originaux
        
    Returns:
        tuple: (obstacle_scatter, expanded_scatter)
    """
    obstacle_scatter = None
    expanded_scatter = None
    
    # Obstacles principaux
    if show_obstacles and obstacle_array is not None and len(obstacle_array) > 0:
        obstacle_scatter = ax.scatter(
            obstacle_array[:, 0] * case_mm,
            obstacle_array[:, 1] * case_mm,
            c='darkgray',
            s=4,
            alpha=0.9,
            label='Obstacles',
            zorder=1
        )
    
    # Zone de securite etendue
    if show_expanded and expanded_array is not None and len(expanded_array) > 0:
        expanded_scatter = ax.scatter(
            expanded_array[:, 0] * case_mm,
            expanded_array[:, 1] * case_mm,
            c='lightcoral',
            s=1,
            alpha=0.3,
            label='Zone interdite',
            zorder=0
        )
    
    return obstacle_scatter, expanded_scatter


def afficher_zone_securite_ennemi(ax, x_ennemi, y_ennemi, r_robot, r_ennemi,
                                   marge_securite, case_mm,
                                   terrain_w_mm, terrain_h_mm,
                                   show_zone=True, show_cercle=True):
    """
    Affiche la zone de securite autour de l'ennemi.
    
    Args:
        ax: Axes matplotlib
        x_ennemi: Position x de l'ennemi en mm
        y_ennemi: Position y de l'ennemi en mm
        r_robot: Rayon du robot en mm
        r_ennemi: Rayon de l'ennemi en mm
        marge_securite: Marge de securite en mm
        case_mm: Taille d'une case en mm
        terrain_w_mm: Largeur du terrain en mm
        terrain_h_mm: Hauteur du terrain en mm
        show_zone: Afficher la zone remplie (scatter)
        show_cercle: Afficher le cercle de perimetre
    
    Returns:
        tuple: (zone_scatter, cercle_patch)
            - zone_scatter: Objet scatter de la zone (ou None)
            - cercle_patch: Objet Circle du perimetre (ou None)
    """
    zone_scatter = None
    cercle_patch = None
    
    # Creer la zone de securite
    zone_ennemi_array, R_securite = creer_zone_securite_ennemi(
        x_ennemi, y_ennemi, r_robot, r_ennemi, marge_securite,
        case_mm, terrain_w_mm, terrain_h_mm
    )
    
    # Afficher la zone remplie
    if show_zone and len(zone_ennemi_array) > 0:
        zone_scatter = ax.scatter(
            zone_ennemi_array[:, 0],
            zone_ennemi_array[:, 1],
            c='orange',
            s=2,
            alpha=0.2,
            label='Zone securite ennemi',
            zorder=2
        )
    
    # Afficher le cercle de perimetre
    if show_cercle:
        cercle_patch = plt.Circle(
            (x_ennemi, y_ennemi),
            R_securite,
            color='orange',
            fill=False,
            linestyle='--',
            linewidth=2,
            alpha=0.8,
            zorder=3
        )
        ax.add_patch(cercle_patch)
    
    return zone_scatter, cercle_patch


def mettre_a_jour_zone_ennemi(zone_scatter, cercle_patch, 
                               x_ennemi, y_ennemi, r_robot, r_ennemi,
                               marge_securite, case_mm,
                               terrain_w_mm, terrain_h_mm):
    """
    Met a jour la position de la zone de securite de l'ennemi.
    
    Args:
        zone_scatter: Objet scatter existant de la zone
        cercle_patch: Objet Circle existant du perimetre
        x_ennemi: Nouvelle position x de l'ennemi en mm
        y_ennemi: Nouvelle position y de l'ennemi en mm
        r_robot: Rayon du robot en mm
        r_ennemi: Rayon de l'ennemi en mm
        marge_securite: Marge de securite en mm
        case_mm: Taille d'une case en mm
        terrain_w_mm: Largeur du terrain en mm
        terrain_h_mm: Hauteur du terrain en mm
    
    Returns:
        tuple: (zone_scatter, cercle_patch) mis a jour
    """
    # Recalculer la zone
    zone_ennemi_array, R_securite = creer_zone_securite_ennemi(
        x_ennemi, y_ennemi, r_robot, r_ennemi, marge_securite,
        case_mm, terrain_w_mm, terrain_h_mm
    )
    
    # Mettre a jour le scatter
    if zone_scatter is not None and len(zone_ennemi_array) > 0:
        zone_scatter.set_offsets(zone_ennemi_array)
    
    # Mettre a jour le cercle
    if cercle_patch is not None:
        cercle_patch.center = (x_ennemi, y_ennemi)
        cercle_patch.radius = R_securite
    
    return zone_scatter, cercle_patch

# ============================================================================
# FONCTION UTILITAIRE
# ============================================================================

def bring_to_front(fig):
    """Force la fenetre matplotlib a repasser au premier plan."""
    try:
        manager = plt.get_current_fig_manager()
        if hasattr(manager, 'window'):
            window = manager.window
            window.attributes('-topmost', 1)
            window.attributes('-topmost', 0)
    except Exception:
        pass


# ============================================================================
# INITIALISATION DE L'AFFICHAGE
# ============================================================================

def init_affichage(x_robot_depart,y_robot_depart,R_ROBOT):
    """
    Initialise la fenetre graphique pour le robot et l'ennemi.
    Retourne les objets utiles : figure, axes, plots et boutons.
    """
    # Chargement et configuration de l'image
    img = mpimg.imread("C:/Users/achil/Desktop/Achille/IUT GEII/Crac2026/ProgGithub/CRAC2026/RPI_Algo/Piste.png")
    img = np.rot90(img, 2)  # rotation de 180°

    fig, ax = plt.subplots(figsize=(600/100, 400/100), dpi=100)
    plt.ion()
    plt.show()

    # Objets graphiques
    robot_plot = ax.scatter([], [], s=50, c='blue', marker='o', label="Robot")
    # Cercle de sécurité du robot
    cercle_robot_patch = plt.Circle(
        (x_robot_depart, y_robot_depart),
        R_ROBOT,
        color='lightgreen',
        fill=False,
        linestyle='--',
        linewidth=2,
        alpha=0.8,
        zorder=3
    )

    ax.add_patch(cercle_robot_patch)
    ennemi_plot = ax.scatter([], [], s=50, c='red', marker='o', label="Ennemi")
    consigne_plot = ax.scatter([], [], s=50, c='green', marker='x', label="Consigne")
    scat = ax.scatter([], [], s=5, c='blue', alpha=0.5, label="Points Lidar")

    ax.imshow(img, extent=[0, 3000, 0, 2000], origin='lower')
    ax.set_xlim(0, 3000)
    ax.set_ylim(0, 2250)
    ax.set_aspect('equal', adjustable='box')

    # Textes d'info
    noisette_text = ax.text(2900, 2500, "", color='black', fontsize=8, ha='left', va='top')
    chronometre_text = ax.text(2150, 2500, "", color='black', fontsize=8, ha='left', va='top')
    match_text = ax.text(1500, 2500, "", color='black', fontsize=8, ha='left', va='top')
    info_alim_rpi = ax.text(1500, 2500, "", color='black', fontsize=8, ha='left', va='top')

    robot_info_text = ax.text(1500, 2200, "", color='black', fontsize=8, ha='left', va='top')
    x_voulu_text = ax.text(1500, 2100, "", color='black', fontsize=8, ha='left', va='top')
    y_voulu_text = ax.text(2000, 2100, "", color='black', fontsize=8, ha='left', va='top')
    A_voulu_text = ax.text(2500, 2100, "", color='black', fontsize=8, ha='left', va='top')
    
    # Bouton STOP
    ax_button_stop = plt.axes([0.02, 0.93, 0.15, 0.05])
    bouton_stop = Button(ax_button_stop, 'STOP', color='red', hovercolor='orange')
    bouton_stop.label.set_fontsize(11)
    bouton_stop.label.set_color('white')

    # ⭐ NOUVEAU : Bouton START ⭐
    ax_button_start = plt.axes([0.19, 0.93, 0.15, 0.05])  # Position à droite du bouton STOP
    bouton_start = Button(ax_button_start, 'START', color='green', hovercolor='lightgreen')
    bouton_start.label.set_fontsize(11)
    bouton_start.label.set_color('white')

    # Point voulu
    point_voulu_plot, = ax.plot([], [], 'bx', markersize=10, label="Point voulu")
    # Lignes d'angle
    robot_angle_line = Line2D([0, 0], [0, 0], color='blue', linewidth=2)
    robot_angle_voulu_line = Line2D([0, 0], [0, 0], color='green', linewidth=2)
    
    fig.canvas.draw()
    background = fig.canvas.copy_from_bbox(ax.bbox)

    return (fig, ax, robot_plot, ennemi_plot, consigne_plot, scat, robot_info_text,
            ax_button_stop, bouton_stop, ax_button_start, bouton_start,
            point_voulu_plot, x_voulu_text, y_voulu_text, 
            A_voulu_text, robot_angle_line, robot_angle_voulu_line,background,info_alim_rpi,chronometre_text,cercle_robot_patch,noisette_text,match_text)
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
