Achille-92/CRAC2026/Prog_robot/calcul_mouv.py

"""
calcul_mouv.py
Adaptation du programme A* isolé au programme principal
SEULE différence : génération des obstacles via obs_manager
"""

import heapq
import math
import numpy as np
from scipy.interpolate import splprep, splev
from scipy.ndimage import binary_dilation, distance_transform_edt


# === CONSTANTES ===
DIRECTIONS = [
    ((1, 0), 1.0), ((-1, 0), 1.0), ((0, 1), 1.0), ((0, -1), 1.0),
    ((1, 1), 1.414), ((-1, -1), 1.414), ((1, -1), 1.414), ((-1, 1), 1.414)
]


# === FONCTIONS UTILITAIRES ===

def euclidienne(a, b):
    """Calcule la distance euclidienne entre deux points"""
    dx, dy = a[0] - b[0], a[1] - b[1]
    return math.sqrt(dx*dx + dy*dy)


def voisins_rapide(x, y, grid_expanded, width, height):
    """Retourne les voisins accessibles d'une case"""
    result = []
    for (dx, dy), cost in DIRECTIONS:
        nx, ny = x + dx, y + dy
        if 0 <= nx < width and 0 <= ny < height and not grid_expanded[nx, ny]:
            result.append(((nx, ny), cost))
    return result


# === A* AVEC PONDÉRATION PAR DISTANCE AUX OBSTACLES ===

def astar_safe(start, goal, grid_expanded, distance_map, width, height, safety_weight, DISTANCE_AJUSTABLE):
    """A* qui favorise les chemins éloignés des obstacles"""
    open_set = [(0, start)]
    came_from = {}
    g_score = {start: 0}
    closed_set = set()
    
    while open_set:
        _, current = heapq.heappop(open_set)
        
        if current in closed_set:
            continue
        closed_set.add(current)
        
        if current == goal:
            # Reconstruire le chemin
            path = []
            while current in came_from:
                path.append(current)
                current = came_from[current]
            path.append(start)
            path.reverse()
            return path
        
        current_g = g_score[current]
        x, y = int(current[0]), int(current[1])
        
        for (neighbor, cost) in voisins_rapide(x, y, grid_expanded, width, height):
            if neighbor in closed_set:
                continue
            
            nx, ny = int(neighbor[0]), int(neighbor[1])
            
            # Pénalité inversement proportionnelle à la distance aux obstacles
            dist_to_obstacle = distance_map[nx, ny]
            if dist_to_obstacle < DISTANCE_AJUSTABLE:
                safety_penalty = safety_weight * (DISTANCE_AJUSTABLE - dist_to_obstacle)
            else:
                safety_penalty = 0
            
            tentative_g = current_g + cost + safety_penalty
            
            if tentative_g < g_score.get(neighbor, math.inf):
                came_from[neighbor] = current
                g_score[neighbor] = tentative_g
                f_score = tentative_g + euclidienne(neighbor, goal)
                heapq.heappush(open_set, (f_score, neighbor))
    
    return None


# === SIMPLIFICATION SÉCURISÉE DU CHEMIN ===
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
