Achille-92/CRAC2026/(commit log)

2025-09-12 Create LidarTest2
2025-09-12 Update LidarTest2
2025-09-14 Update and rename LidarTest2 to Test_Lidar_Debug
2025-09-14 Update and rename Test_Lidar_Debug to Lidar_moyen
    Fait chauffer la rpi
    Buffer saturé
    Affichage marche moyen
2025-09-15 Coordonnées des points par rapport au Lidar
2025-09-15 Coordonnées des points avec les co du robot
2025-09-15 Update and rename Test_Lidar.py to LidarCoordonnées.py
2025-09-15 Create LidarCHATGPT
2025-09-23 À tester
    3 threads propres
    Moyennage de la position du robot ennemi, calcul de sa vitesse et de son angle
2025-09-24 Update LidarProgrammePropre
2025-10-06 Update and rename Lidar_CAN_Odometrie.py to Propre_Lidar_Barycentre_Odometrie.py
2025-10-17 Update CAN filters and initial robot angle
2025-10-18 Add lidar initialization and point calculation functions
    Initialise and calculates points using RPLidar.
2025-10-18 Refactor lidar thread initialization and logging
2025-10-18 Refactor lidar thread management in main.py
2025-10-18 Version init_affichage modulaire
    Refactor lidar initialization and threading logic. Introduce a new function to calculate points from lidar scans.
2025-10-18 Refactor buffer sizes for lidar and calculations
2025-10-18 Refactor battery management and visualization logic
    Updated battery voltage values and adjusted rectangle rendering logic based on battery percentage. Added condition to update colors and text display for battery status.
2025-10-18 Refactor CAN bus setup and enemy calculation logic
2025-10-19 angle modulo 2PI + point de trajectoire tout les 5cm
2025-10-19 Enhance graphical display with stop button and texts
    Added a stop button and additional text elements for robot info.
2025-10-19 Add robot movement print statements
2025-10-19 Enhance UI responsiveness with bring_to_front calls
    Added bring_to_front function calls to enhance UI responsiveness during button press and mouse click events.
2025-10-19 Update action processing logic in main.py
    Modify the action handling loop to check for available actions before processing. This prevents the loop from running when there are no actions in the list.
    [main.py]
2025-10-21 Version évitemment de l'ennemi
2025-10-22 Version correcte
    This function checks if an enemy is on the robot's trajectory and adds a waypoint if necessary. It generates tangent points to avoid the enemy while updating the action list.
    [mouvement.py]
2025-10-22 Version en accord avec Mouvement correcte
    Updated the init_affichage function to include a security radius parameter and modified plot colors for better distinction.
    [affichage.py]
2025-10-22 Version évitement de l'ennemi correct
    Refactor robot behavior and enemy avoidance logic. Update action list handling and visualization.
    [main2.py]
2025-10-22 Contrôle à la souris
    Updated robot and enemy coordinates, modified action list structure, and improved battery management display.
2025-10-22 Version Recul
    This script initializes and manages a robot's navigation using Lidar and CAN bus communication. It includes configuration for battery management, obstacle avoidance, and graphical display of the robot's position and actions.
2025-10-23 Version Bon Algo
    Refactor movement logic to include perimeter stopping and intersection detection with circles. Added new functions for calculating stopping points and handling enemy avoidance.
    [mouvement.py]
2025-10-23 Version Bon Algo d'évitement + Refresh tâche
    Refactor CAN communication and update action handling logic. Adjust battery management and improve variable initialization.
2025-10-31 ajout calcul de trajectoire
2025-11-03 Create Déplacement base Lidar
2025-11-03 Create Deplacement + traj base lidar
2025-11-03 Version Algo Astars + GM/Noisettes dynamiques
    [calcul_mouv.py]
2025-11-04 Version Prise de décision
2025-11-04 Version Prise de décision Clean
2025-11-06 Version Reçoit Liste de points
2025-11-07 Update Deplacement + traj base lidar
2025-11-13 Version Prise de décision Clean + Threads pour A*
2025-11-14 Test Threads pour A*
2025-11-14 Version Threads A*
    Added a callback description for click events and removed redundant print statement.
2025-11-14 Version A* Threads
2025-11-14 Update print statement from 'Hello' to 'Goodbye'
2025-11-16 Correction du problème de périmètre de l'ennemi
    [calcul_mouv.py]
2025-11-20 Version A* Threads + Liste_traj
    Added background drawing to the figure canvas in affichage.py.
2025-11-20 Version A* Threads + Liste_traj
2025-11-20 Version A* Threads + Liste_traj
    Removed unnecessary print statements at the end of the test.
2025-11-20 Version A* Threads + Liste_traj
    Removed print statements for dynamic zone updates and noisettes, simplifying the output. Adjusted summary output for modified grids.
2025-11-21 Correction bug envoi Bus CAN
    Updated robot departure settings and modified threading for lidar task.
    [main.py]
2025-11-28 Fonctionne mais lent à cause de la BC
2025-11-28 Update fmt.Println message from 'Hello' to 'Goodbye'
2025-12-06 MAJ Stratégie
    Modification des zones de récupération des zones
    Forçage de la récup Noisette4 au départ
    À combiner avec le programme qui fonctionne sur le robot
    [main.py]
2025-12-12 Update enemy coordinates and threading logic
2025-12-12 Bons emplacements de GM et Noisettes, donc bonne Stratégie
    [main.py]
2025-12-13 Mvt Ennemi, Arrêt si trop proche, reprise de la Traj, bug sur grille ennemi et robot passe trop près de lui
    [main.py]
2025-12-14 Version Bon Algo
    Removed the print statement for 'SUPPRESSION' section.
2025-12-14 Version Bon Algo, Peut être blocage quand proche de périmètre ennemi, pas de décision quand vrmt inacessible
    Refactor various constants and logic for enemy movement and trajectory recalculation.
2025-12-14 Ajout Bouton Start, Text Bat RPI et Text temps
    Added START button to the display alongside the existing STOP button and updated the layout.
2025-12-14 Ajout Bouton Start, Bat RPI et Timer
    Bug : Noisette3 pas prises en bas
    [main.py]
2025-12-19 Update fmt.Println output from 'Hello World'
2025-12-19 Modify Reel state and adjust lidar thread management
    Updated various parameters and modified thread handling for lidar and calculations.
2025-12-19 Implement battery monitoring and CAN communication
    Added functionality to read battery voltage and current using INA236, send data over CAN, and calculate the number of cells based on voltage thresholds.
2025-12-19 Refactor battery usage conditions in fonction.py
2025-12-21 Change camera index from 1 to 0
2026-01-08 Create base lidar safe sans CAN points
2026-01-14 Modify simulation mode and battery management
    Updated simulation settings and battery handling logic.
2026-01-15 Test co ennemi + angle
    Objectif : supprimer le thread inutil
    Ajout :
    - moyennage des coordonnées dans le thread Lidar
    - angle_ennemi quand mvt_ennemi supérieur à seuil
2026-01-16 Update configuration and threading logic in ProgrammeTest
2026-01-16 Rotation et Reculer fonctionne
    Updated color variable and Lidar settings. Adjusted enemy coordinates and added logic for calculating enemy position.
2026-01-20 Refactor lidar point calculation and improve readability
2026-01-20 Implement enemy movement filtering and history tracking
    Added filtering for enemy movement based on historical positions.
2026-01-21 Enable battery competition mode and adjust parameters
2026-01-22 Toggle Lidar_on setting to False
    Changed Lidar_on setting from True to False.
2026-01-24 Mise en place MAJ Noisette
    [main.py]
2026-01-26 Il faut prendre en compte les moments où on récupère ou pas
2026-01-27 Astar en Thread
2026-01-27 Astar désactiver pour récup/lacher Noisette
    [main.py]
2026-01-28 Refactor battery control constants and update CAN messages
2026-02-01 Ajout Point intermédiaire en cas de grosse ligne droite
2026-02-05 Bug corrigé : grp de 2 Noisette fait bug Mode_pince = False
    [main.py]
2026-02-06 Ajout choix de la couleur de l'équipe
2026-02-06 Pour Stratégie = True, ajout des points d'arrivée automatique pour les Noisettes à l'horizontale. Verticales : marche pas, Astar a du mal
    [main.py]
2026-02-07 Remplissage "Liste_actions" pour Attraper, bug avec Astar
    [main.py]
2026-02-08 Points d'arrivée bien créer, Astar bug, pas Retourner, pas GM
    [main.py]
2026-02-08 Postionnement bons, Astar mache, Affichage Noisettes dans robot (affichage.py à modifier), pas de Retourner ni GM
    [affichage.py, main.py]
2026-02-08 Retourner fonctionne, pas de Relacher dans GM
2026-02-09 Début de dépôt GM, uniquement sans Noisette dans GM, et sous_pince == 12, pas de pince Avant/arrière
    [main.py]
2026-02-10 GM fonctionne mieux : pince avant et arrière si GM Vide et sous_pince = 12.. Bug si point d'arrivée dans zone interdite (grénier). Faire sous_pince = 1 ou 2, puis pour GM déjà rempli.
    [affichage.py, main.py]
2026-02-11 GM fait pour sous_pince, pas fait pour Noisette déjà dans GM. Bug, robot recule pas assez pour GM en bas
    [main.py]
2026-02-11 Faire GM si Noisette déjà dedans
    [main.py]
2026-02-12 Ajout Projet Platerfom.io CAN pour Actionneur
2026-02-12 Prêt pour tester les Actionneurs
2026-02-17 Prêt pour tester Carte Batteries : 3 Batteries + Alertes + Interrupteurs + BAU + état carte
2026-02-18 Change ON/OFF definitions and update switch states
2026-02-18 Modify CAN ID list and update data handling
    Updated the list of IDs for CAN reception and modified data unpacking logic for battery states and RPI state. Added sending logic for battery switch states.
2026-02-19 Ajout Programme STM32 Carte Batteries
2026-02-20 Implement CAN message handling for battery control
    Added handling for CAN messages to control battery states and read inputs.
2026-02-20 Update battery and ID lists in ProgrammeTest
2026-02-20 Refactor battery management logic and filters
2026-02-20 Refactor battery voltage checks and update filters
2026-02-20 Add header file and define constants for battery states
2026-02-22 Association Noisette aveugle avec Noisette cam
    [main.py]
2026-02-23 Noisette Groupee pour 1/2/3/4
    [main.py]
2026-02-24 Refactor MessageErreur and add error handling
    Removed preprocessor definitions for various constants related to battery and robot control. Added error handling for unpacking data in the LectureCAN function.
2026-02-24 Refactor robot configuration and action logic
    Updated various configurations and logic for robot actions, including enabling simulation movement and modifying enemy coordinates. Added imports and adjusted battery management variables.
2026-02-24 Refactor action list and print statements
    Updated action list and modified print statements for better clarity.
2026-02-25 Camera, Sans WiFi
2026-02-25 WiFi fonctionne dans les deux sens
2026-02-25 Pince fonctionne, Jack fonctionne, WiFi fonctionne dans les deux sens
2026-03-01 RPI decharge False pour Bat_Compet True, j'ai enlevé les Noisettes_groupees de 4
    [main.py]
2026-03-06 Réglagle bug Stratégie Retourner, Départ Coller au grenier, sortir zone interdite
    [fichier_strategie.py, main.py]
2026-03-08 Stratégie : Relacher dans GM, refontre "mode_attraper", introduction de "Liste_strategie"
2026-03-09 Début de dépôt dans le nid
2026-03-09 Retour au nid + Noisettes dans le nid
    [fichier_strategie.py, main.py]
2026-03-09 Bug Strat Nid : crash si Strat dans nid et pas de Noisettes dans le robot : réglé
    [fichier_strategie.py, main.py]
2026-03-10 Fix variable initialization and type casting
    [main.py]
2026-03-12 Update LIDAR buffer size and robot position handling
    Increased LIDAR buffer size and updated robot position variables for calculations.
2026-03-12 Implement A* trajectory calculation with threading
    Added functions for A* trajectory calculation and threading.
2026-03-12 test Lidar
2026-03-12 Début d'intégration de Astar en Thread
2026-03-13 CAN fonctionne avec carte Odo/Asserv
    Updated the robot's initial angle and modified data packing for CAN messages. Adjusted threading for A* calculations and refined the sending of acknowledgment messages.
2026-03-13 Enable Lidar and adjust robot angle for start
2026-03-13 Nouveau Lidar à tester
2026-03-16 Modif Thread Astar, test nouveau Lidar
2026-03-16 test nouveau lidar
2026-03-16 test nouveau lidar en cours
2026-03-18 Coordonnées de départ comme avant, sinon bug et pas pratique dans la carte asserv
    [main.py]
2026-03-19 Simul action déplacés dans les verifs à la fin
2026-03-19 Ajout premier affichage des Noisettes
    [main.py]
2026-03-19 Astar en Thread : pas fiable ) 100%
2026-03-20 Astar Thread qqlq bug mais fonctionne, arangement des variables en haut du programme
    [main.py]
2026-03-23 Lidar S2 avec synchronisation
2026-03-23 Tester les 2 pinces
2026-03-25 Ajout coefficient de correction caméra en X, caméra côté jaune
    [main.py]
2026-03-26 Modif affichage des infos sur la BC
2026-03-26 Enlever print dans homographie_couleur
2026-03-26 Ajout timer dans BC en lien avec le Robot
2026-03-29 Modif Stratégie et Lidar
2026-03-29 Modif Astar avec Lidar
2026-03-30 test Lidar + Astar
2026-03-31 Modif Stratégie : Pas de recul après Noisette si prochaine stratégie = Noisette
    [fichier_strategie.py]
2026-03-31 Modif stratégie : déplacements devant GM
    [players_scores.xlsx]
2026-04-01 lancement des cartes
2026-04-01 Stratégie : modif angle pour Relacher avec Noisette déjà dans GM
    [fichier_strategie.py, main.py]
2026-04-01 Mouvement Astar : Retourner se fait toujours, il fallait le mettre dans mode_attraper
2026-04-02 J'ai enlevé le déplacement de l'ennemi
2026-04-03 ajout recalage initial, modif coordonnées de départ, while principal plus de Liste_actions dans la condition
2026-04-03 Coordonnées de départ comme avant, car peux pas lever les pinces
2026-04-03 Ajout print pendant le recaalage, et variable On Off Recalage
2026-04-03 Modif coordonnées de départ, de sorti grenier, et de retour
2026-04-03 modif coordonnées Noisettes cam en fonction de la zone pour Bleu
    [main.py]
2026-04-03 Pour fin du match, l'action de stratégie se termine quand même, coordonnées de départ donc sortir grenier désactiver
2026-04-04 sortie Astar Noisette et Grenier, pas ennemi
    [main.py]
2026-04-05 Ajout de la strat actuelle remise à la fin
2026-04-05 Ajout de la strat actuelle mise à la fin si échec, et sortie de case interdite plus loin
2026-04-05 Recul ennemi avec gestion de la direction mais sans verif grille, anglre robot mieux en simu
2026-04-06 Tentative d'ajout de verif grille mais sans direction
2026-04-06 retour au nid moins restrictif mais fini pas la stratégie, GM décalé sur les côtés
2026-04-09 modif ordre tag calibration
2026-04-09 modif couleur texte pour calibration plans
2026-04-12 bug fix : action n'était pas supprimée lors de l'échapement du robot adverse
    [main.py]
2026-04-13 Stratégie débute après Noisette toutes reconnues à l'init
    [main.py]
2026-04-13 Arrêt devant Ennemi plus simple, réduction de la zone de sécurité autour des Noisettes
    [main.py]
2026-04-14 intégration Lidar S2
2026-04-15 Astar Thread fonctionne sur le robot
2026-04-16 modif coordonnées de dépôts dans GM
2026-04-16 Lidar fonctionne un peu : perte d'octet, juste Lidar en Process
2026-04-19 modif longueur robot, début ajout MAJ Noisette
    [main.py]
2026-04-19 moins d'actions pour relacher dans GM qui n'avait pas encore de Noisettes, modif mode_attraper
    [fichier_strategie.py, main.py]
2026-04-25 retour au nid ne bug plus si robot dans zone interdite
    [main.py]
2026-04-25 Intégration nouveau Lidar en cours
2026-04-25 Lidar fonctionne presque, ajout var "affichage"
2026-04-25 Lidar fonctionne, delai d'une seconde
2026-04-26 BC : comm pour les 7 PAMI à tester
2026-05-01 Lidar : détection robot adverse fonctionne peut-être pas si robot en mouvement
2026-05-01 symétrie position de départ à tester
2026-05-02 HOMOLOGATION OK, LIDAR FONCTIONNE
2026-05-02 Ajout pousser Ninja, réduction de la zone interdite autour du grenier
2026-05-02 MAJ Noisettes bien, marche moyen si Noisettes juste cachées par adverse
    [main.py]
2026-05-03 bug de MAJ stratégie à cause du curseur : réglé
    [main.py]
2026-05-03 bug MAJ stratégie Curseur, robot faisait une fois l'action, réglé avec Astar_a_fail = True
    [main.py]
2026-05-03 tentative d'ajout de strat agressive, clean code
2026-05-04 MIN_CLEARANCE = 2.0 au lieu de 3.0, strat agressive des 2 côtés
2026-05-04 R_ROBOT-30 pour obs_manager_noisettes, Stratégie agressive des 2 côtés à tester
2026-05-05 modif calibration plan Noisette
    [homographie_couleur.py, main.py]
2026-05-08 refonte de la logique de déplacement, d'évittement, de nouvelle strat (curseur delete btw)
2026-05-10 clean print
2026-05-10 clean code print
2026-05-10 les 2 stratégies fonctionnent en Simu, des 2 côtés, avec/sans pousser, sans ennemi en mvt
2026-05-10 bug réglé : vérif angle ajoutée pour aller attraper Noisette si robot très proche
    [fichier_strategie.py, main.py]
2026-05-12 plus de première rotation pour prendre Noisettes
    [fichier_strategie.py]
2026-05-12 modif coordonnées de départ
2026-05-13 Lidar en cours
2026-05-13 Lidar : homologué, R_ENNEMI = 350
2026-05-14 on retourne plus car pas de couleur cam
2026-05-14 détection noisettes comme avant
    [homographie_couleur.py]
2026-05-14 BC : nouvelle détection des Noisettes
    [homographie_couleur.py, main.py, main_bc.py]
2026-05-14 robot : nouvelle association des Noisettes
    [homographie_couleur.py, main.py]
2026-05-14 bug corrigé : retour sans Astar si vient de déposer
    [main.py]
2026-05-15 tentative de pousser
2026-05-16 strat pousser : à tester les deux
2026-09-04 Réorganisation des dossiers
2026-09-27 Ajout du contenu de Prog_Actionneurs et Prog_Asserv, exclusion de .pio
    [0603 SMD Resistor.stp, 0603-C.STEP, 110990030.step, 292161-4.step, BNC.SLDPRT, BNC.STEP, C_Rect_L10.0mm_W3.0mm_P7.50mm.SLDPRT, C_Rect_L10.0mm_W3.0mm_P7.50mm.STEP]
2026-09-29 Fix: suppression du sous-module accidentel, ajout du contenu de Prog_Carte_puissance_crac
    [0603 SMD Resistor.stp, 0603-C.STEP, 110990030.step, 292161-4.step, Assemblage carte puissance 2025.SLDASM, BNC.SLDPRT, BNC.STEP, Boitier_Carte_puissance(1).SLDPRT]
2026-09-29 Ajout du programme PAMI
    [max_app_8MB.csv]
