Achille-92/CRAC2026/(notices)

Notices in the files:
Carte_Alim/Prog_Carte_puissance_crac/Kicad Carte_puissance_crac_Indus/LibGe2/3D/FTSH-105-01-L-DV-K.step:
author */ ('License CC BY-ND 4.0'),
